mattvenn/gf-433-oscillator/docs/schematics.md

# Schematics



The VCO as real xschem schematics, generated from Python in `xschem/gen/` (one generator per block, `python3 xschem/gen/all.py` rebuilds them all). Every size and multiplicity is read from `sim/vco/vco_bias.py`'s `netlist()` at the chosen design, so the schematics can't drift from what I simulated:

- the winner reference (`sim/results/2026-11-08/winner_sets.txt`) with lnw = 5.023 µm;
- plus `topo=cfed kc=0.75 k=6 cvg=3e-12 ka=16 wfu=0.30 wff=0.30 rf=1e6 cf=20e-12`.

Click a schematic to open it in the online xschem viewer, or a layout to open it in the Tiny Tapeout 3D GDS viewer. Previews (SVG and PNG, rendered headless by `xschem/gen/render.sh`) are in `docs/img/xschem/`.

| Block | Schematic | Layout (3D) | What it is |
|---|---|---|---|
| **Tile** `tt_um_mattvenn_gf433_vco` | – (LVS source from `lvs/make_source.py`) | [tt_um_mattvenn_gf433_vco.gds](https://gds-viewer.tinytapeout.com/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) | the 2x2 Tiny Tapeout tile: vco_top, tx_drv and the wrapper routes |
| vco_top | [vco_top](https://xschem-viewer.com/?file=https://github.com/mattvenn/gf-433-oscillator/blob/main/xschem/vco_top.sch) | [vco_top.gds](https://gds-viewer.tinytapeout.com/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) | the VCO as laid out: ring_core_v3 + cgm_ref + lsdiv + the VDD_LS decap |
| mdac | [mdac](https://xschem-viewer.com/?file=https://github.com/mattvenn/gf-433-oscillator/blob/main/xschem/mdac.sch) | [mdac.gds](https://gds-viewer.tinytapeout.com/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) | medium DAC for fine tuning: 5 unary + 5 binary + the sigma-delta cell, PMOS current steering onto vg (docs/tx_fine_tune.md) |
| vctrl_pd | – (one resistor, in `lvs/make_source.py`) | [vctrl_pd.gds](https://gds-viewer.tinytapeout.com/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) | 200 kΩ ppolyf_u_1k from vctrl to VSS: the fine leg is off unless ua[0] drives it |
| tx_fine (digital macro) | – (Verilog `src/tx_fine.v`) | [tx_fine.gds](https://gds-viewer.tinytapeout.com/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) | SPI register, FSK offset, sigma-delta, thermometer decode, ÷16 / ÷64 / ÷1024 and the ck gate (LibreLane) |
| vco_cfed | [vco_cfed](https://xschem-viewer.com/?file=https://github.com/mattvenn/gf-433-oscillator/blob/main/xschem/vco_cfed.sch) | – (laid out as vco_top) | the whole VCO as simulated in `vco_bias`, without lsdiv |
| cgm_ref | [cgm_ref](https://xschem-viewer.com/?file=https://github.com/mattvenn/gf-433-oscillator/blob/main/xschem/cgm_ref.sch) | [cgm_ref.gds](https://gds-viewer.tinytapeout.com/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) | constant-gm reference and the 1 MΩ / 20 pF filter |
| ring_core_v3 | [ring_core_v3](https://xschem-viewer.com/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) | [ring_core_v3.gds](https://gds-viewer.tinytapeout.com/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) | ring + DAC + vg decap |
| ↳ cfed_ring | [cfed_ring](https://xschem-viewer.com/?file=https://github.com/mattvenn/gf-433-oscillator/blob/main/xschem/cfed_ring.sch) | in [ring_core_v3](https://gds-viewer.tinytapeout.com/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) | the 5 inverters |
| ↳ cfed_dac | [cfed_dac](https://xschem-viewer.com/?file=https://github.com/mattvenn/gf-433-oscillator/blob/main/xschem/cfed_dac.sch) | in [ring_core_v3](https://gds-viewer.tinytapeout.com/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) | the coarse current DAC and the fine leg |
| lsdiv | [lsdiv](https://xschem-viewer.com/?file=https://github.com/mattvenn/gf-433-oscillator/blob/main/xschem/lsdiv.sch) | [lsdiv.gds](https://gds-viewer.tinytapeout.com/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) | level shifter, TSPC ÷4 and clock buffer |
| ↳ ls_ac | [ls_ac](https://xschem-viewer.com/?file=https://github.com/mattvenn/gf-433-oscillator/blob/main/xschem/ls_ac.sch) | in [lsdiv](https://gds-viewer.tinytapeout.com/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) | the AC-coupled level shifter |
| ↳ tspc_t1, tspc_t2 | [tspc_t1](https://xschem-viewer.com/?file=https://github.com/mattvenn/gf-433-oscillator/blob/main/xschem/tspc_t1.sch), [tspc_t2](https://xschem-viewer.com/?file=https://github.com/mattvenn/gf-433-oscillator/blob/main/xschem/tspc_t2.sch) | in [lsdiv](https://gds-viewer.tinytapeout.com/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) | TSPC ÷2 flip-flops |
| tx_drv | [tx_drv](https://xschem-viewer.com/?file=https://github.com/mattvenn/gf-433-oscillator/blob/main/xschem/tx_drv.sch) | [tx_drv.gds](https://gds-viewer.tinytapeout.com/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) | the dipole TX driver |
| ↳ tx_split, tx_arm | [tx_split](https://xschem-viewer.com/?file=https://github.com/mattvenn/gf-433-oscillator/blob/main/xschem/tx_split.sch), [tx_arm](https://xschem-viewer.com/?file=https://github.com/mattvenn/gf-433-oscillator/blob/main/xschem/tx_arm.sch) | in [tx_drv](https://gds-viewer.tinytapeout.com/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) | phase splitter; one output arm |
| pad_model_gf180 | [pad_model_gf180](https://xschem-viewer.com/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) | – (TT's pin, not our layout) | one TT GF180 analog pin, for simulation |
| ↳ tt_asw_5v0, lv2hv | [tt_asw_5v0](https://xschem-viewer.com/?file=https://github.com/mattvenn/gf-433-oscillator/blob/main/xschem/tt_asw_5v0.sch), [lv2hv](https://xschem-viewer.com/?file=https://github.com/mattvenn/gf-433-oscillator/blob/main/xschem/lv2hv.sch) | – | tnt's analog switch and its level shifter, redrawn |

## Block details

- **vco_top**: the VCO top level as laid out in `layout/vco_top.gds`, and the LVS source of `layout/gen/check_top.sh`. ring_core_v3 driven by cgm_ref (vbnf to the DAC gate), lsdiv on a0 with its own supply VDD_LS, and the VDD_LS decap DCLS (nfet_03v3 gate cap, sized as drawn by `layout/gen/vco_top.py`). Ports: VDD, VDD_LS, VSS, vctrl, bit0-4, bitb0-4, ck (a0 / 4), a0, vbn (monitor), vg (monitor) and ls (the TX driver's tap).
- [vco_cfed](https://xschem-viewer.com/?file=https://github.com/mattvenn/gf-433-oscillator/blob/main/xschem/vco_cfed.sch): the whole VCO - the constant-gm reference drives the ring core through the 1 MΩ / 20 pF filter (vbnf).
- [cgm_ref](https://xschem-viewer.com/?file=https://github.com/mattvenn/gf-433-oscillator/blob/main/xschem/cgm_ref.sch): the constant-gm (beta-multiplier) reference - MN1/MN2 as 14 × 14 series-parallel arrays (each drawn as one vector instance), the 56/14 µm PMOS mirror, the n-well + n+ resistor, the 3-transistor start-up and the RC filter to vbnf.
- [ring_core_v3](https://xschem-viewer.com/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): the ring, the DAC and the vg decap (pfet_03v3 to VDD, 6 × 29.82/4.12 µm, as drawn in the layout; nfet_03v3 to VSS before 2026-11-12). This is the cell in `layout/ring_core_v3.gds`, so it can be its LVS source.
- [cfed_ring](https://xschem-viewer.com/?file=https://github.com/mattvenn/gf-433-oscillator/blob/main/xschem/cfed_ring.sch): the 5 inverters (P 5/0.28 µm, N 2/0.28 µm). Every NMOS source sits on the shared node vg.
- [cfed_dac](https://xschem-viewer.com/?file=https://github.com/mattvenn/gf-433-oscillator/blob/main/xschem/cfed_dac.sch): the current DAC from vg to VSS - the base leg (× 6 units), the binary coarse legs (× 1 to × 16), the fine leg on vctrl, and the 5 coarse gate switches. Each switch is drawn as a textbook transmission gate standing upright (TP and TN side by side, vbnf in at the top, the gates in from the sides: bitb with its bubble on the left, bit on the right) that connects the leg's gate to vbnf when the bit is 1, plus the pull-down TD that holds the gate at VSS when the bit is 0.
- [lsdiv](https://xschem-viewer.com/?file=https://github.com/mattvenn/gf-433-oscillator/blob/main/xschem/lsdiv.sch): the a0 level shifter, the TSPC ÷4 and the clock buffer B1 (ck = f(a0) / 4, full rail). Source: `sim/lsdiv/lsdiv.py block()`; design in `docs/lsdiv_design.md`.
  - [ls_ac](https://xschem-viewer.com/?file=https://github.com/mattvenn/gf-433-oscillator/blob/main/xschem/ls_ac.sch): Cc (2 fF metal-finger cap, drawn as an ideal C) into INV1-3; R1 / C1 low-pass the output back to INV1's input through LRB (negative DC feedback, duty about 50 %).
  - [tspc_t1](https://xschem-viewer.com/?file=https://github.com/mattvenn/gf-433-oscillator/blob/main/xschem/tspc_t1.sch) and [tspc_t2](https://xschem-viewer.com/?file=https://github.com/mattvenn/gf-433-oscillator/blob/main/xschem/tspc_t2.sch): TSPC toggle flip-flops (÷2 each), 1/2 µm and 0.6/1.2 µm.
- [tx_drv](https://xschem-viewer.com/?file=https://github.com/mattvenn/gf-433-oscillator/blob/main/xschem/tx_drv.sch): the dipole TX driver - lsdiv's `ls` node into the phase splitter, then two arms in antiphase (out_p, out_n), each with its own enable, plus the supply decap DC. VDD here is the driver's own supply (VDPWR). Source: `sim/tx/tx_drv.py block()`. Sizes from the block sims (`sim/tx/tb_tx_drv.py`, results in `sim/tx/results/block_sch.txt`): the final stage at the knee of P into the dipole against supply current, B1 tuned for a fundamental phase error of about 0.05° at tt, and a decap of about 9.8 pF. Devices wider than 10 µm are drawn as m fingers of at most 10 µm (the models stop at W 100 µm).
  - [tx_split](https://xschem-viewer.com/?file=https://github.com/mattvenn/gf-433-oscillator/blob/main/xschem/tx_split.sch): the tap inverter T (the only load on `ls`), then a = A2(A1(t)) and b = TG(B1(t)): one path has two inverters, the other one inverter and an always-on transmission gate that stands in for the second inverter's delay. A weak cross-coupled pair (XA / XB) pulls the two edges together.
  - [tx_arm](https://xschem-viewer.com/?file=https://github.com/mattvenn/gf-433-oscillator/blob/main/xschem/tx_arm.sch): one arm, out = in & en: a NAND2, then 5 inverters tapering ×4 up to the output stage (N 40 / P 100 µm, L 0.28). en = 0 holds out low, so with both arms off there is no DC across the dipole. Ported from ook-asic-radio's `tx_drv` onto 3.3 V devices.
- [pad_model_gf180](https://xschem-viewer.com/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): one TT GF180 analog pin, board pin to `ua[]` (`docs/pad_model.md`). Generated by `xschem/gen/pad_model.py`, checked by `sim/pad/check_xsch.py` (simulation against `sim/pad/pad_model_gf180.spice`).
  - [tt_asw_5v0](https://xschem-viewer.com/?file=https://github.com/mattvenn/gf-433-oscillator/blob/main/xschem/tt_asw_5v0.sch) and [lv2hv](https://xschem-viewer.com/?file=https://github.com/mattvenn/gf-433-oscillator/blob/main/xschem/lv2hv.sch): tnt's analog switch and its level shifter, redrawn.

## Notes
- **GF180 symbols:** the viewer only knows the xschem, sky130 and IHP libraries. So I copied the 5 PDK symbols I use into `xschem/symbols/` (from open_pdks 7b70722e). The schematics reference them as `symbols/nfet_03v3.sym`, the same name xschem finds in the PDK, and the viewer finds them next to the `.sch`.
- **Filter resistor:** RF is `ppolyf_u_1k`, 1 × 970 µm for 1 MΩ: the run's hi-res poly is 1 kΩ/sq (`docs/platform.md`). It was ppolyf_u_3k (1 × 318 µm) before 2026-11-08.
- **Ideal parts:** the 20 pF filter cap is ideal (`devices/capa.sym`), the same as in `vco_bias`. On silicon it will be a MOS cap, which isn't laid out yet.
- **What isn't drawn:** vco_bias's 1 Ω `Rvbn`, which only gives n1 the name vbn, is just the net vbn here. The wiring caps `Cw*` are left out too.
- **The bit buses:** they are separate pins (bit0…bit4, bitb0…bitb4), so the names match the layout's pins.

## Checks (`python3 xschem/gen/check.py`, results in `build/xsch/check.txt`)
Every `.sch` is netlisted headless with xschem (`xschem/gen/netlist.sh`) and compared with netgen, using the gf180mcuD setup:
- **ring_core_v3 against the layout's LVS source:** it matches uniquely with no property errors. I checked it at wfu 0.30 against `layout/gen/export_core_v3.py` and against the committed `layout/ref/ring_core_v3.spice`.
- **The layout against ring_core_v3:** this netlist is the LVS source of `layout/ring_core_v3.gds` (`layout/gen/check_v3.sh`). It matches uniquely with no property errors, and three deliberately broken copies (one DAC leg's m, one switch gate, the decap's S/D on VSS) all fail.
- **vco_cfed against `vco_bias.netlist()`:** it matches uniquely with no property errors (70 devices). netgen treats the PDK resistors as black boxes and doesn't compare their sizes, so a device-by-device size diff covers every W/L/m, resistor W/L and C value. It finds no differences.
- **lsdiv against `lsdiv.py block()`:** it matches uniquely (34 devices), and the device-by-device size diff finds no differences. A copy with R1 10 % longer fails the size diff, as it should (netgen alone would miss it).
- **tx_drv against `sim/tx/tx_drv.py block()`:** it matches uniquely, hierarchy and all (tx_split, tx_arm, tx_drv), and the device-by-device size diff finds no differences (29 devices). The size diff now joins SPICE continuation lines: xschem wraps long device lines, and a wrapped `m=3` was being missed (netgen read it correctly). Two broken copies both fail: the output NMOS M5n 10 % narrower (netgen property error and the size diff), and TGn's gate on VSS instead of VDD (netgen: the netlists don't match).
- **Mutation test:** in a copy of cfed_dac.sch I changed the bit-3 leg from m = 8 to m = 7. All 3 comparisons fail on it, as they should.
- **Simulation:** I simulated vco_cfed from the xschem netlist at tt, 27 °C, code 9 and vctrl 1.65 V, with the same deck as vco_bias. It runs at 503.98 MHz, against 504.16 MHz for vco_bias (-0.036 %). Both draw 0.451 mW and both have vbn = 1.232 V. vco_bias here has its wiring caps off, so like for like.
- **Measurement threshold:** I measured the frequency at mid-swing, not at VDD/2. The cfed ring swings from vg (about 1.8 V) up to VDD, so a0 never crosses 1.65 V. That makes `vco_bias.deck()`'s VDD/2 measurement fail for cfed, and `topo_cmp.py` uses mid-swing too.

## Superseded
The layouts `layout/ring_core.gds` and `layout/ring_core_v2.gds` are earlier versions of ring_core_v3. These hand-drawn SVGs in `docs/schematic/` came before the xschem schematics. I've kept them, but the xschem files are the reference now:
- `ring_stage.svg`, `ring_loop.svg`, `ring_bias.svg` (with `ring_svg.py`)
- `dac_cfed.svg` (with `dac_svg.py`)
