mattvenn/gf-433-oscillator/bench/2026-11-09/raw/chip2/chip2_check.png

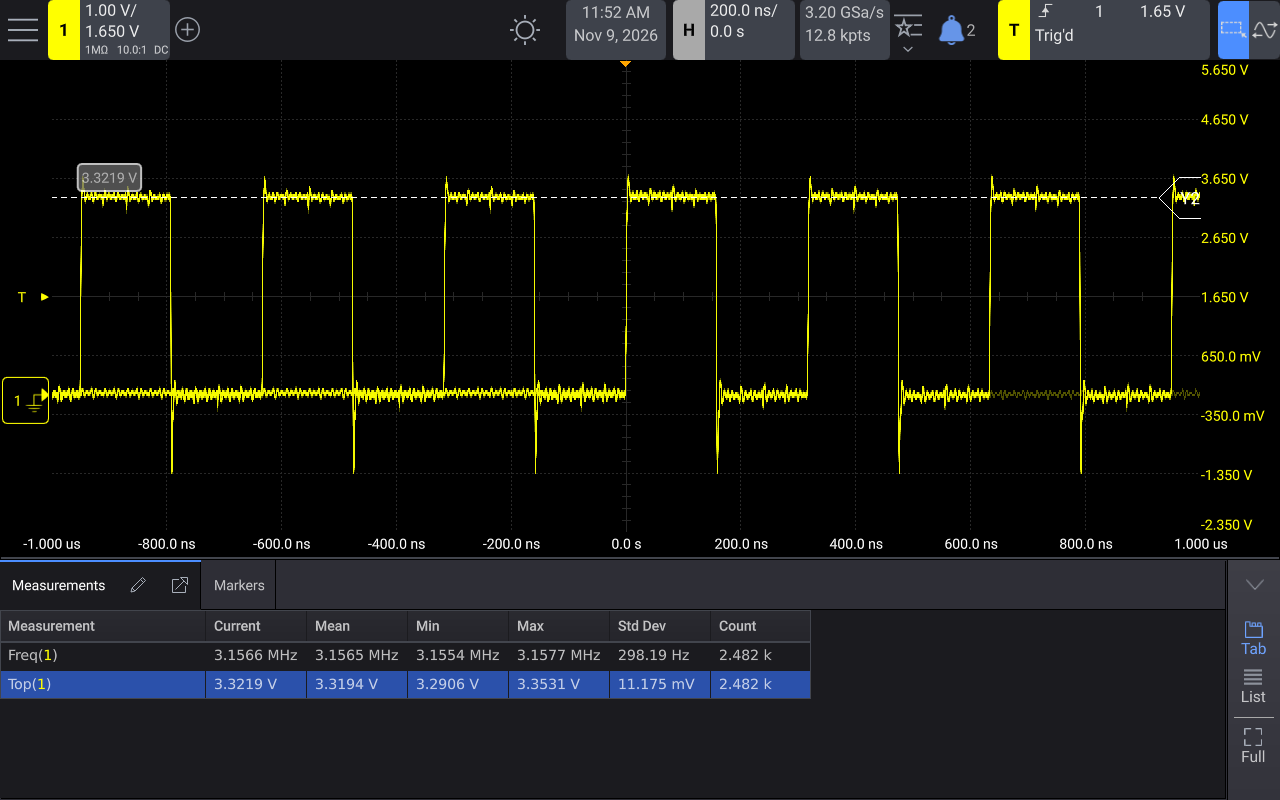
bench/2026-11-09/raw/chip2/chip2_check.png
