mattvenn/gf-433-oscillator/bench/2026-11-09/raw/d8_inv4x5.png

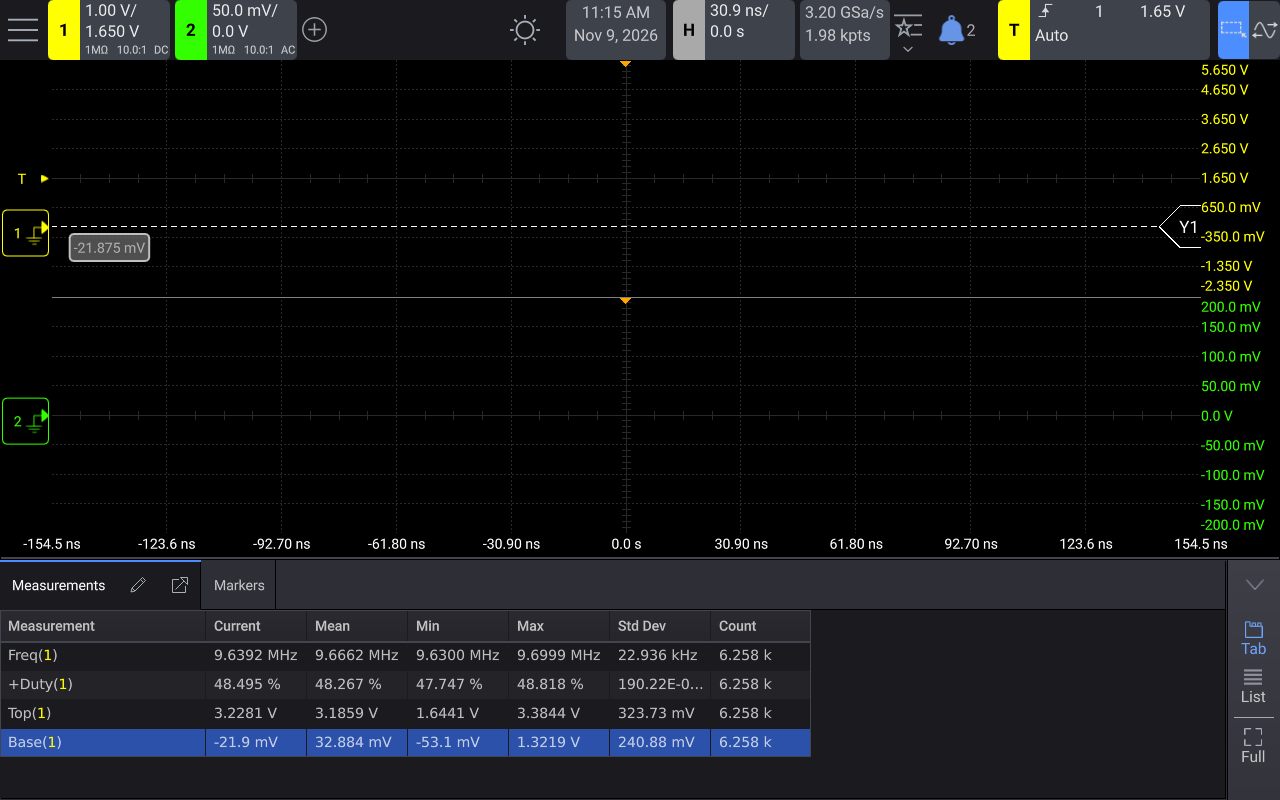
bench/2026-11-09/raw/d8_inv4x5.png
