mattvenn/gf-433-oscillator/bench/2026-11-09/raw/fin_inv4x5_0.png

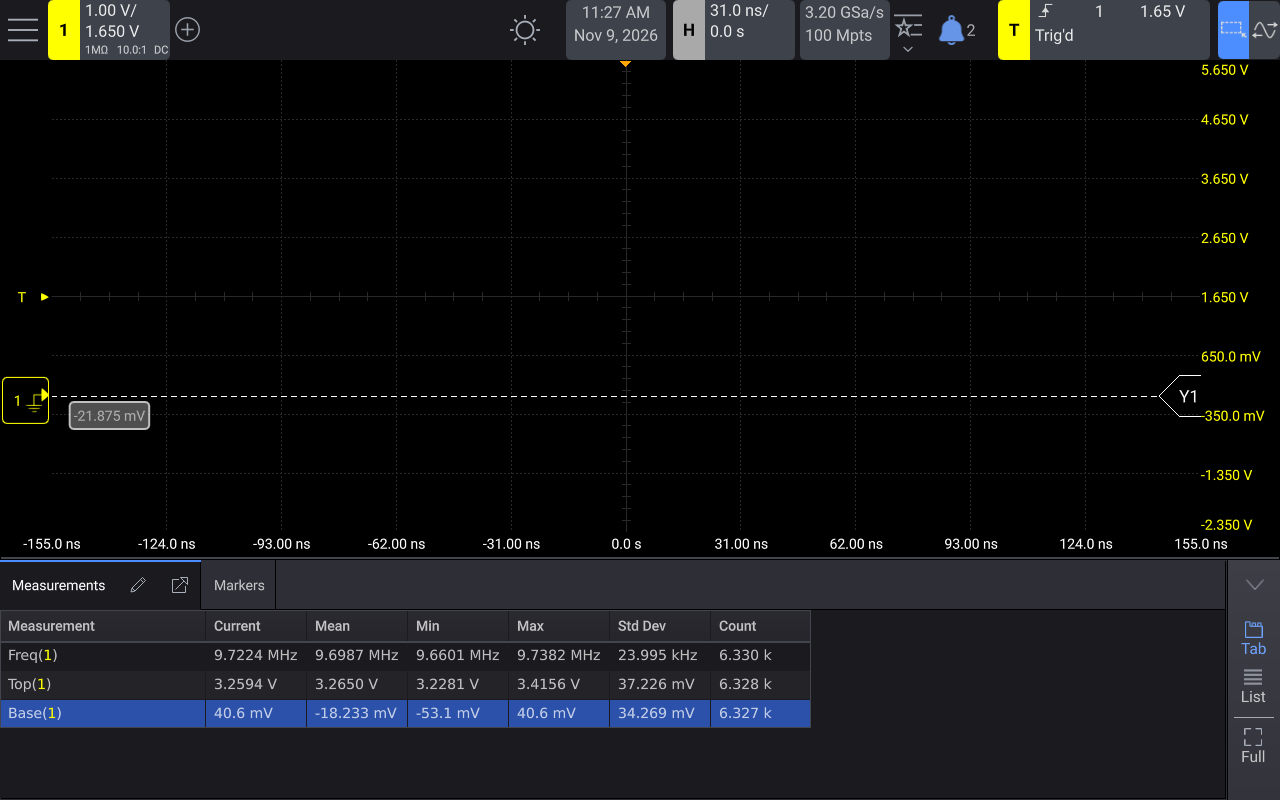
bench/2026-11-09/raw/fin_inv4x5_0.png
