mattvenn/gf-433-oscillator/bench/2026-11-09/raw/fin_notclk_0.png

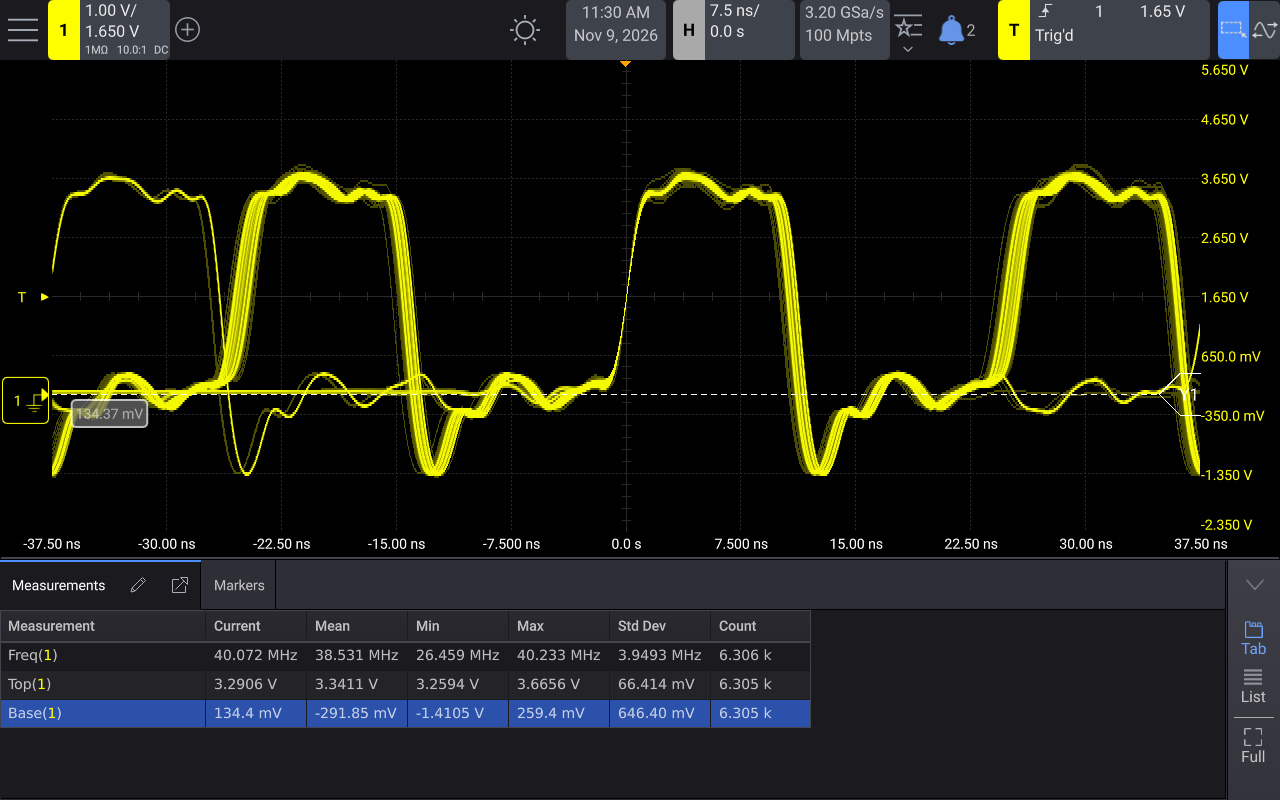
bench/2026-11-09/raw/fin_notclk_0.png
