mattvenn/gf-433-oscillator/bench/2026-11-09/raw/ref_13M56_frac.png

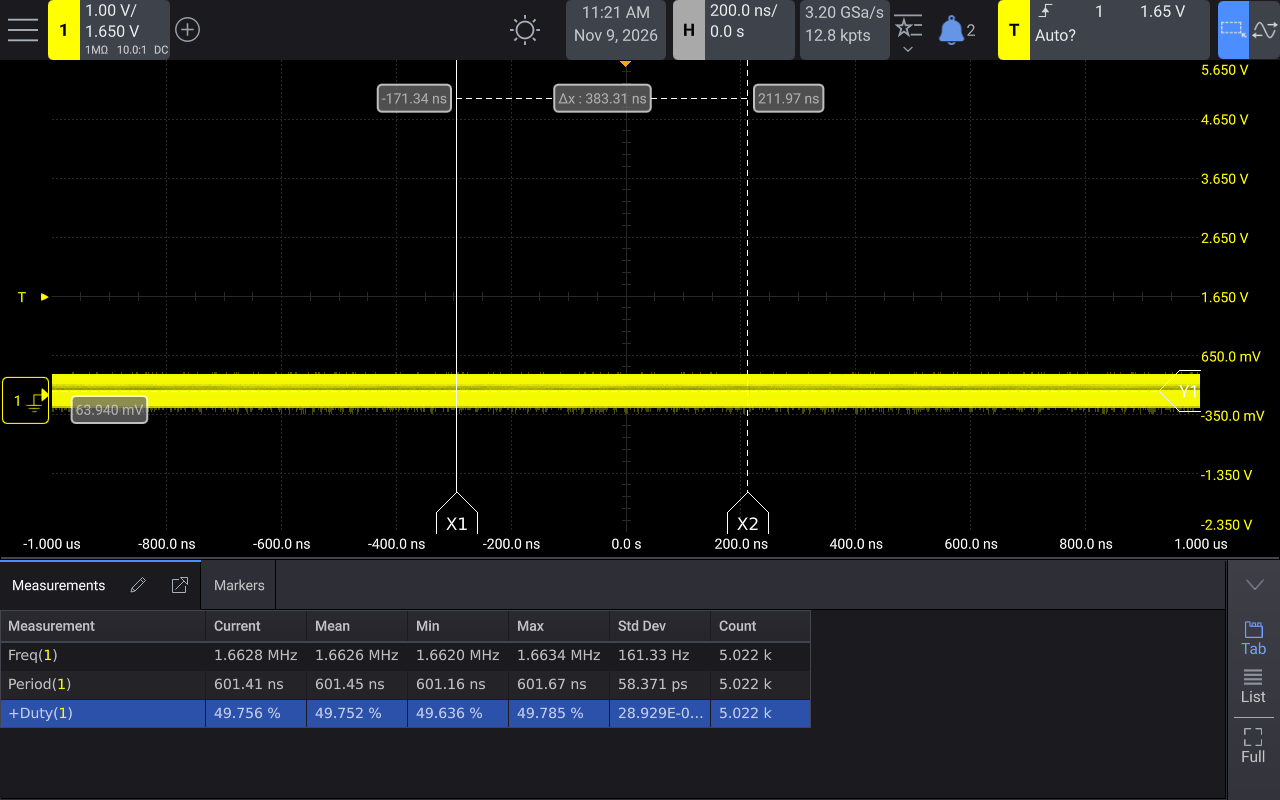
bench/2026-11-09/raw/ref_13M56_frac.png
