mattvenn/gf-433-oscillator/bench/2026-11-09/raw/ref_frac_13M6.png

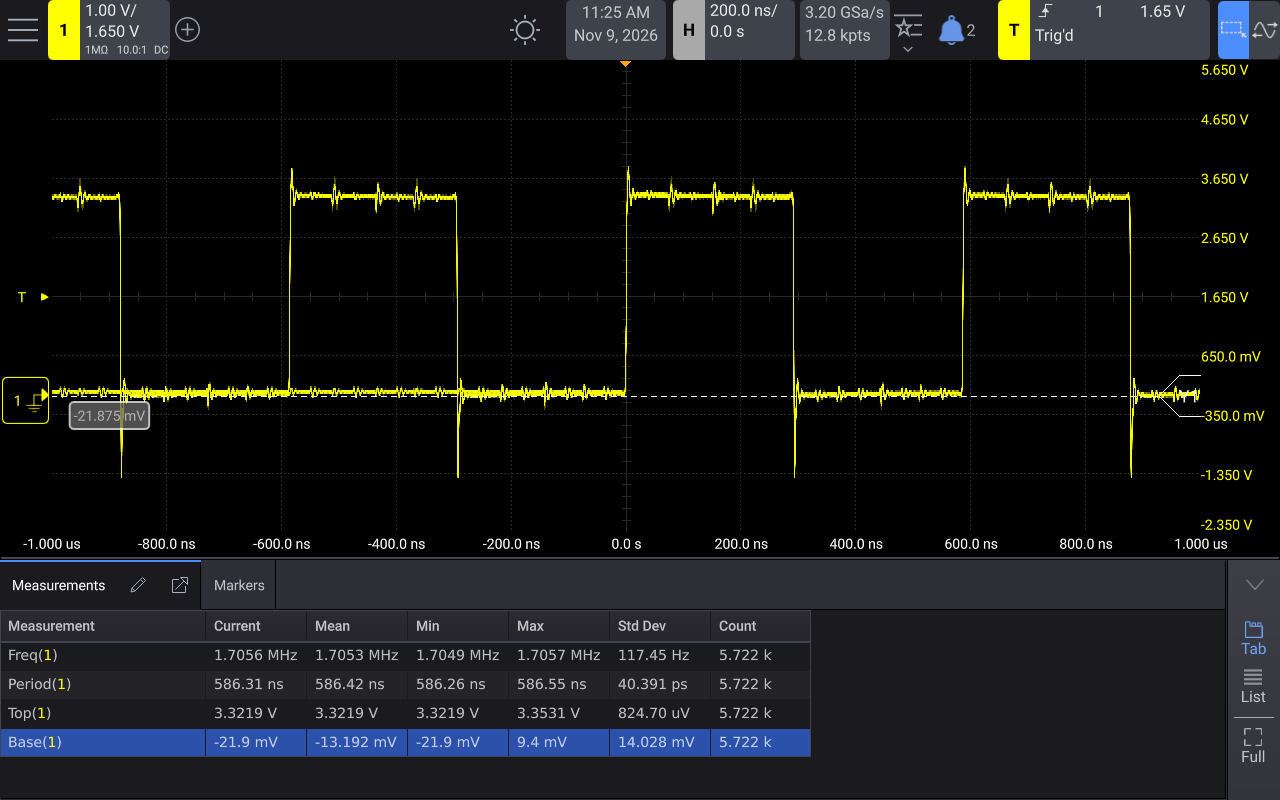
bench/2026-11-09/raw/ref_frac_13M6.png
