mattvenn/gf-433-oscillator/bench/2026-11-09/raw/ref_int_27M12.png

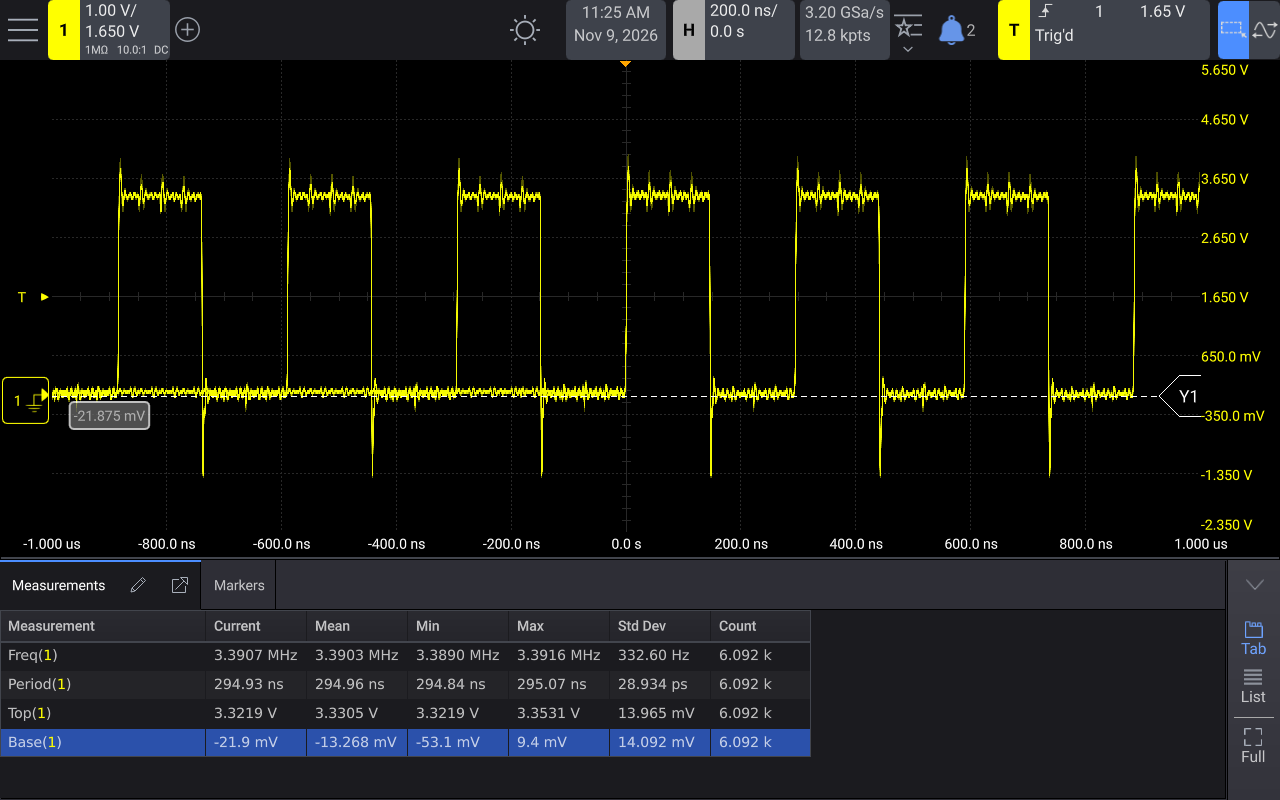
bench/2026-11-09/raw/ref_int_27M12.png
