mattvenn/gf-433-oscillator/bench/2026-11-09/raw/scope_floor_bw20.png

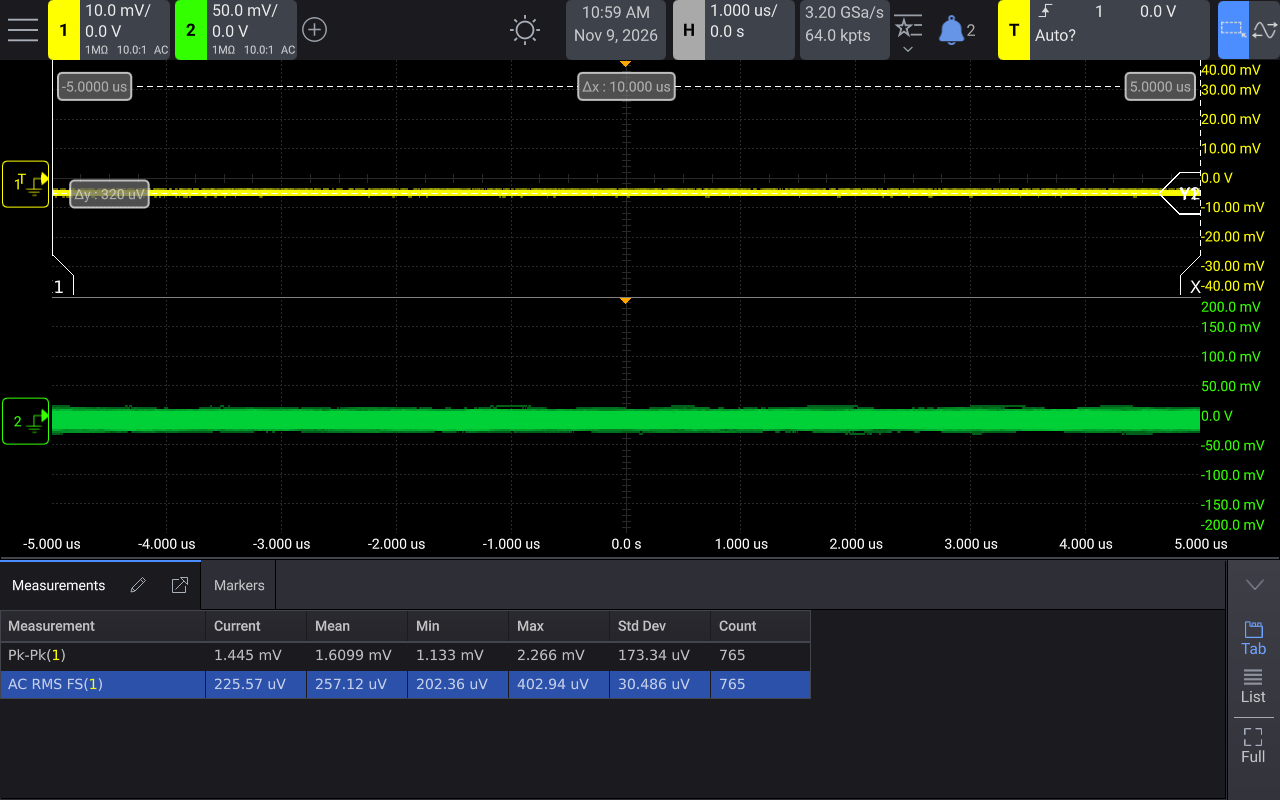
bench/2026-11-09/raw/scope_floor_bw20.png
