mattvenn/gf-433-oscillator/bench/2026-11-09/raw/scope_vdcore_ac.png

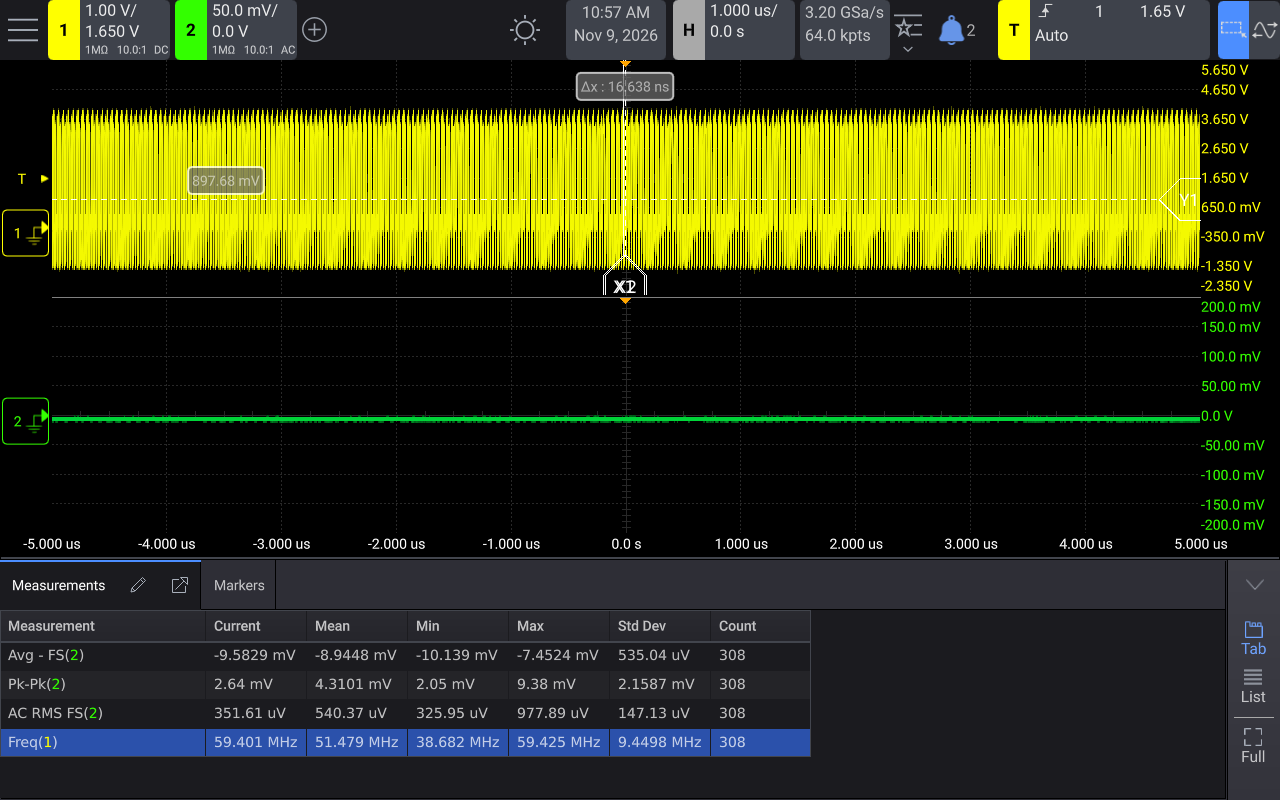
bench/2026-11-09/raw/scope_vdcore_ac.png
