mattvenn/gf-433-oscillator/docs/img/ring_core.png

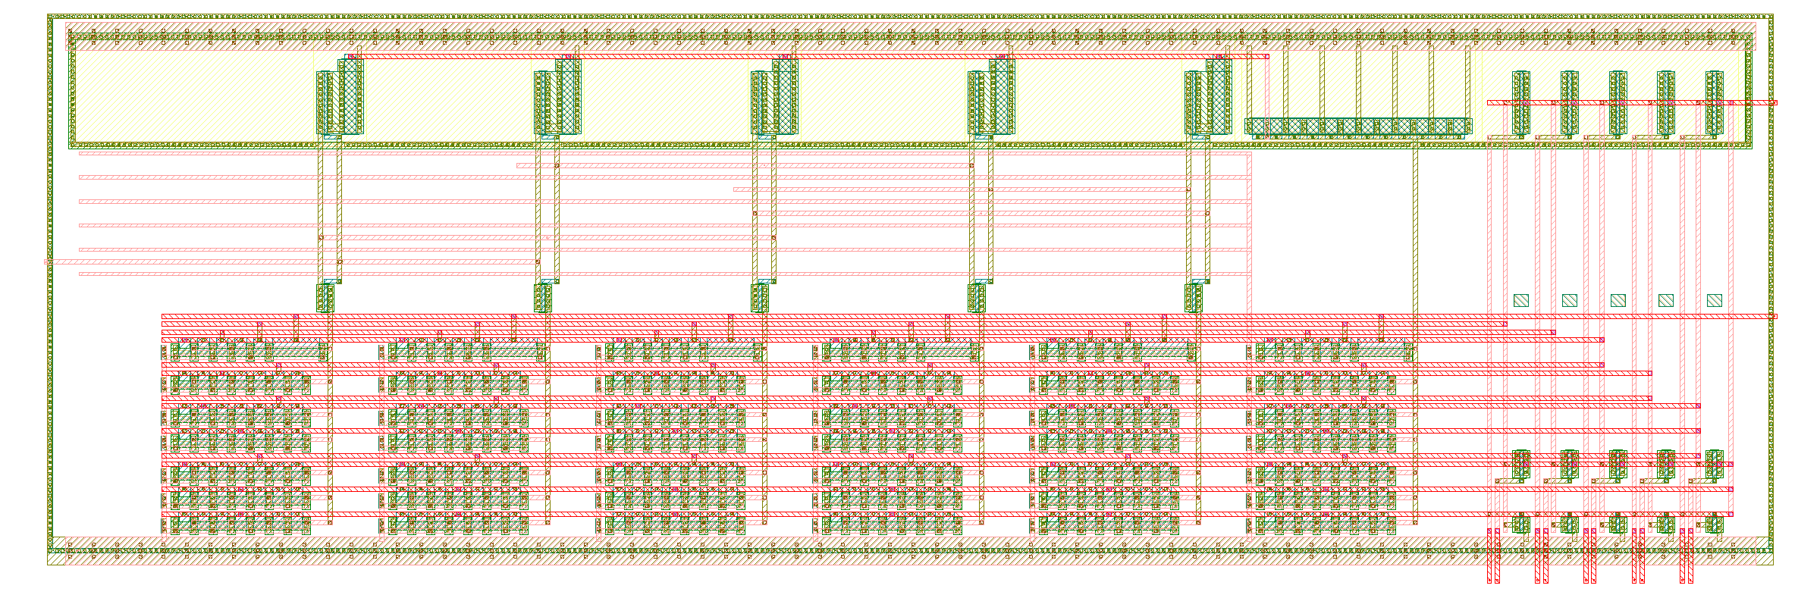
docs/img/ring_core.png
