mattvenn/gf-433-oscillator/docs/img/ring_core_v2.png

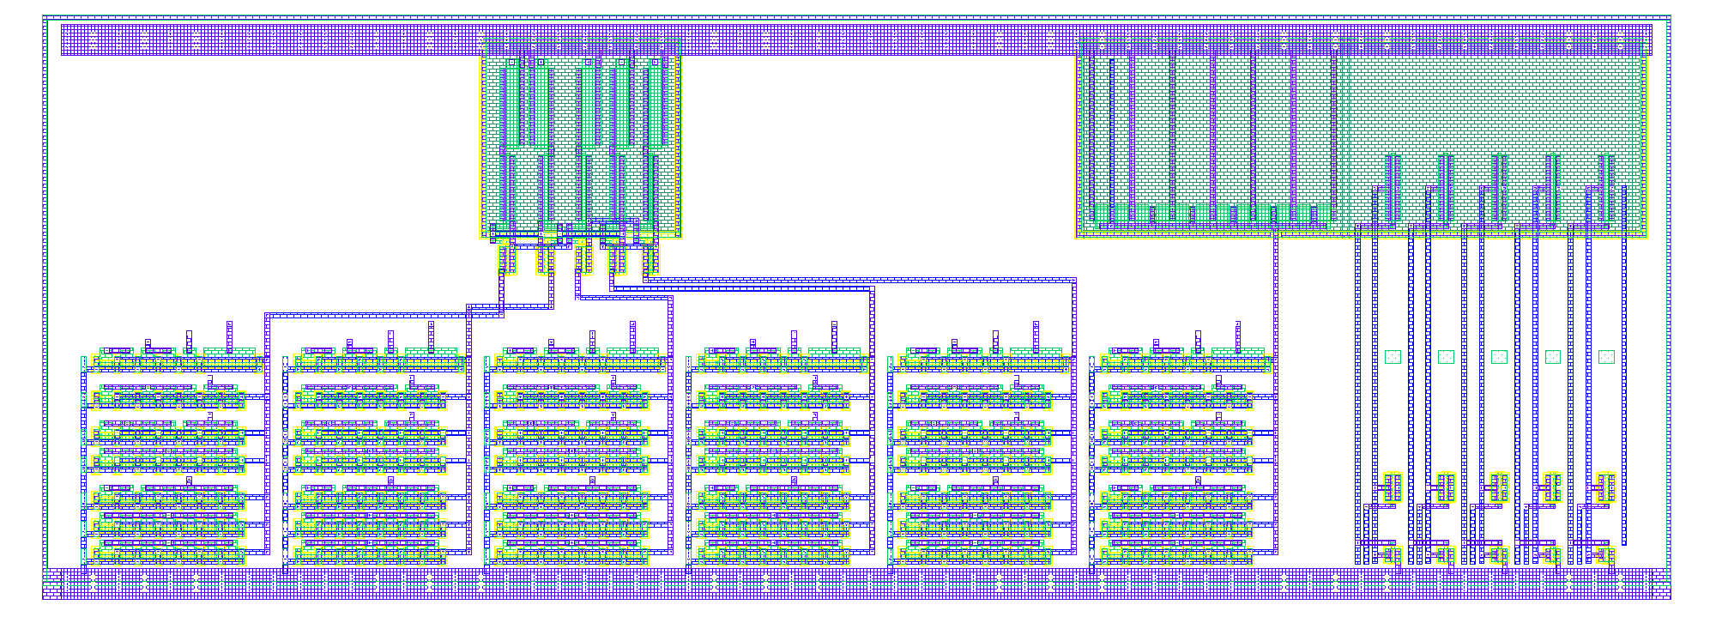
docs/img/ring_core_v2.png
