mattvenn/gf-433-oscillator/docs/img/xschem/cfed_dac.png

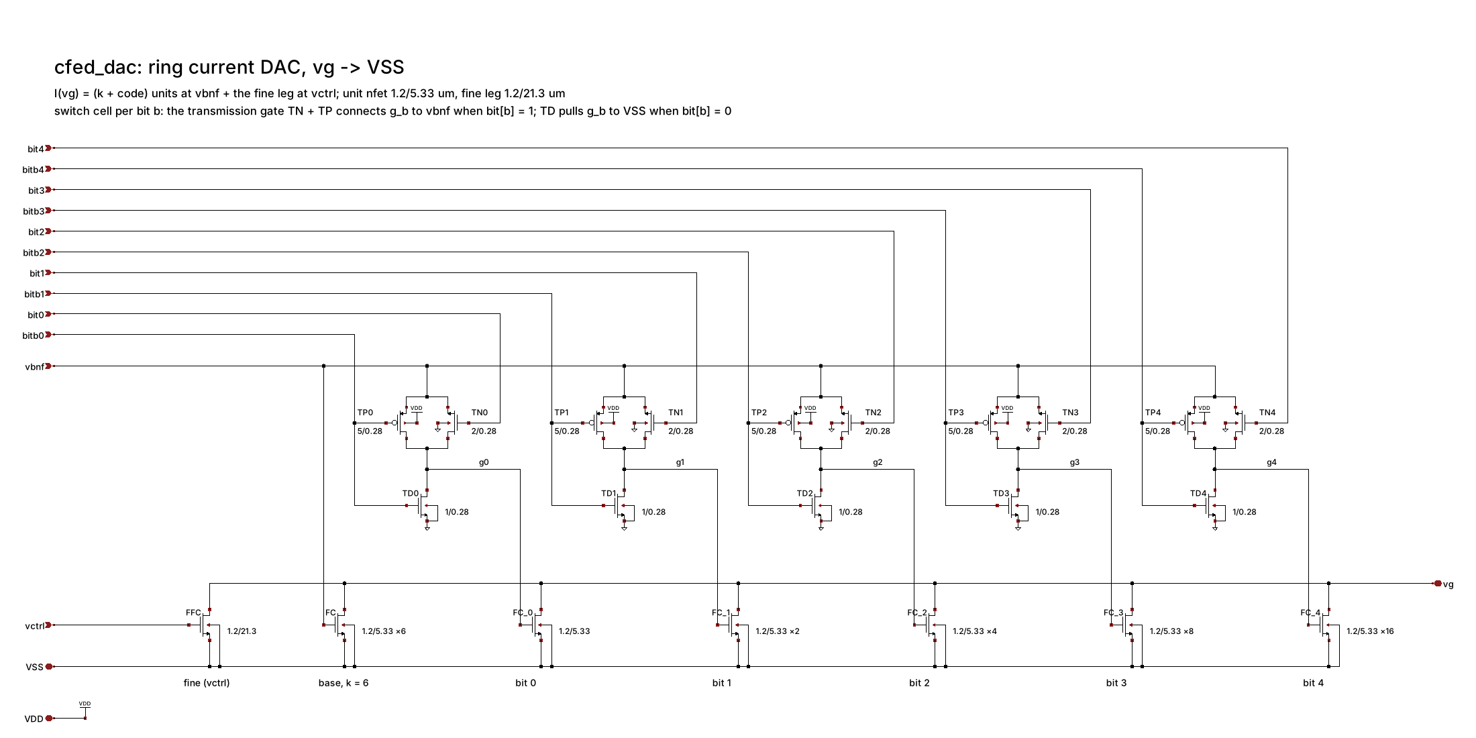
docs/img/xschem/cfed_dac.png
