mattvenn/gf-433-oscillator/docs/img/xschem/cfed_ring.png

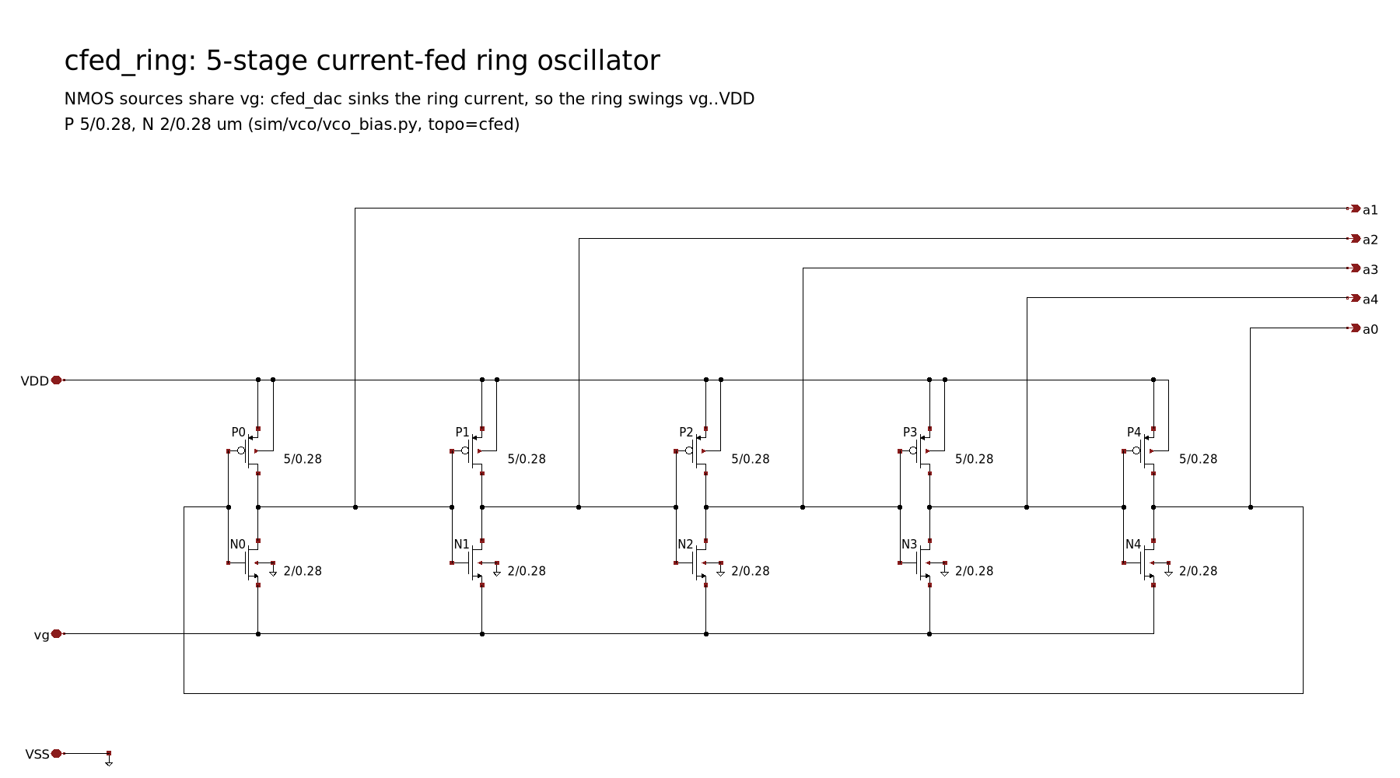
docs/img/xschem/cfed_ring.png
