mattvenn/gf-433-oscillator/docs/img/xschem/cgm_ref.png

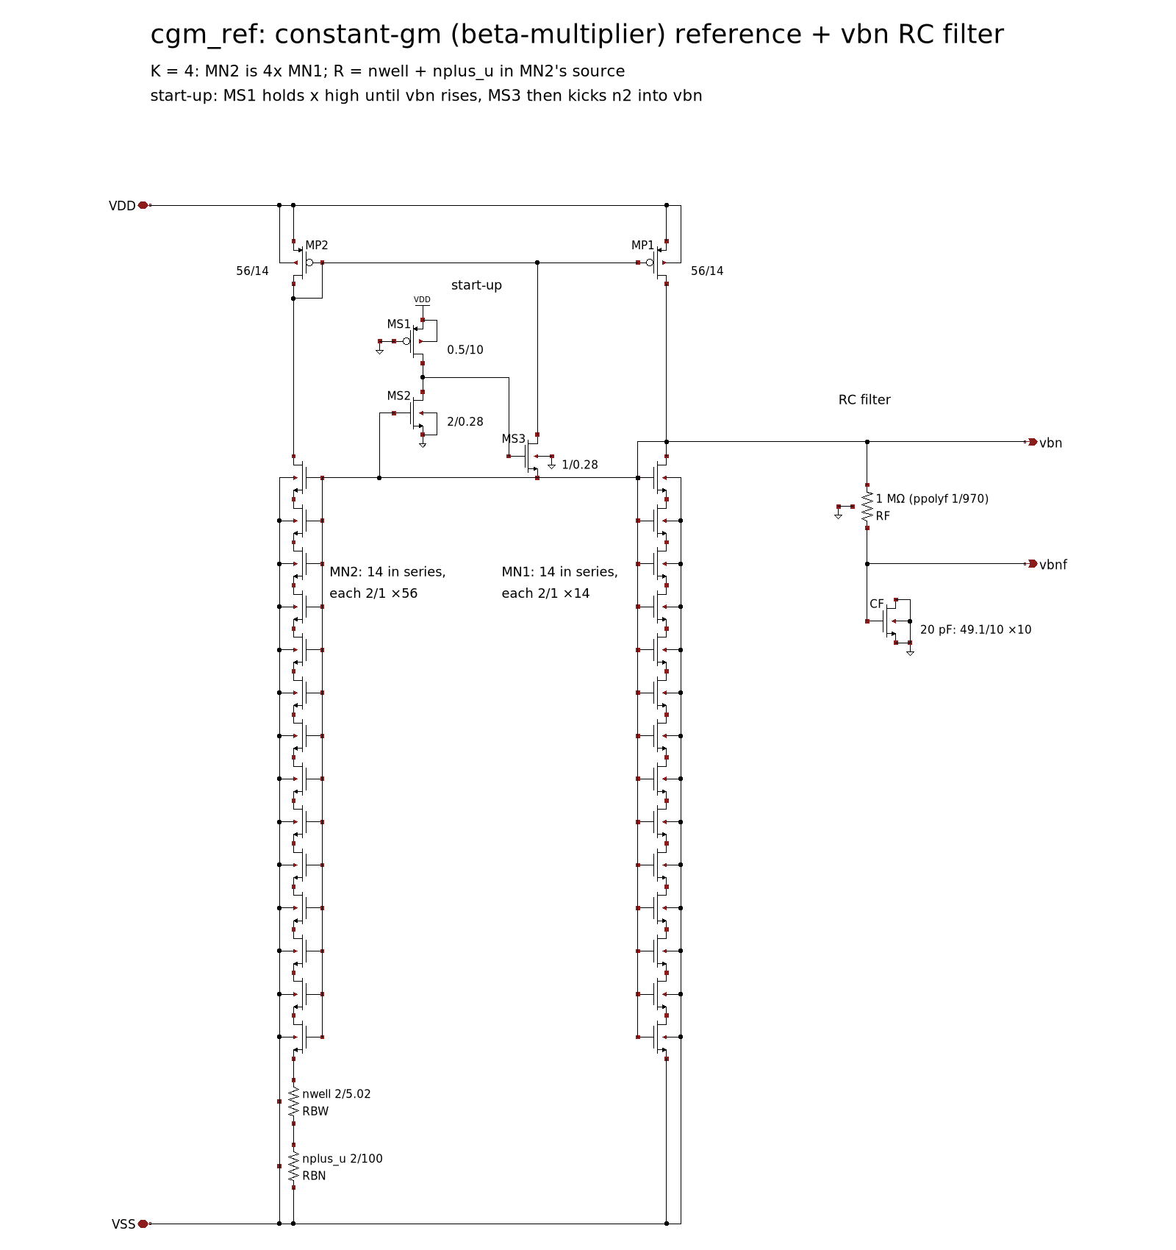
docs/img/xschem/cgm_ref.png
