mattvenn/gf-433-oscillator/docs/img/xschem/ls_ac.png

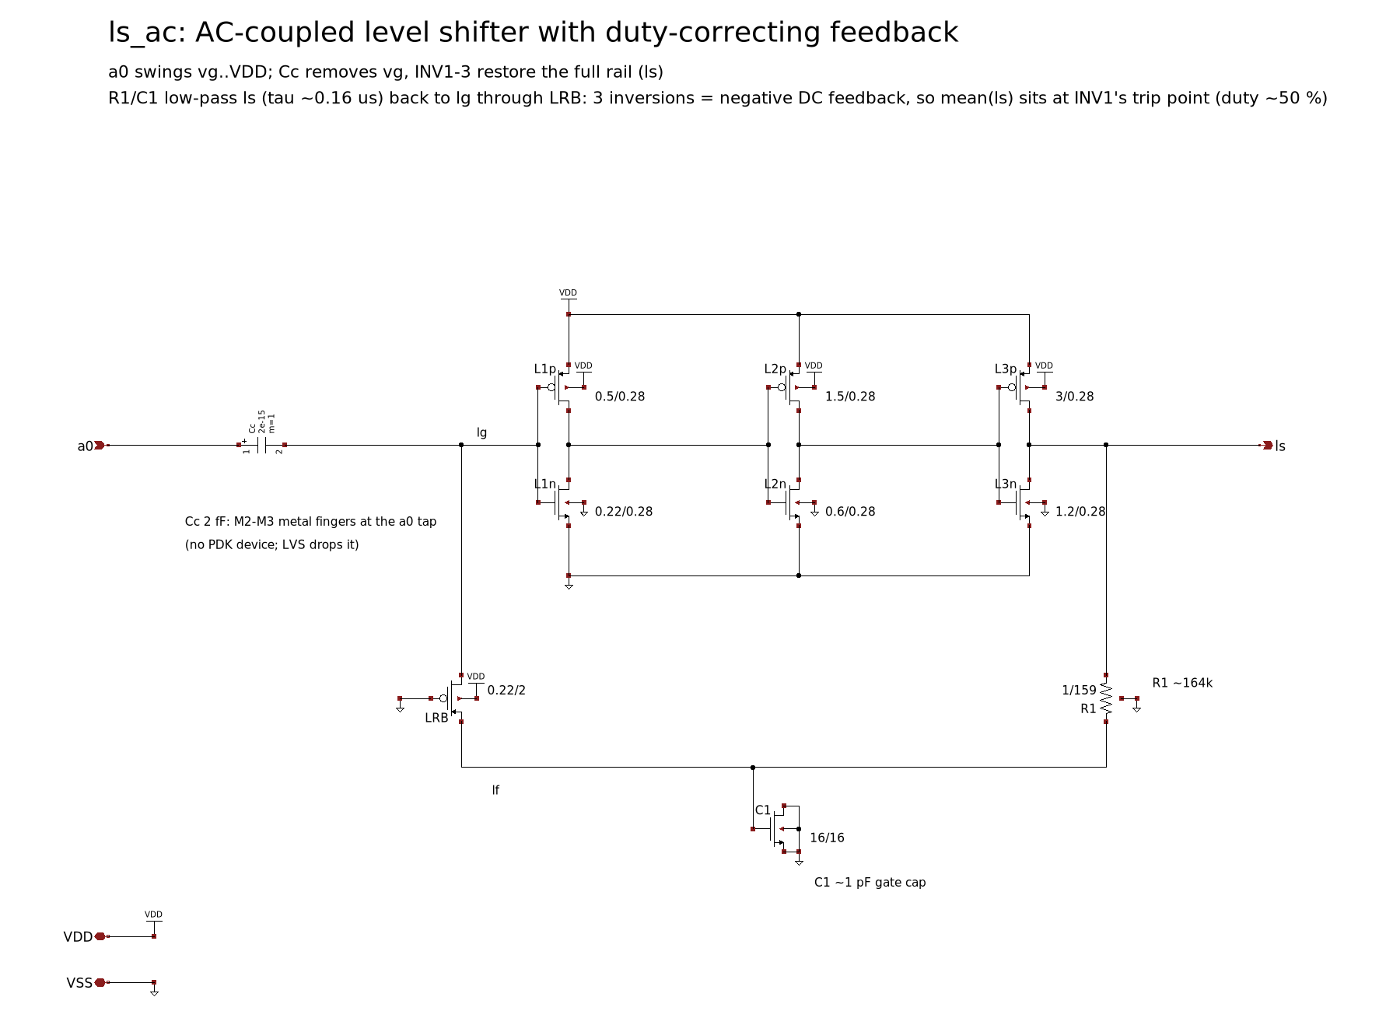
docs/img/xschem/ls_ac.png
