mattvenn/gf-433-oscillator/docs/img/xschem/lsdiv.png

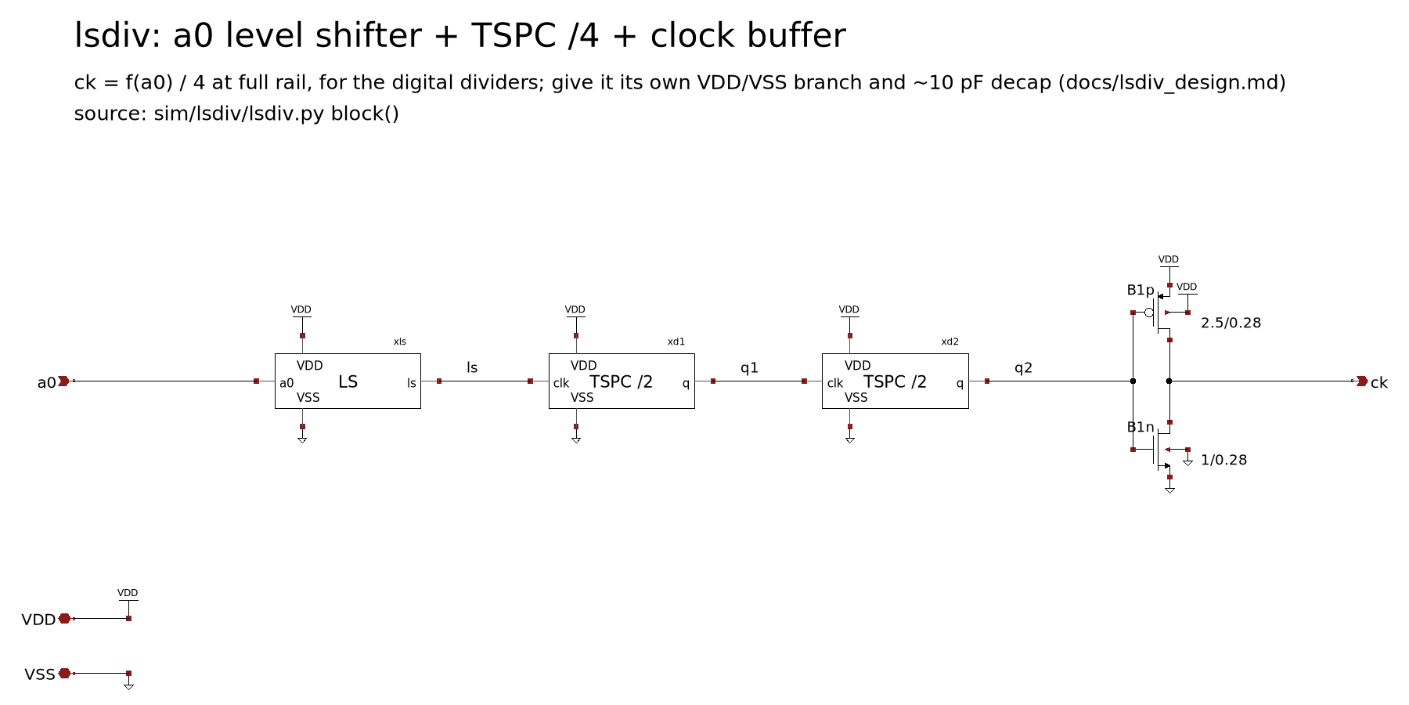
docs/img/xschem/lsdiv.png
