mattvenn/gf-433-oscillator/docs/img/xschem/lv2hv.png

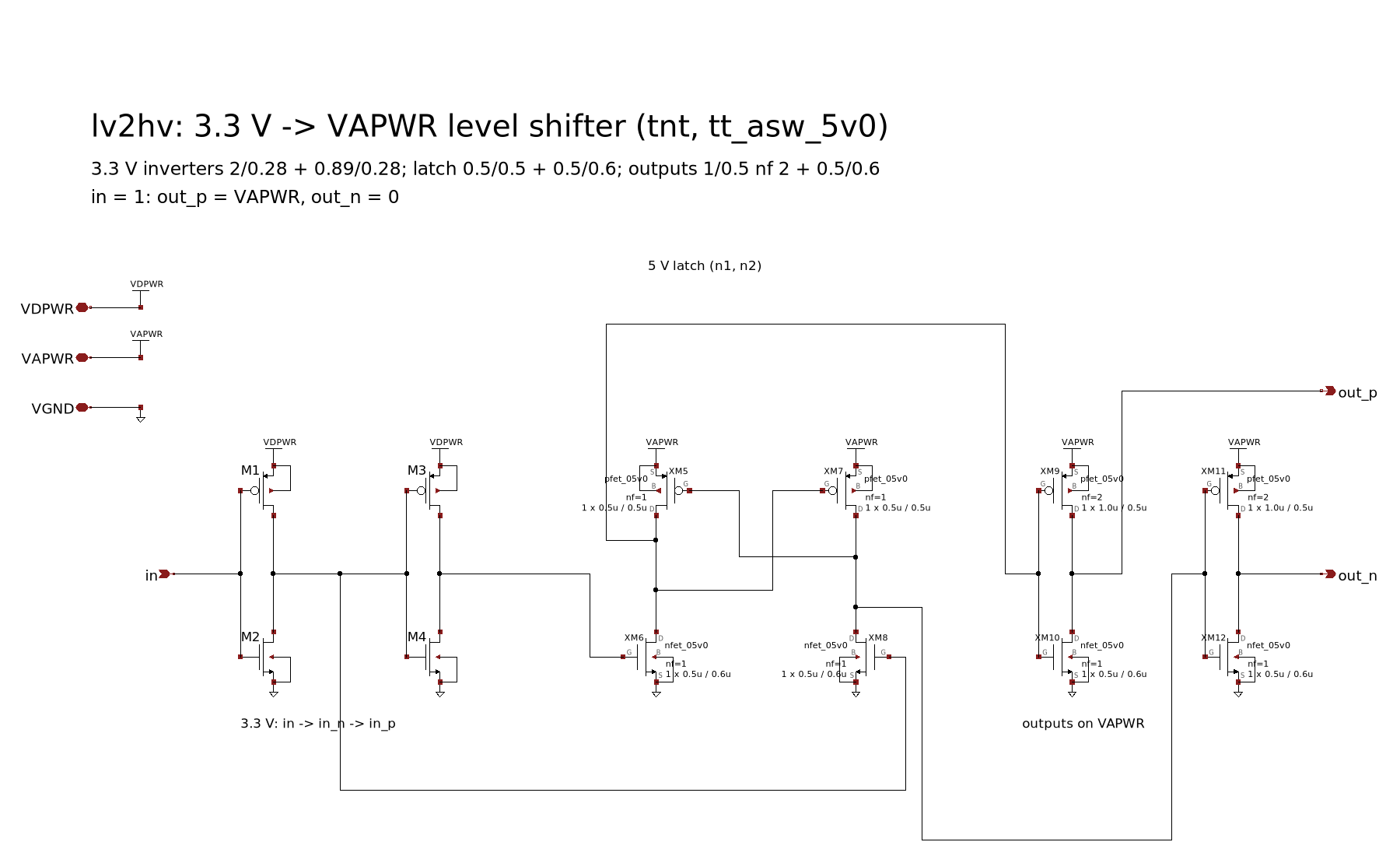
docs/img/xschem/lv2hv.png
