mattvenn/gf-433-oscillator/docs/img/xschem/pad_model_gf180.png

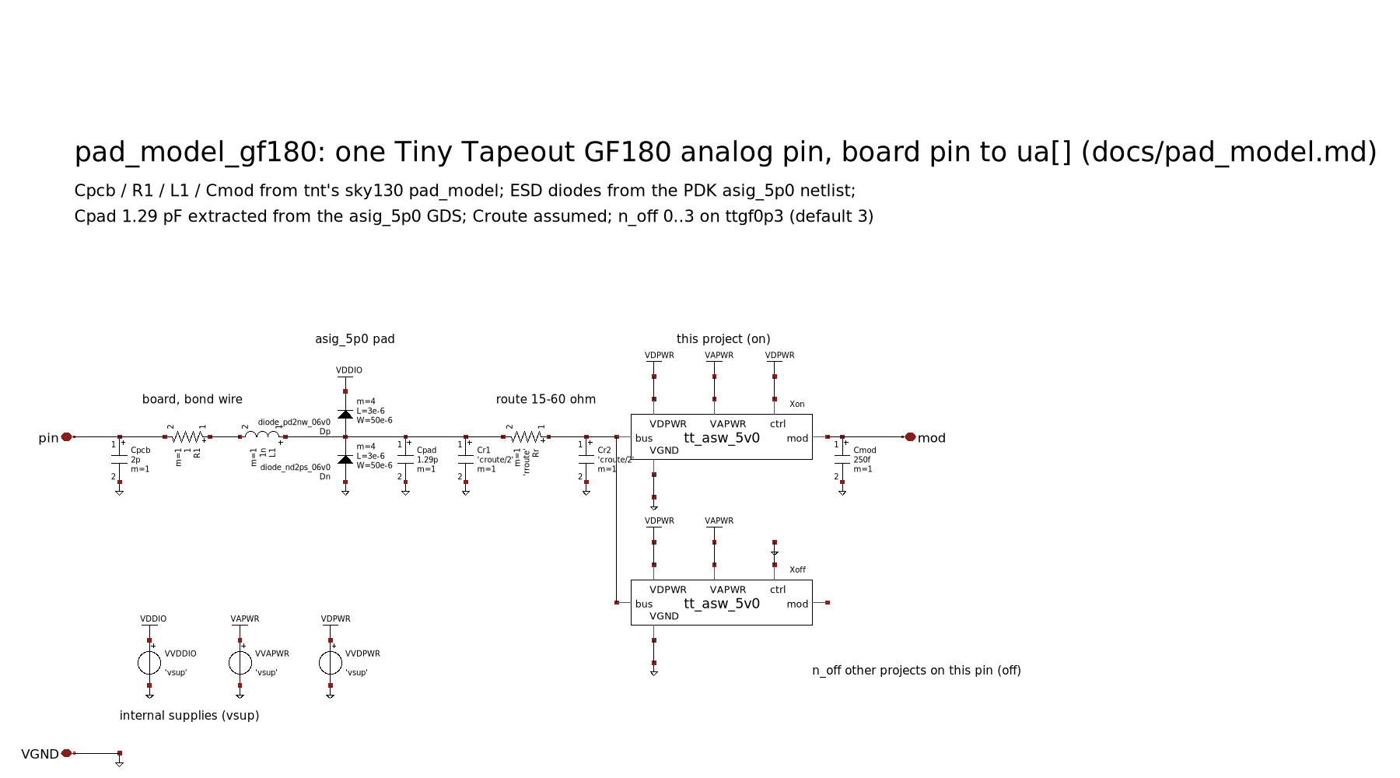
docs/img/xschem/pad_model_gf180.png
