mattvenn/gf-433-oscillator/docs/img/xschem/ring_core_v3.png

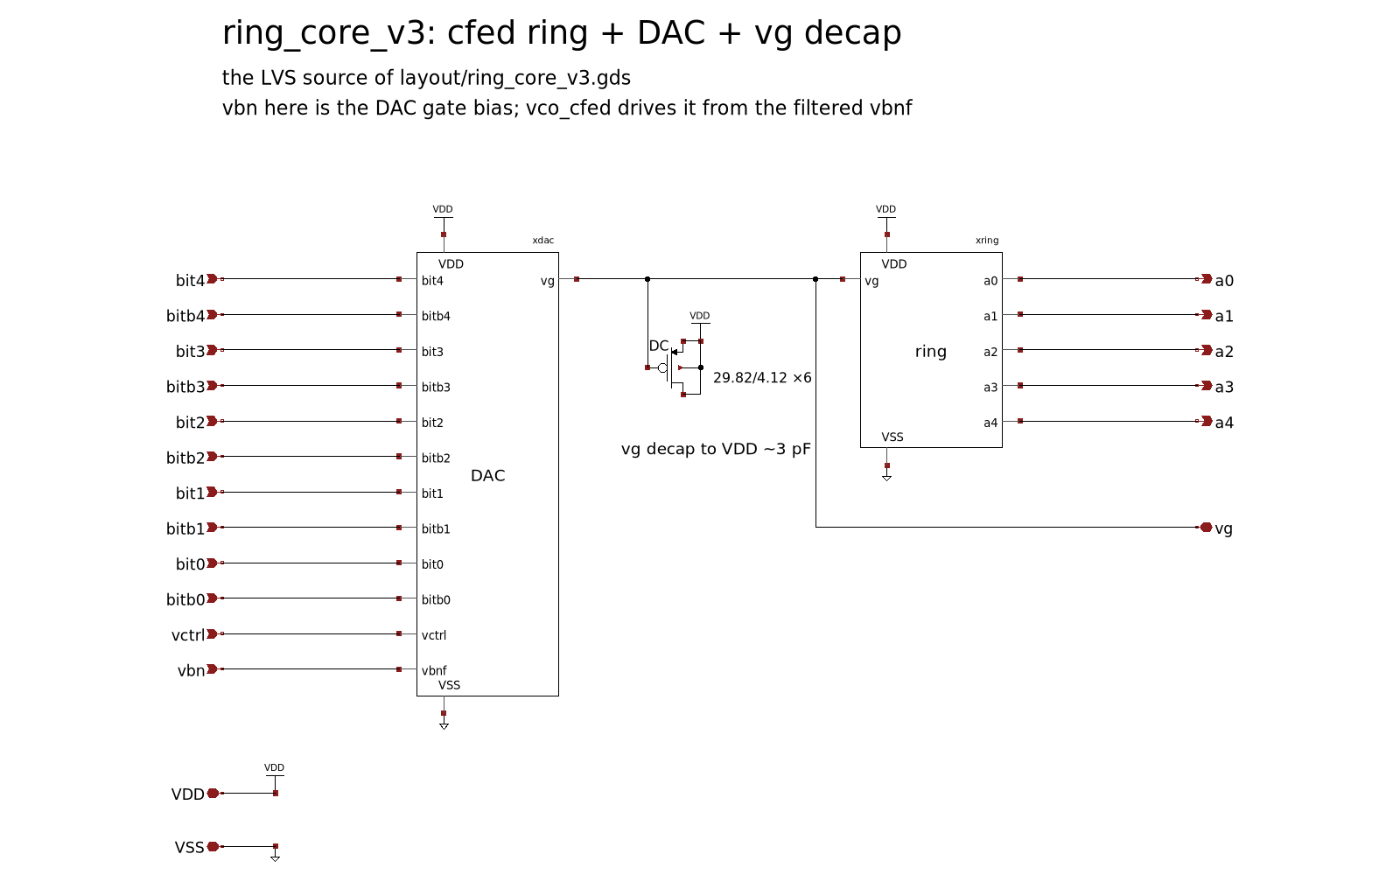
docs/img/xschem/ring_core_v3.png
