mattvenn/gf-433-oscillator/docs/img/xschem/tspc_t1.png

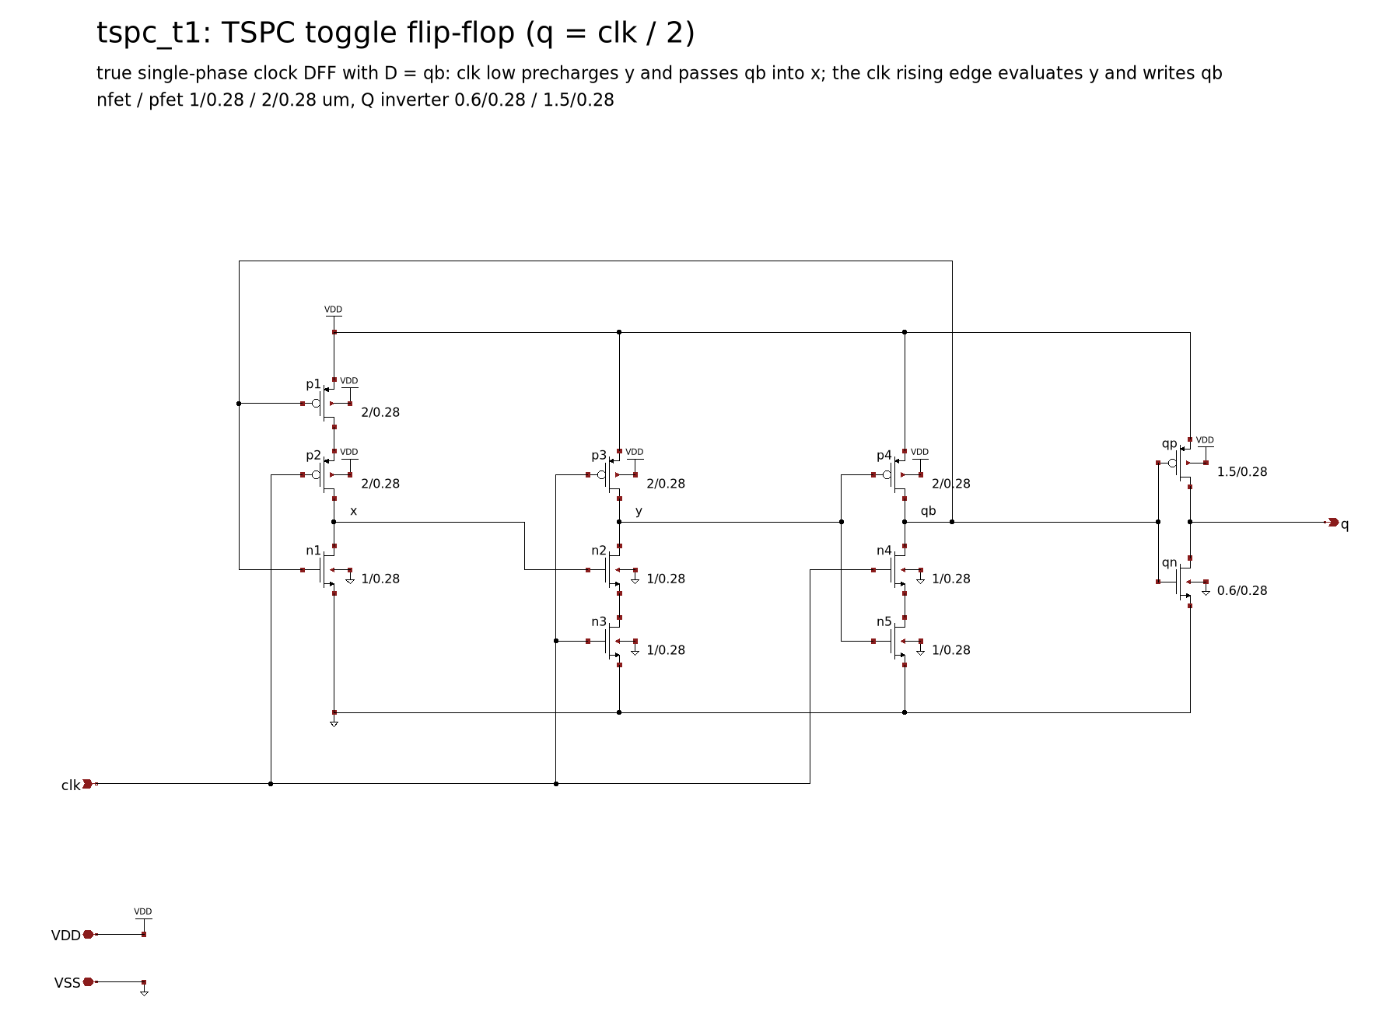
docs/img/xschem/tspc_t1.png
