mattvenn/gf-433-oscillator/docs/img/xschem/tt_asw_5v0.png

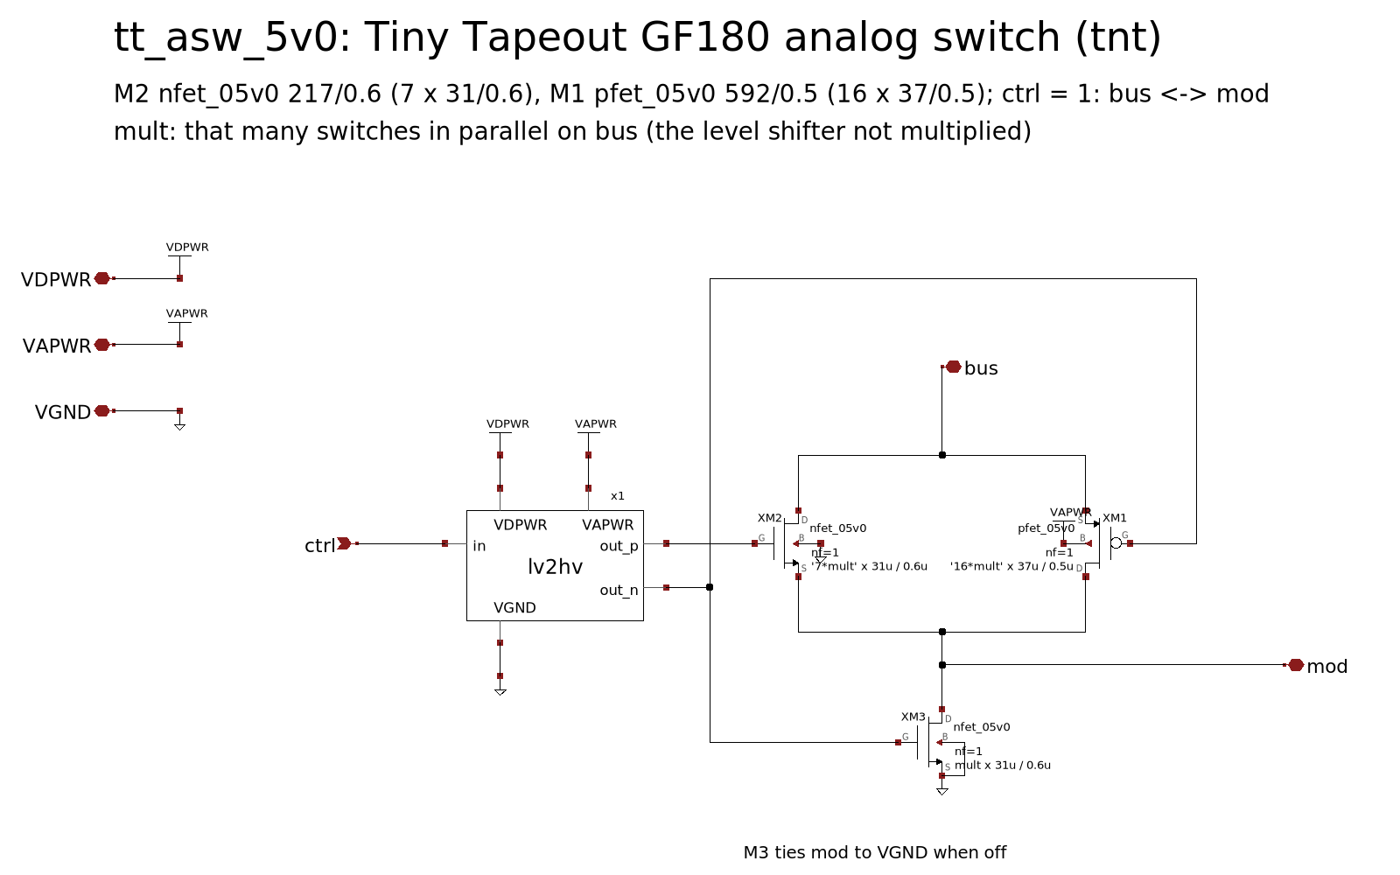
docs/img/xschem/tt_asw_5v0.png
