mattvenn/gf-433-oscillator/docs/img/xschem/vco_cfed.png

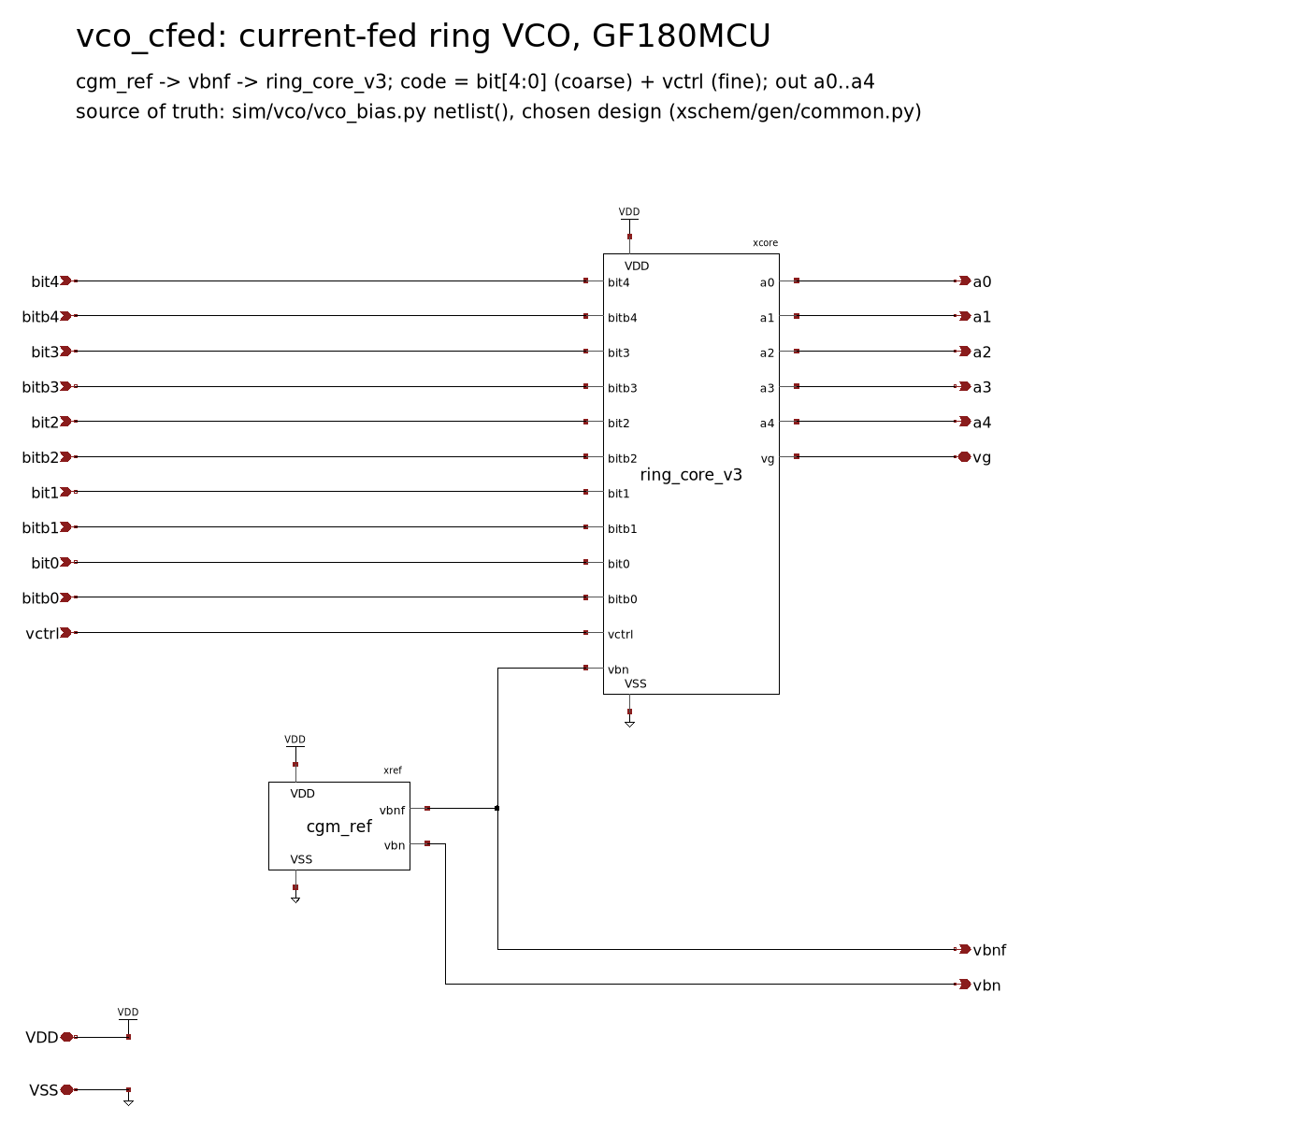
docs/img/xschem/vco_cfed.png
