mattvenn/gf-433-oscillator/docs/schematic/ring_bias.png

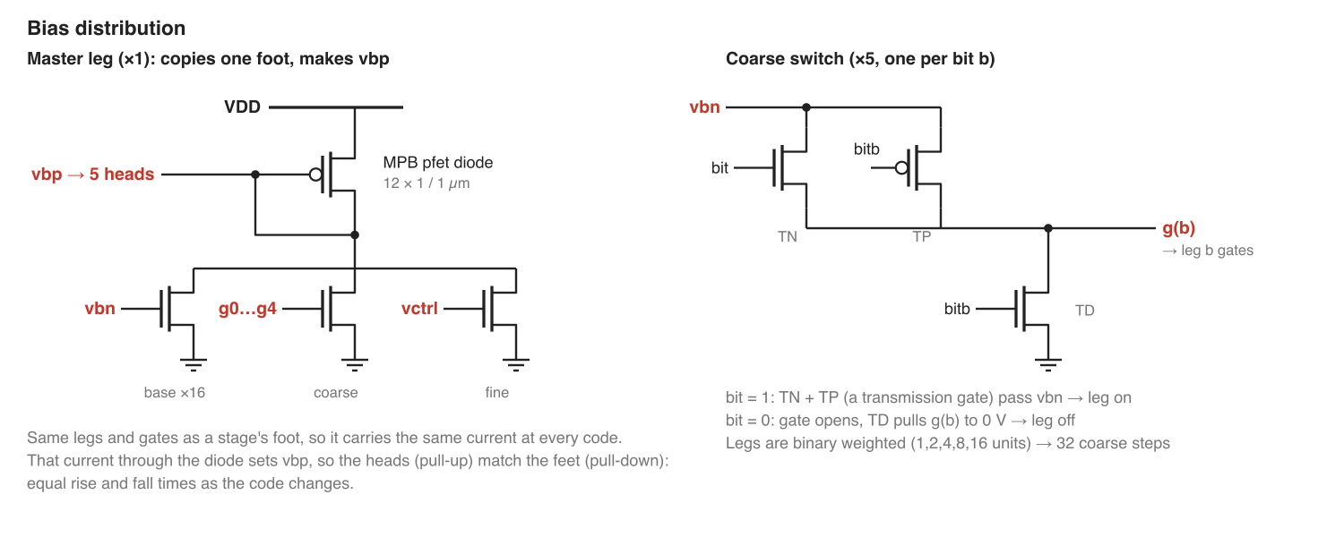
docs/schematic/ring_bias.png
