mattvenn/gf-433-oscillator/docs/schematic/ring_loop.png

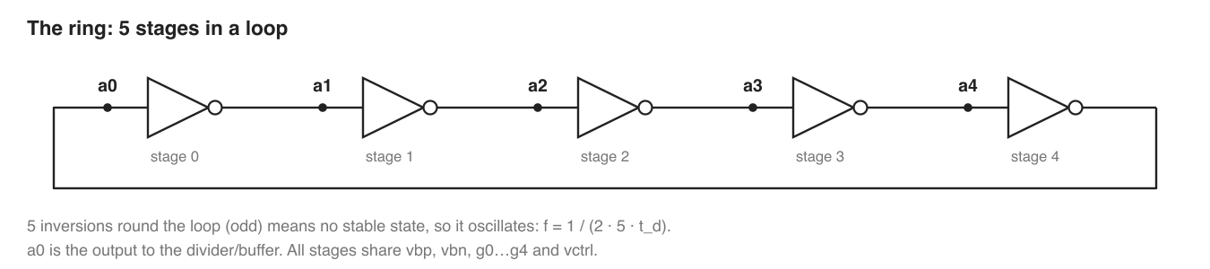
docs/schematic/ring_loop.png
