mattvenn/gf-433-oscillator/docs/schematic/ring_stage.png

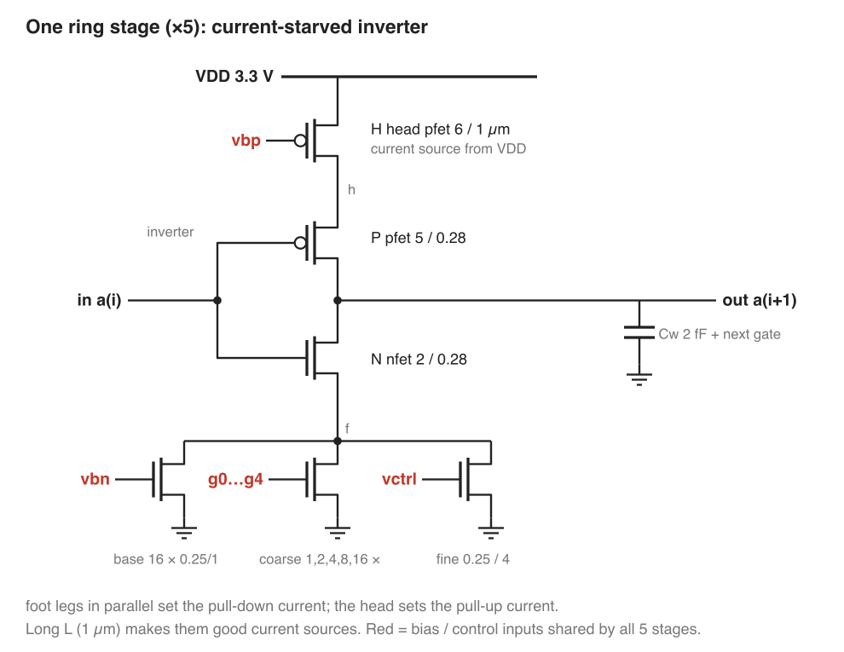
docs/schematic/ring_stage.png
