mattvenn/gf-433-oscillator/sim/ref/results.md

# cgm_ref: extracted reference vs schematic (code 9, vctrl 1.65 V, VDD 3.3 V)

| config | corner | T (°C) | vbn (V) | vbnf (V) | I(MN1) (µA) | I(vddr) (µA) | vg (V) | f(a0) (MHz) | log flags |
|---|---|---|---|---|---|---|---|---|---|
| sch | typical | 20 | 1.2269 | 1.2292 | 33.017 | 69.593 | 1.8969 | 432.98 |  |
| sch | typical | 27 | 1.2320 | 1.2344 | 33.368 | 70.231 | 1.8944 | 433.49 |  |
| sch | typical | 35 | 1.2375 | 1.2399 | 33.712 | 70.851 | 1.8920 | 433.65 |  |
| xcore | ff | 27 | 1.0829 | 1.0856 | 31.440 | 67.041 | 2.0530 | 470.35 |  |
| xcore | ss | 27 | 1.3841 | 1.3871 | 35.437 | 73.798 | 1.7232 | 389.62 |  |
| xcore | typical | 20 | 1.2269 | 1.2297 | 33.019 | 69.595 | 1.8941 | 425.14 |  |
| xcore | typical | 27 | 1.2320 | 1.2349 | 33.369 | 70.233 | 1.8916 | 425.74 |  |
| xcore | typical | 35 | 1.2375 | 1.2404 | 33.714 | 70.853 | 1.8891 | 426.01 |  |
| xref (ref C-only) | ff | 27 | 1.0828 | 1.0854 | - | 67.017 | 2.0531 | 470.22 |  |
| xref (ref C-only) | ss | 27 | 1.3840 | 1.3870 | - | 73.770 | 1.7234 | 389.50 |  |
| xref (ref C-only) | typical | 20 | 1.2268 | 1.2296 | - | 69.569 | 1.8942 | 425.01 |  |
| xref (ref RC) | typical | 27 | 1.2319 | 1.2347 | - | 70.142 | 1.8917 | 425.59 |  |
| xref (ref C-only) | typical | 27 | 1.2319 | 1.2347 | - | 70.207 | 1.8917 | 425.61 |  |
| xref (ref C-only) | typical | 35 | 1.2374 | 1.2403 | - | 70.827 | 1.8893 | 425.88 |  |

Tempco of f (tt, 20 → 35 °C, relative to 27 °C):

- sch: +104 ppm/°C (f20 432.978, f27 433.488, f35 433.654 MHz)
- xcore: +137 ppm/°C (f20 425.136, f27 425.735, f35 426.009 MHz)
- xref: +137 ppm/°C (f20 425.011, f27 425.610, f35 425.883 MHz)

Power-on (reference + filter alone, VDD ramp 10 µs, all nodes 0 V at t = 0):

| run | vbn end (V) | vbnf end (V) | t to within 1 % (µs) | vbnf drift last 10 % (mV) | I(vddr) end (µA) | flags |
|---|---|---|---|---|---|---|
| su_sch_typical_27 | 1.2320 | 1.2320 | 90.2 | 0.00 | 70.222 |  |
| su_sch_ss_27 | 1.3841 | 1.3841 | 87.8 | 0.00 | 73.786 |  |
| su_sch_ff_27 | 1.0828 | 1.0828 | 93.3 | 0.00 | 67.031 |  |
| su_xref_typical_27 | 1.2318 | 1.2318 | 90.8 | 0.00 | 70.131 |  |
| su_xref_ss_27 | 1.3839 | 1.3839 | 88.5 | 0.00 | 73.688 |  |
| su_xref_ff_27 | 1.0827 | 1.0827 | 93.9 | 0.00 | 66.946 |  |
