mattvenn/gf-433-oscillator/sim/tx/results/top.md

# TX driver on the extracted vco_top: results

Generated by `python3 sim/tx/tb_tx_top.py summary` from `build/tx_top/`. Code 9, vctrl 1.65 V, rroute 40 ohm, n_off 3, dipole 73 ohm + 100 pF, VDD_TX via 1 ohm + 1 nH (assumed). Reference without the driver: extracted core (rcx) + extracted LS (`sim/top/top_pex.py`, `sim/lsdiv/results/remap.csv`). Measured over the last 40 % of 1.2 us.

| run | f(a0) (MHz) | vs no driver | jitter rms / p-p (ps) | f/f(ck) | LS duty (no driver) | P_dip / fund (dBm) | out duty p / n | phase err (deg) | I(VDD_TX) avg / rms (mA) | ripple VDD / VDD_TX (mV) | P(VDD) / P(VDD_LS) (mW) | flags |
|---|---|---|---|---|---|---|---|---|---|---|---|---|
| c_ff_off | 461.75 | +0.07 % | 0.10 / 0.4 | 4.0000 | 46.5 % (46.5 %) | -150.00 / -150.00 | off (max 0.000 V) | +nan | 0.12 / 0.43 | 0.0 / 17 | 0.432 / 0.905 | none |
| c_ff_own | 461.75 | +0.07 % | 0.10 / 0.4 | 4.0000 | 46.5 % (46.5 %) | +7.54 / +7.32 | 54.0 / 47.3 % | -0.19 | 14.94 / 16.12 | 0.0 / 212 | 0.432 / 0.905 | none |
| c_ff_pg | 461.90 | +0.11 % | 0.29 / 1.0 | 4.0000 | 46.4 % (46.5 %) | +7.53 / +7.31 | 53.9 / 47.6 % | -0.18 | 14.92 / 15.32 | 14.7 / 15 | 0.432 / 0.902 | none |
| c_ff_pgoff | 461.76 | +0.07 % | 0.23 / 0.9 | 4.0000 | 46.5 % (46.5 %) | -150.00 / -150.00 | off (max 0.000 V) | +nan | 0.12 / 0.26 | 1.5 / 1 | 0.432 / 0.911 | none |
| c_ff_shared | 460.06 | -0.29 % | 1.26 / 3.0 | 4.0000 | 46.7 % (46.5 %) | +7.57 / +7.36 | 53.8 / 47.4 % | +0.01 | 14.90 / 15.77 | 156.7 / 157 | 0.432 / 0.907 | none |
| c_ss_off | 382.70 | +0.01 % | 0.12 / 0.4 | 4.0000 | 49.7 % (49.8 %) | -150.00 / -150.00 | off (max 0.000 V) | +nan | 0.09 / 0.64 | 0.0 / 19 | 0.473 / 0.590 | none |
| c_ss_own | 382.70 | +0.01 % | 0.12 / 0.4 | 4.0000 | 49.7 % (49.8 %) | +5.00 / +4.81 | 50.2 / 50.9 % | -0.03 | 10.24 / 11.83 | 0.0 / 174 | 0.473 / 0.590 | none |
| c_ss_pg | 382.82 | +0.04 % | 0.20 / 0.8 | 4.0000 | 49.7 % (49.8 %) | +4.99 / +4.80 | 50.1 / 51.1 % | -0.14 | 10.23 / 10.48 | 12.2 / 12 | 0.473 / 0.591 | none |
| c_ss_pgoff | 382.71 | +0.01 % | 0.21 / 0.8 | 4.0000 | 49.7 % (49.8 %) | -150.00 / -150.00 | off (max 0.000 V) | +nan | 0.09 / 0.19 | 1.2 / 1 | 0.473 / 0.595 | none |
| c_ss_shared | 382.53 | -0.04 % | 0.29 / 1.1 | 4.0000 | 49.8 % (49.8 %) | +5.00 / +4.81 | 50.2 / 51.0 % | -0.10 | 10.26 / 10.59 | 68.5 / 69 | 0.473 / 0.585 | none |
| c_typical_off | 418.02 | +0.03 % | 0.11 / 0.4 | 4.0000 | 47.9 % (47.9 %) | -150.00 / -150.00 | off (max 0.000 V) | +nan | 0.10 / 0.73 | 0.0 / 25 | 0.451 / 0.716 | none |
| c_typical_own | 418.02 | +0.03 % | 0.11 / 0.4 | 4.0000 | 47.9 % (47.9 %) | +6.53 / +6.32 | 52.5 / 48.6 % | +0.34 | 12.58 / 14.07 | 0.0 / 220 | 0.451 / 0.716 | none |
| c_typical_own_T0 | 436.13 | +4.37 % | 0.86 / 3.0 | 4.0000 | 48.1 % (47.9 %) | +6.77 / +6.56 | 52.4 / 48.8 % | +0.46 | 13.08 / 14.31 | 0.0 / 208 | 0.451 / 0.733 | none |
| c_typical_own_T70 | 395.31 | -5.40 % | 0.71 / 2.4 | 4.0000 | 47.7 % (47.9 %) | +6.13 / +5.91 | 52.6 / 48.7 % | +0.20 | 11.87 / 13.57 | 0.0 / 206 | 0.446 / 0.700 | none |
| c_typical_own_V3.15 | 419.29 | +0.34 % | 0.12 / 0.4 | 4.0000 | 48.3 % (47.9 %) | +5.78 / +5.59 | 52.1 / 49.0 % | +0.52 | 11.55 / 12.91 | 0.0 / 200 | 0.429 / 0.628 | none |
| c_typical_own_V3.45 | 416.82 | -0.26 % | 0.11 / 0.4 | 4.0000 | 47.6 % (47.9 %) | +7.21 / +7.00 | 52.8 / 48.4 % | +0.12 | 13.62 / 15.25 | 0.0 / 240 | 0.474 / 0.814 | none |
| c_typical_pg | 418.24 | +0.08 % | 0.25 / 0.9 | 4.0000 | 47.9 % (47.9 %) | +6.51 / +6.31 | 52.3 / 49.0 % | +0.31 | 12.53 / 12.83 | 13.4 / 13 | 0.451 / 0.716 | none |
| c_typical_pgoff | 418.03 | +0.03 % | 0.22 / 0.9 | 4.0000 | 47.9 % (47.9 %) | -150.00 / -150.00 | off (max 0.000 V) | +nan | 0.10 / 0.22 | 1.4 / 1 | 0.451 / 0.722 | none |
| c_typical_shared | 417.68 | -0.05 % | 0.43 / 1.5 | 4.0000 | 48.1 % (47.9 %) | +6.53 / +6.34 | 52.4 / 49.0 % | +0.38 | 12.55 / 13.04 | 97.1 / 97 | 0.451 / 0.714 | none |
| rcx_typical_own | 417.86 | -0.01 % | 0.11 / 0.4 | 4.0000 | 48.0 % (47.9 %) | +6.53 / +6.32 | 52.5 / 48.7 % | +0.33 | 12.57 / 14.07 | 0.0 / 220 | 0.451 / 0.715 | none |
| rcx_typical_pg | 418.07 | +0.04 % | 0.26 / 1.0 | 4.0000 | 47.9 % (47.9 %) | +6.51 / +6.31 | 52.3 / 49.1 % | +0.31 | 12.53 / 12.83 | 13.2 / 13 | 0.451 / 0.715 | none |
