mattvenn/gf-433-oscillator/sim/top/results.md

# Extracted vco_top: results

Generated by `python3 sim/top/top_pex.py summary` from `build/top_pex/`. Settings: 27 °C, code 9, vctrl 1.65 V,
VDD = VDD_LS = 3.3 V, 1.2 µs, measured over the last 40 %. Block-level references: extracted core + extracted
reference without the level shifter (`sim/ref/results.md`); extracted core (rcx) + extracted level shifter
with the schematic reference (`sim/lsdiv/results/remap.csv`).

| Netlist, corner | f(a0) (MHz) | vs core + ref | vs core + LS | f(a0)/f(ck) | LS duty (block) | ck duty | P(VDD) (mW) | P(VDD_LS) (mW) (block) | vbnf (V) | log flags |
|---|---|---|---|---|---|---|---|---|---|---|
| c, ff | 461.75 | -1.80 % | +0.07 % | 4.0000 | 46.5 % (46.5 %) | 49.2 % | 0.432 | 0.895 (0.891) | 1.0857 | none |
| c, ss | 382.70 | -1.75 % | +0.01 % | 4.0000 | 49.7 % (49.8 %) | 49.1 % | 0.473 | 0.581 (0.578) | 1.3870 | none |
| c, tt | 418.02 | -1.78 % | +0.03 % | 4.0000 | 47.9 % (47.9 %) | 49.2 % | 0.451 | 0.707 (0.703) | 1.2349 | none |
| rcx, tt | 417.86 | -1.82 % | -0.01 % | 4.0000 | 48.0 % (47.9 %) | 49.2 % | 0.451 | 0.706 (0.703) | 1.2349 | none |

## startup_c_typical

| window start (µs) | VDD (V) | a0 swing (V) | f(a0) (MHz) | f(ck) (MHz) | vbnf (V) |
|---|---|---|---|---|---|
| 0 | 0.16 | 0.22 | nan | nan | 0.006 |
| 1 | 0.50 | 0.13 | nan | nan | 0.008 |
| 2 | 0.83 | 1.03 | 19.5 | nan | 0.011 |
| 3 | 1.16 | 1.19 | 28.8 | nan | 0.036 |
| 4 | 1.49 | 1.26 | 38.5 | 10.2 | 0.090 |
| 5 | 1.82 | 1.30 | 41.6 | 10.5 | 0.146 |
| 6 | 2.15 | 1.34 | 41.0 | 10.2 | 0.201 |
| 7 | 2.48 | 1.36 | 40.2 | 10.0 | 0.252 |
| 8 | 2.81 | 1.38 | 39.4 | 9.8 | 0.300 |
| 9 | 3.14 | 1.40 | 38.7 | 9.7 | 0.346 |
| 10 | 3.30 | 1.10 | 30.2 | 7.5 | 0.392 |
| 11 | 3.30 | 1.08 | 29.8 | 7.5 | 0.453 |
| 12 | 3.30 | 1.08 | 30.2 | 7.6 | 0.528 |

log flags: none
