mattvenn/gf-433-oscillator/sim/results/2026-11-08/startup/summary.md

# cfed power-on start-up summary (sim/pn/cfed_startup.py summary)

tmax 20p, run length 200 us

| corner | T °C | code | ramp µs | vbn DC V | t_vbn 1 % µs | t_vbnf 1 % µs | t_vg 2 % µs | vg final V | t_osc µs | t_f 1 % µs | f MHz | vs map % | mode | swing V | max(vg−VDD) mV | verdict | wall min |
|---|---|---|---|---|---|---|---|---|---|---|---|---|---|---|---|---|---|
| ss | 0 | 0 | 10 | 1.3579 | 31.7 | 111.9 | 77.1 | 1.966 | 4.2 | 137.7 | 196.46 | -1.293 | 0.200 | 1.88–3.42 | 13 | **f -1.29 %** | 22.0 |
| ss | 0 | 0 | 1 | 1.3579 | 27.9 | 108.1 | 73.3 | 1.966 | 0.5 | 134.1 | 196.48 | -1.284 | 0.200 | 1.88–3.42 | 13 | **f -1.28 %** | 23.2 |
| ss | 0 | 31 | 10 | 1.3579 | 32.0 | 114.9 | 114.4 | 1.348 | 4.2 | 137.9 | 729.34 | -1.308 | 0.200 | 1.25–3.44 | 13 | **f -1.31 %** | 26.3 |
| ss | 0 | 31 | 1 | 1.3579 | 28.1 | 111.1 | 110.5 | 1.348 | 0.5 | 134.4 | 729.42 | -1.297 | 0.200 | 1.25–3.44 | 13 | **f -1.30 %** | 25.9 |
| ss | 27 | 0 | 10 | 1.3841 | 32.2 | 106.9 | 73.7 | 1.967 | 3.9 | 130.4 | 199.97 | -1.459 | 0.200 | 1.88–3.42 | 13 | **f -1.46 %** | 22.9 |
| ss | 27 | 0 | 1 | 1.3841 | 28.4 | 103.1 | 69.9 | 1.967 | 0.5 | 126.7 | 199.98 | -1.453 | 0.200 | 1.88–3.42 | 13 | **f -1.45 %** | 22.4 |
| ss | 27 | 31 | 10 | 1.3841 | 32.5 | 109.8 | 109.8 | 1.303 | 3.9 | 130.5 | 731.88 | -1.258 | 0.200 | 1.21–3.43 | 13 | **f -1.26 %** | 28.7 |
| ss | 27 | 31 | 1 | 1.3841 | 28.7 | 106.0 | 105.6 | 1.303 | 0.5 | 126.8 | 731.93 | -1.251 | 0.200 | 1.21–3.43 | 13 | **f -1.25 %** | 23.9 |
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

Runs: 36, flagged: 30.
Worst start-up (max of t_f 1 %, t_vg, t_vbnf): ss_t0_c31_r10u_s20p at 137.9 µs.
Worst t_osc: ss_t0_c0_r10u_s20p at 4.2 µs; worst |f − map|: 1.725 %; mode 0.200–0.200; max f drift over the last 10 µs: 0.037 %.
