mattvenn/gf-433-oscillator/sim/results/2026-11-08/cfed/summary.md

# cfed sizing summary (generated by sim/pn/cfed_sizing.py summary)

## Job 1

| w | wfu=wff µm | lnw µm | tt code | f27 MHz | tc tt ppm/°C | worst fmin MHz | worst fmax MHz | range | min fine/step (ss70/tt27/ff0) | tc per corner (code: ppm/°C) |
|---|---|---|---|---|---|---|---|---|---|---|
| 1 | 0.250 | 5.497 | 14 | 437.1 | -0.6 | 183.8 | 631.8 | FAIL | 2.67 / 4.10 / 5.90 | tt 14: -1, ss 16: +30, ff 11: -28, sf 14: +68, fs 14: -13 |
| 1.1 | 0.275 | 5.296 | 11 | 429.0 | -1.0 | 204.2 | 688.2 | FAIL | 2.48 / 3.87 / 5.61 | tt 11: -1, ss 14: +14, ff 9: -46, sf 11: +71, fs 12: -35 |
| 1.2 | 0.300 | 5.023 | 9 | 434.1 | +1.6 | 227.2 | 750.9 | pass | 2.25 / 3.58 / 5.25 | tt 9: +2, ss 11: +27, ff 7: -50, sf 9: +74, fs 9: -24 |
| 1.3 | 0.325 | 4.627 | 7 | 443.2 | +0.2 | 259.0 | 831.6 | pass | 1.92 / 3.17 / 4.73 | tt 7: +0, ss 8: +53, ff 5: -56, sf 7: +78, fs 7: -26 |
| 1.4 | 0.350 | 4.462 | 5 | 429.3 | -1.8 | 283.3 | 891.4 | pass | 1.74 / 2.95 / 4.46 | tt 5: -2, ss 7: +31, ff 4: -80, sf 5: +82, fs 5: -33 |

Winner: w = 1.2, lnw = 5.0226 (smallest w with the range met and |tempco| <= 50 ppm/C at tt)

Range per corner (fmin at code 0 vctrl 0 / fmax at code 31 vctrl 3.3, MHz):

| w | typical 0 | typical 70 | ss 0 | ss 70 | ff 0 | ff 70 | sf 0 | sf 70 | fs 0 | fs 70 |
|---|---|---|---|---|---|---|---|---|---|---|
| 1 | 159.8/718.1 | 168.2/693.1 ✗ | 147.3/650.6 ✗ | 156.1/631.8 ✗ | 174.8/798.9 | 183.8/766.0 | 155.7/720.2 | 164.2/698.0 ✗ | 159.0/707.6 | 168.0/681.6 ✗ |
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
ISF (tt 27 °C, code 9, m = 80, f0 434.1 MHz): inverter FM sw: 1000-10000 0.23 kHz, 1000-100000 0.57 kHz; on: 1000-10000 66.58 kHz, 1000-100000 97.07 kHz; L sw: 10000 -77.0, 100000 -98.5, 1e+06 -118.7, 1e+07 -138.7; on: 10000 -29.9, 100000 -59.4, 1e+06 -88.4, 1e+07 -114.9
