mattvenn/gf-433-oscillator/sim/results/2026-11-08/job2/summary.md

| variant | corner | T C | f0 MHz | P mW | L(10k) | L(100k) | L(1M) | L(10M) dBc/Hz | FOM@1M | Kvdd MHz/V | Kbias MHz/V | dominant @1M |
|---|---|---|---|---|---|---|---|---|---|---|---|---|
| cgmq | ff | 0 | 445.9 | 2.61 | -36.9 | -65.5 | -90.8 | -112.1 | -139.6 | -137.9 | -846.7 | dev_foot |
| cgmq | ff | 27 | 443.8 | 2.73 | -39.7 | -68.2 | -92.6 | -113.6 | -141.2 | -162.7 | -974.1 | dev_foot |
| cgmq | ff | 70 | 436.7 | 2.84 | -41.5 | -70.0 | -94.0 | -114.7 | -142.2 | -160.9 | -917.1 | dev_foot |
| cgmq | fs | 0 | 522.4 | 2.55 | -38.5 | -67.1 | -91.9 | -113.1 | -142.2 | -99.8 | -785.4 | dev_foot |
| cgmq | fs | 27 | 514.5 | 2.67 | -40.0 | -68.6 | -93.3 | -114.3 | -143.2 | -103.1 | -793.2 | dev_foot |
| cgmq | fs | 70 | 497.4 | 2.78 | -41.9 | -70.5 | -94.7 | -115.6 | -144.2 | -98.6 | -722.0 | dev_foot |
| cgmq | sf | 0 | 369.6 | 2.60 | -46.8 | -75.5 | -98.4 | -118.8 | -145.6 | -116.6 | -898.6 | vdd |
| cgmq | sf | 27 | 380.4 | 2.74 | -47.3 | -76.1 | -98.8 | -119.2 | -146.0 | -110.5 | -818.7 | vdd |
| cgmq | sf | 70 | 384.5 | 2.87 | -47.7 | -76.6 | -99.3 | -119.6 | -146.4 | -101.8 | -709.0 | vdd |
| cgmq | ss | 0 | 408.1 | 2.56 | -46.9 | -75.7 | -99.2 | -119.9 | -147.4 | -76.4 | -775.3 | dev_foot |
| cgmq | ss | 27 | 413.5 | 2.69 | -47.5 | -76.4 | -99.9 | -120.5 | -147.9 | -67.8 | -695.1 | dev_foot |
| cgmq | ss | 70 | 411.3 | 2.82 | -48.0 | -77.1 | -100.5 | -121.1 | -148.3 | -59.2 | -591.2 | dev_foot |
| cgmq | typical | 0 | 430.0 | 2.58 | -43.0 | -71.5 | -95.3 | -116.0 | -143.9 | -137.4 | -976.1 | dev_foot |
| cgmq | typical | 27 | 436.1 | 2.71 | -43.9 | -72.4 | -96.1 | -116.8 | -144.6 | -126.2 | -884.9 | dev_foot |
| cgmq | typical | 70 | 433.8 | 2.83 | -45.1 | -73.7 | -97.1 | -117.7 | -145.3 | -113.6 | -768.6 | dev_foot |
