mattvenn/gf-433-oscillator/sim/silicon_factor/results.csv

cfg | clksel2 | clksel | stages | corner | mode | temp | f_Hz | f_sd_pct | n_periods | vmin | vmax | runtime_s | status
inv1x5 | 1 | 10 | 5 | typical | c | 27 | 3.419897e+08 | 0.070 | 12 | -0.043 | 3.369 | 611 | ok
t3 | 0 | 2 | 3 | typical | c | 27 | 2.209223e+08 | 0.011 | 10 | -0.043 | 3.369 | 829 | ok
inv4x5 | 2 | 2 | 5 | typical | c | 27 | 3.626745e+08 | 0.254 | 20 | -0.043 | 3.369 | 876 | ok
t5 | 0 | 3 | 5 | typical | c | 27 | 1.976524e+08 | 0.001 | 10 | -0.043 | 3.369 | 902 | ok
t9 | 0 | 5 | 9 | typical | c | 27 | 1.617745e+08 | 0.001 | 10 | -0.043 | 3.368 | 1008 | ok
t33 | 0 | 10 | 33 | typical | c | 27 | 7.761771e+07 | 0.000 | 10 | -0.043 | 3.368 | 1585 | ok
t65 | 0 | 13 | 65 | typical | c | 27 | 5.013168e+07 | 0.000 | 10 | -0.043 | 3.368 | 2109 | ok
t161 | 0 | 15 | 161 | typical | c | 27 | 2.386221e+07 | 0.000 | 9 | -0.043 | 3.368 | 3743 | ok
inv1x5 | 1 | 10 | 5 | ss | c | 27 | 2.430153e+08 | 0.082 | 8 | -0.049 | 3.378 | 558 | ok
t3 | 0 | 2 | 3 | ss | c | 27 | 1.571387e+08 | 0.021 | 7 | -0.049 | 3.378 | 741 | ok
inv4x5 | 2 | 2 | 5 | ss | c | 27 | 2.562474e+08 | 0.248 | 14 | -0.048 | 3.378 | 818 | ok
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
