mattvenn/gf-433-oscillator/sim/lsdiv/results/remap.csv

corner | code | vctrl | f_a0_hz | f_drift | ls_duty | div_ratio | p_ls_w | p_div_w
tt | 0 | 1.65 | 213870551.07864198 | -3.216492290614159e-05 | 0.4703468697291506 | 4.000001385894725 | 0.000436041097141893 | -0.0
tt | 1 | 1.65 | 239573518.28793627 | -3.94956316103201e-05 | 0.471633224474208 | 3.999996023745622 | 0.0004714151373190879 | -0.0
tt | 2 | 1.65 | 264471650.9068393 | -5.1972768896568766e-05 | 0.4728501270142393 | 4.0000018541248545 | 0.0005045235229852678 | -0.0
tt | 3 | 1.65 | 288436235.9137859 | -5.859725845813735e-05 | 0.4739828160673209 | 4.000000273997557 | 0.0005358248276571023 | -0.0
tt | 4 | 1.65 | 311416311.57444304 | -5.614924503294372e-05 | 0.47504212830713965 | 3.999998764624236 | 0.0005656369161474588 | -0.0
tt | 5 | 1.65 | 333934958.1996843 | -6.318088827317325e-05 | 0.47603521404442223 | 3.9999987443672578 | 0.0005965119531304838 | -0.0
tt | 6 | 1.65 | 355973384.6030446 | -7.437351997274799e-05 | 0.47698493579728246 | 3.999998647061568 | 0.0006246103755589368 | -0.0
tt | 7 | 1.65 | 377293064.3575147 | -8.03200750288946e-05 | 0.4778711786103221 | 3.9999986700745227 | 0.0006512642245616354 | -0.0
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
