mattvenn/gf-433-oscillator/sim/pn/results/2026-11-07/cgm_ff_t27/isf.csv

j | phi | g_rad_per_C | v_m3ps | v_at_td
0 | 0.00000 | 8.666806e+12 | 0.0215 | 0.0220
1 | 0.10472 | 1.199024e+13 | 0.0393 | 0.0416
2 | 0.20944 | 1.657904e+13 | 0.0869 | 0.0915
3 | 0.31416 | 2.330220e+13 | 0.1643 | 0.1708
4 | 0.41888 | 3.604038e+13 | 0.2688 | 0.2773
5 | 0.52360 | 4.942368e+13 | 0.4140 | 0.4277
6 | 0.62832 | 4.874705e+13 | 0.6441 | 0.6614
7 | 0.73304 | 4.439209e+13 | 0.8739 | 0.8892
8 | 0.83776 | 3.877674e+13 | 1.0775 | 1.0913
9 | 0.94248 | 3.284132e+13 | 1.2645 | 1.2772
10 | 1.04720 | 2.776164e+13 | 1.4320 | 1.4424
11 | 1.15192 | 2.427734e+13 | 1.5537 | 1.5608
12 | 1.25664 | 2.131875e+13 | 1.6437 | 1.6498
13 | 1.36136 | 1.803180e+13 | 1.7288 | 1.7349
14 | 1.46608 | 1.451765e+13 | 1.8130 | 1.8189
15 | 1.57080 | 9.356701e+12 | 1.8962 | 1.9021
16 | 1.67552 | 2.985122e+11 | 1.9795 | 1.9855
17 | 1.78024 | -1.047115e+13 | 2.0623 | 2.0679
18 | 1.88496 | -1.511965e+13 | 2.1387 | 2.1441
19 | 1.98968 | -1.654587e+13 | 2.2144 | 2.2197
20 | 2.09440 | -1.677805e+13 | 2.2885 | 2.2937
21 | 2.19911 | -1.660060e+13 | 2.3615 | 2.3666
22 | 2.30383 | -1.629877e+13 | 2.4344 | 2.4396
23 | 2.40855 | -1.599860e+13 | 2.5085 | 2.5139
24 | 2.51327 | -1.576145e+13 | 2.5843 | 2.5897
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
