mattvenn/gf-433-oscillator/sim/pn/results/2026-11-07/cgm_fs_t27/isf.csv

j | phi | g_rad_per_C | v_m3ps | v_at_td
0 | 0.00000 | 1.265208e+13 | 0.0142 | 0.0129
1 | 0.10472 | 1.689276e+13 | 0.0099 | 0.0111
2 | 0.20944 | 2.283010e+13 | 0.0426 | 0.0470
3 | 0.31416 | 3.274576e+13 | 0.1105 | 0.1176
4 | 0.41888 | 5.128270e+13 | 0.2108 | 0.2211
5 | 0.52360 | 6.564310e+13 | 0.3672 | 0.3848
6 | 0.62832 | 6.547985e+13 | 0.6051 | 0.6256
7 | 0.73304 | 6.073969e+13 | 0.8361 | 0.8537
8 | 0.83776 | 5.423874e+13 | 1.0325 | 1.0477
9 | 0.94248 | 4.693513e+13 | 1.2045 | 1.2180
10 | 1.04720 | 3.860536e+13 | 1.3603 | 1.3728
11 | 1.15192 | 2.880048e+13 | 1.5057 | 1.5175
12 | 1.25664 | 1.936487e+13 | 1.6388 | 1.6487
13 | 1.36136 | 1.246356e+13 | 1.7439 | 1.7516
14 | 1.46608 | 6.098652e+12 | 1.8278 | 1.8342
15 | 1.57080 | -2.215571e+12 | 1.9011 | 1.9070
16 | 1.67552 | -1.390563e+13 | 1.9705 | 1.9762
17 | 1.78024 | -2.400980e+13 | 2.0371 | 2.0423
18 | 1.88496 | -2.696000e+13 | 2.0987 | 2.1039
19 | 1.98968 | -2.743616e+13 | 2.1611 | 2.1663
20 | 2.09440 | -2.738368e+13 | 2.2225 | 2.2276
21 | 2.19911 | -2.721654e+13 | 2.2830 | 2.2880
22 | 2.30383 | -2.691530e+13 | 2.3430 | 2.3480
23 | 2.40855 | -2.645470e+13 | 2.4031 | 2.4082
24 | 2.51327 | -2.595717e+13 | 2.4633 | 2.4684
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
