mattvenn/gf-433-oscillator/sim/pn/results/2026-11-07/cgm_sf_t27/isf.csv

j | phi | g_rad_per_C | v_m3ps | v_at_td
0 | 0.00000 | 3.671494e+12 | 0.0291 | 0.0285
1 | 0.10472 | 4.929569e+12 | 0.0200 | 0.0194
2 | 0.20944 | 6.721852e+12 | 0.0112 | 0.0108
3 | 0.31416 | 9.388150e+12 | 0.0164 | 0.0180
4 | 0.41888 | 1.332833e+13 | 0.0601 | 0.0646
5 | 0.52360 | 2.057332e+13 | 0.1458 | 0.1532
6 | 0.62832 | 3.414505e+13 | 0.2796 | 0.2912
7 | 0.73304 | 3.957405e+13 | 0.5198 | 0.5417
8 | 0.83776 | 3.879803e+13 | 0.8493 | 0.8701
9 | 0.94248 | 3.596894e+13 | 1.1243 | 1.1408
10 | 1.04720 | 3.250133e+13 | 1.3472 | 1.3609
11 | 1.15192 | 2.922812e+13 | 1.5259 | 1.5357
12 | 1.25664 | 2.642748e+13 | 1.6430 | 1.6495
13 | 1.36136 | 2.347354e+13 | 1.7289 | 1.7344
14 | 1.46608 | 1.983997e+13 | 1.8103 | 1.8160
15 | 1.57080 | 1.594879e+13 | 1.8957 | 1.9015
16 | 1.67552 | 1.187743e+13 | 1.9806 | 1.9864
17 | 1.78024 | 6.050141e+12 | 2.0650 | 2.0708
18 | 1.88496 | -2.500346e+12 | 2.1497 | 2.1554
19 | 1.98968 | -8.179070e+12 | 2.2329 | 2.2382
20 | 2.09440 | -8.691151e+12 | 2.3093 | 2.3145
21 | 2.19911 | -8.645317e+12 | 2.3850 | 2.3901
22 | 2.30383 | -8.523618e+12 | 2.4595 | 2.4645
23 | 2.40855 | -8.375052e+12 | 2.5338 | 2.5389
24 | 2.51327 | -8.330798e+12 | 2.6086 | 2.6136
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
