mattvenn/gf-433-oscillator/sim/pn/results/2026-11-07/cgm_ss_t27/isf.csv

j | phi | g_rad_per_C | v_m3ps | v_at_td
0 | 0.00000 | 4.688729e+12 | 0.0318 | 0.0310
1 | 0.10472 | 6.128281e+12 | 0.0190 | 0.0178
2 | 0.20944 | 8.338536e+12 | 0.0010 | -0.0003
3 | 0.31416 | 1.158092e+13 | -0.0048 | -0.0038
4 | 0.41888 | 1.692831e+13 | 0.0316 | 0.0360
5 | 0.52360 | 2.813747e+13 | 0.1140 | 0.1219
6 | 0.62832 | 4.206445e+13 | 0.2575 | 0.2723
7 | 0.73304 | 4.418983e+13 | 0.5367 | 0.5609
8 | 0.83776 | 4.294040e+13 | 0.8516 | 0.8723
9 | 0.94248 | 3.990512e+13 | 1.1061 | 1.1225
10 | 1.04720 | 3.615516e+13 | 1.3142 | 1.3281
11 | 1.15192 | 3.168542e+13 | 1.4932 | 1.5052
12 | 1.25664 | 2.660624e+13 | 1.6413 | 1.6505
13 | 1.36136 | 2.054587e+13 | 1.7561 | 1.7637
14 | 1.46608 | 1.460602e+13 | 1.8531 | 1.8596
15 | 1.57080 | 9.582866e+12 | 1.9381 | 1.9439
16 | 1.67552 | 4.412023e+12 | 2.0163 | 2.0219
17 | 1.78024 | -2.290042e+12 | 2.0919 | 2.0974
18 | 1.88496 | -9.357087e+12 | 2.1662 | 2.1716
19 | 1.98968 | -1.118708e+13 | 2.2364 | 2.2412
20 | 2.09440 | -1.113955e+13 | 2.3040 | 2.3090
21 | 2.19911 | -1.109711e+13 | 2.3721 | 2.3771
22 | 2.30383 | -1.101563e+13 | 2.4396 | 2.4446
23 | 2.40855 | -1.092566e+13 | 2.5073 | 2.5122
24 | 2.51327 | -1.090189e+13 | 2.5747 | 2.5796
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
