mattvenn/gf-433-oscillator/sim/pn/results/2026-11-07/cgm_typical_t27/isf.csv

j | phi | g_rad_per_C | v_m3ps | v_at_td
0 | 0.00000 | 6.703321e+12 | 0.0244 | 0.0234
1 | 0.10472 | 9.016856e+12 | 0.0115 | 0.0107
2 | 0.20944 | 1.231443e+13 | 0.0136 | 0.0152
3 | 0.31416 | 1.700606e+13 | 0.0525 | 0.0569
4 | 0.41888 | 2.509820e+13 | 0.1275 | 0.1345
5 | 0.52360 | 4.061424e+13 | 0.2400 | 0.2505
6 | 0.62832 | 5.031503e+13 | 0.4272 | 0.4465
7 | 0.73304 | 4.989455e+13 | 0.7101 | 0.7311
8 | 0.83776 | 4.624454e+13 | 0.9676 | 0.9849
9 | 0.94248 | 4.143776e+13 | 1.1803 | 1.1949
10 | 1.04720 | 3.620526e+13 | 1.3639 | 1.3768
11 | 1.15192 | 3.099544e+13 | 1.5228 | 1.5332
12 | 1.25664 | 2.589380e+13 | 1.6421 | 1.6497
13 | 1.36136 | 2.040308e+13 | 1.7373 | 1.7440
14 | 1.46608 | 1.557885e+13 | 1.8222 | 1.8283
15 | 1.57080 | 1.074067e+13 | 1.9008 | 1.9065
16 | 1.67552 | 4.044325e+12 | 1.9768 | 1.9825
17 | 1.78024 | -5.839670e+12 | 2.0523 | 2.0580
18 | 1.88496 | -1.401905e+13 | 2.1265 | 2.1318
19 | 1.98968 | -1.566783e+13 | 2.1956 | 2.2008
20 | 2.09440 | -1.574460e+13 | 2.2644 | 2.2695
21 | 2.19911 | -1.565039e+13 | 2.3319 | 2.3370
22 | 2.30383 | -1.546370e+13 | 2.3988 | 2.4038
23 | 2.40855 | -1.520548e+13 | 2.4660 | 2.4711
24 | 2.51327 | -1.501530e+13 | 2.5339 | 2.5389
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
