mattvenn/gf-433-oscillator/docs/img/tuning_recipe.png

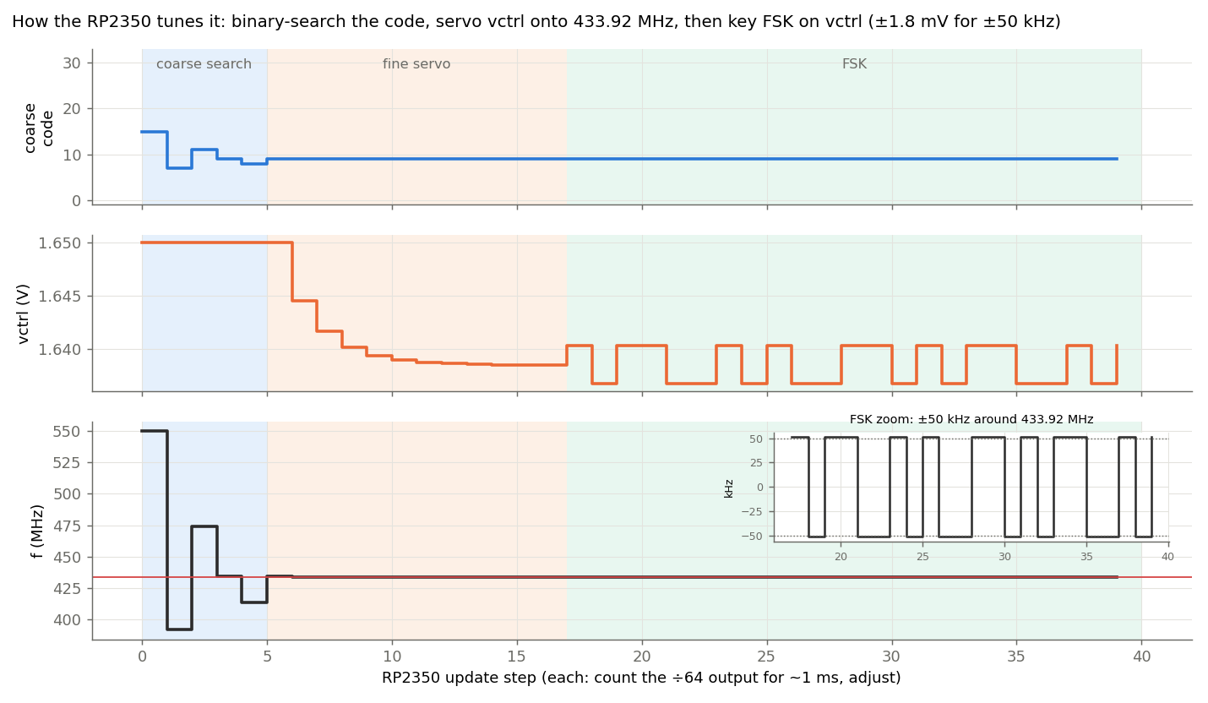
docs/img/tuning_recipe.png
