mattvenn/gf-433-oscillator/layout/pex/ring_core_v3_w30chk_rc.spice

* ring_core: magic R+C extraction of layout/ring_core.gds (layout/gen/pex.sh)
* extracted 2026-11-12T17:48:51+01:00 with magic 8.3.642, mode rc, from ring_core_v3.gds
.subckt ring_core VDD VSS vbn vctrl bit0 bit1 bit2 bit3 bit4 bitb0 bitb1 bitb2 bitb3 bitb4 vg a0 a1 a2 a3 a4
X0 a_6356_6633# bitb0.t0 VSS.t29 VSS.t28 nfet_03v3 ad=0.45p pd=2.9u as=0.45p ps=2.9u w=1u l=0.28u
X1 vg.t20 a_6206_896# VSS.t15 VSS.t14 nfet_03v3 ad=0.336p pd=1.76u as=0.336p ps=1.76u w=1.2u l=5.335u
X2 vg.t35 a_6206_14# VSS.t48 VSS.t14 nfet_03v3 ad=0.336p pd=1.76u as=0.336p ps=1.76u w=1.2u l=5.335u
X3 VDD.t11 vg.t45 VDD.t11 VDD.t10 pfet_03v3 ad=8.3496p pd=30.38u as=0 ps=0 w=29.82u l=4.12u
X4 a3.t1 a2.t3 VDD.t20 VDD.t19 pfet_03v3 ad=2.25p pd=10.9u as=2.25p ps=10.9u w=5u l=0.28u
X5 vbn.t7 bit2.t0 a_6206_4704# VSS.t62 nfet_03v3 ad=0.9p pd=4.9u as=0.9p ps=4.9u w=2u l=0.28u
X6 VDD.t7 vg.t47 VDD.t7 VDD.t6 pfet_03v3 ad=8.3496p pd=30.38u as=0 ps=0 w=29.82u l=4.12u
X7 a4.t1 a3.t3 VDD.t3 VDD.t2 pfet_03v3 ad=2.25p pd=10.9u as=2.25p ps=10.9u w=5u l=0.28u
X8 a_6206_14# bitb4.t0 VSS.t40 VSS.t39 nfet_03v3 ad=0.45p pd=2.9u as=0.45p ps=2.9u w=1u l=0.28u
X9 VSS.t34 vbn.t12 vg.t10 VSS.t22 nfet_03v3 ad=0.336p pd=1.76u as=0.336p ps=1.76u w=1.2u l=5.335u
X10 vg.t25 a4.t2 a0.t1 VSS.t1 nfet_03v3 ad=0.9p pd=4.9u as=0.9p ps=4.9u w=2u l=0.28u
X11 vbn.t9 bit0.t0 a_6356_6633# VSS.t64 nfet_03v3 ad=0.9p pd=4.9u as=0.9p ps=4.9u w=2u l=0.28u
X12 VSS.t53 a_6206_14# vg.t27 VSS.t22 nfet_03v3 ad=0.336p pd=1.76u as=0.336p ps=1.76u w=1.2u l=5.335u
X13 vbn.t1 bitb3.t1 a_6206_896# VDD.t26 pfet_03v3 ad=2.25p pd=10.9u as=2.25p ps=10.9u w=5u l=0.28u
X14 VSS.t49 a_6206_14# vg.t32 VSS.t22 nfet_03v3 ad=0.336p pd=1.76u as=0.336p ps=1.76u w=1.2u l=5.335u
X15 VSS.t10 vctrl.t0 vg.t8 VSS.t4 nfet_03v3 ad=0.54p pd=3.3u as=0.336p ps=1.76u w=1.2u l=21.335u
X16 a2.t1 a1.t2 vg.t3 VSS.t59 nfet_03v3 ad=0.9p pd=4.9u as=0.9p ps=4.9u w=2u l=0.28u
X17 VSS.t32 vbn.t14 vg.t9 VSS.t22 nfet_03v3 ad=0.336p pd=1.76u as=0.336p ps=1.76u w=1.2u l=5.335u
X18 VSS.t43 a_6206_14# vg.t40 VSS.t22 nfet_03v3 ad=0.336p pd=1.76u as=0.336p ps=1.76u w=1.2u l=5.335u
X19 vbn.t3 bitb2.t1 a_6206_4704# VDD.t16 pfet_03v3 ad=2.25p pd=10.9u as=2.25p ps=10.9u w=5u l=0.28u
X20 vbn.t6 bit4.t0 a_6206_14# VSS.t41 nfet_03v3 ad=0.9p pd=4.9u as=0.9p ps=4.9u w=2u l=0.28u
X21 a_7096_6633# bitb1.t0 VSS.t27 VSS.t26 nfet_03v3 ad=0.45p pd=2.9u as=0.45p ps=2.9u w=1u l=0.28u
X22 VSS.t20 a_6206_896# vg.t16 VSS.t8 nfet_03v3 ad=0.54p pd=3.3u as=0.336p ps=1.76u w=1.2u l=5.335u
X23 vg.t33 a_6206_14# VSS.t58 VSS.t14 nfet_03v3 ad=0.336p pd=1.76u as=0.336p ps=1.76u w=1.2u l=5.335u
X24 vg.t4 a_6206_4704# VSS.t7 VSS.t6 nfet_03v3 ad=0.336p pd=1.76u as=0.336p ps=1.76u w=1.2u l=5.335u
X25 VDD.t1 a4.t3 a0.t0 VDD.t0 pfet_03v3 ad=2.25p pd=10.9u as=2.25p ps=10.9u w=5u l=0.28u
X26 vbn.t2 bitb0.t1 a_6356_6633# VDD.t18 pfet_03v3 ad=2.25p pd=10.9u as=2.25p ps=10.9u w=5u l=0.28u
X27 VDD.t5 vg.t48 VDD.t5 VDD.t4 pfet_03v3 ad=13.419p pd=60.54u as=0 ps=0 w=29.82u l=4.12u
X28 vg.t17 a_6206_896# VSS.t18 VSS.t6 nfet_03v3 ad=0.336p pd=1.76u as=0.336p ps=1.76u w=1.2u l=5.335u
X29 VSS.t50 a_6206_14# vg.t39 VSS.t8 nfet_03v3 ad=0.54p pd=3.3u as=0.336p ps=1.76u w=1.2u l=5.335u
X30 vg.t14 a_7096_6633# VSS.t13 VSS.t6 nfet_03v3 ad=0.336p pd=1.76u as=0.336p ps=1.76u w=1.2u l=5.335u
X31 VSS.t55 a_6206_14# vg.t30 VSS.t8 nfet_03v3 ad=0.54p pd=3.3u as=0.336p ps=1.76u w=1.2u l=5.335u
X32 VSS.t36 vbn.t10 vg.t12 VSS.t4 nfet_03v3 ad=0.336p pd=1.76u as=0.336p ps=1.76u w=1.2u l=5.335u
X33 a_6206_4704# bitb2.t0 VSS.t25 VSS.t24 nfet_03v3 ad=0.45p pd=2.9u as=0.45p ps=2.9u w=1u l=0.28u
X34 VSS.t9 a_6206_4704# vg.t5 VSS.t8 nfet_03v3 ad=0.54p pd=3.3u as=0.336p ps=1.76u w=1.2u l=5.335u
X35 VSS.t16 a_6206_896# vg.t21 VSS.t8 nfet_03v3 ad=0.54p pd=3.3u as=0.336p ps=1.76u w=1.2u l=5.335u
X36 a2.t0 a1.t3 VDD.t25 VDD.t24 pfet_03v3 ad=2.25p pd=10.9u as=2.25p ps=10.9u w=5u l=0.28u
X37 VDD.t13 vg.t44 VDD.t13 VDD.t12 pfet_03v3 ad=8.3496p pd=30.38u as=0 ps=0 w=29.82u l=4.12u
X38 VSS.t45 a_6206_14# vg.t29 VSS.t8 nfet_03v3 ad=0.54p pd=3.3u as=0.336p ps=1.76u w=1.2u l=5.335u
X39 vg.t28 a_6206_14# VSS.t47 VSS.t6 nfet_03v3 ad=0.336p pd=1.76u as=0.336p ps=1.76u w=1.2u l=5.335u
X40 vg.t26 a_6206_14# VSS.t57 VSS.t6 nfet_03v3 ad=0.336p pd=1.76u as=0.336p ps=1.76u w=1.2u l=5.335u
X41 vbn.t8 bit1.t0 a_7096_6633# VSS.t63 nfet_03v3 ad=0.9p pd=4.9u as=0.9p ps=4.9u w=2u l=0.28u
X42 vg.t1 vbn.t15 VSS.t31 VSS.t6 nfet_03v3 ad=0.336p pd=1.76u as=0.336p ps=1.76u w=1.2u l=5.335u
X43 vg.t23 a_6356_6633# VSS.t38 VSS.t37 nfet_03v3 ad=0.336p pd=1.76u as=0.54p ps=3.3u w=1.2u l=5.335u
X44 vg.t31 a_6206_14# VSS.t51 VSS.t2 nfet_03v3 ad=0.336p pd=1.76u as=0.54p ps=3.3u w=1.2u l=5.335u
X45 vbn.t4 bitb4.t1 a_6206_14# VDD.t21 pfet_03v3 ad=2.25p pd=10.9u as=2.25p ps=10.9u w=5u l=0.28u
X46 a1.t1 a0.t2 vg.t24 VSS.t42 nfet_03v3 ad=0.9p pd=4.9u as=0.9p ps=4.9u w=2u l=0.28u
X47 VDD.t9 vg.t46 VDD.t9 VDD.t8 pfet_03v3 ad=8.3496p pd=30.38u as=0 ps=0 w=29.82u l=4.12u
X48 a_6206_896# bitb3.t0 VSS.t61 VSS.t60 nfet_03v3 ad=0.45p pd=2.9u as=0.45p ps=2.9u w=1u l=0.28u
X49 vg.t19 a_6206_896# VSS.t17 VSS.t2 nfet_03v3 ad=0.336p pd=1.76u as=0.54p ps=3.3u w=1.2u l=5.335u
X50 vg.t15 a_6206_896# VSS.t21 VSS.t2 nfet_03v3 ad=0.336p pd=1.76u as=0.54p ps=3.3u w=1.2u l=5.335u
X51 VSS.t19 a_6206_896# vg.t22 VSS.t4 nfet_03v3 ad=0.336p pd=1.76u as=0.336p ps=1.76u w=1.2u l=5.335u
X52 VSS.t23 a_6206_896# vg.t18 VSS.t22 nfet_03v3 ad=0.336p pd=1.76u as=0.336p ps=1.76u w=1.2u l=5.335u
X53 VSS.t5 a_6206_4704# vg.t6 VSS.t4 nfet_03v3 ad=0.336p pd=1.76u as=0.336p ps=1.76u w=1.2u l=5.335u
X54 VSS.t54 a_6206_14# vg.t34 VSS.t4 nfet_03v3 ad=0.336p pd=1.76u as=0.336p ps=1.76u w=1.2u l=5.335u
X55 a3.t0 a2.t2 vg.t2 VSS.t30 nfet_03v3 ad=0.9p pd=4.9u as=0.9p ps=4.9u w=2u l=0.28u
X56 vg.t36 a_6206_14# VSS.t46 VSS.t2 nfet_03v3 ad=0.336p pd=1.76u as=0.54p ps=3.3u w=1.2u l=5.335u
X57 vg.t7 a_6206_4704# VSS.t3 VSS.t2 nfet_03v3 ad=0.336p pd=1.76u as=0.54p ps=3.3u w=1.2u l=5.335u
X58 vg.t38 a_6206_14# VSS.t52 VSS.t14 nfet_03v3 ad=0.336p pd=1.76u as=0.336p ps=1.76u w=1.2u l=5.335u
X59 vg.t37 a_6206_14# VSS.t56 VSS.t2 nfet_03v3 ad=0.336p pd=1.76u as=0.54p ps=3.3u w=1.2u l=5.335u
X60 a4.t0 a3.t2 vg.t11 VSS.t11 nfet_03v3 ad=0.9p pd=4.9u as=0.9p ps=4.9u w=2u l=0.28u
X61 vg.t42 vbn.t13 VSS.t33 VSS.t14 nfet_03v3 ad=0.336p pd=1.76u as=0.336p ps=1.76u w=1.2u l=5.335u
X62 vg.t0 vbn.t11 VSS.t35 VSS.t14 nfet_03v3 ad=0.336p pd=1.76u as=0.336p ps=1.76u w=1.2u l=5.335u
X63 VSS.t44 a_6206_14# vg.t41 VSS.t4 nfet_03v3 ad=0.336p pd=1.76u as=0.336p ps=1.76u w=1.2u l=5.335u
X64 VSS.t12 a_7096_6633# vg.t13 VSS.t4 nfet_03v3 ad=0.336p pd=1.76u as=0.336p ps=1.76u w=1.2u l=5.335u
X65 vbn.t5 bitb1.t1 a_7096_6633# VDD.t17 pfet_03v3 ad=2.25p pd=10.9u as=2.25p ps=10.9u w=5u l=0.28u
X66 VDD.t15 vg.t43 VDD.t15 VDD.t14 pfet_03v3 ad=8.3496p pd=30.38u as=0 ps=0 w=29.82u l=4.12u
X67 a1.t0 a0.t3 VDD.t23 VDD.t22 pfet_03v3 ad=2.25p pd=10.9u as=2.25p ps=10.9u w=5u l=0.28u
X68 vbn.t0 bit3.t0 a_6206_896# VSS.t0 nfet_03v3 ad=0.9p pd=4.9u as=0.9p ps=4.9u w=2u l=0.28u
R0 vctrl vctrl.t0 33.6536
R1 vg.n46 vg.t43 31.0276
R2 vg.n17 vg.t48 26.4187
R3 vg.n21 vg.t47 26.4187
R4 vg.n29 vg.t46 26.4187
R5 vg.n36 vg.t45 26.4187
R6 vg.n43 vg.t44 26.4187
R7 vg.n17 vg.n16 21.9053
R8 vg.n21 vg.n9 21.9053
R9 vg.n22 vg.n21 21.9053
R10 vg.n29 vg.n6 21.9053
R11 vg.n36 vg.n35 21.9053
R12 vg.n44 vg.n43 21.9053
R13 vg.n43 vg.n2 21.9053
R14 vg.n67 vg.n66 14.5769
R15 vg.n50 vg.n48 10.4429
R16 vg.n56 vg.n54 10.4429
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
C275 bitb2.t0 VSS 0.10887f
C276 bitb2.n0 VSS 0.61518f
C277 bitb3.t1 VSS 0.35743f
C278 bitb3.t0 VSS 0.1089f
C279 bitb3.n0 VSS 0.61536f
C280 bitb4.t1 VSS 0.35543f
C281 bitb4.t0 VSS 0.1083f
C282 bitb4.n0 VSS 0.61192f
C283 vbn.t9 VSS 0.31997f
C284 vbn.t2 VSS 0.40376f
C285 vbn.n0 VSS 1.02223f
C286 vbn.t8 VSS 0.31997f
C287 vbn.t5 VSS 0.40376f
C288 vbn.n1 VSS 0.99067f
C289 vbn.n2 VSS 0.56692f
C290 vbn.t7 VSS 0.31997f
C291 vbn.t3 VSS 0.40376f
C292 vbn.n3 VSS 0.99067f
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
