mattvenn/gf-433-oscillator/layout/pex/vco_top_c.spice

* vco_top: magic R+C extraction of layout/vco_top.gds (layout/gen/pex.sh)
* extracted 2026-11-12T17:49:18+01:00 with magic 8.3.642, mode c, from vco_top.gds
.subckt vco_top VDD VDD_LS VSS vctrl bit0 bit1 bit2 bit3 bit4 bitb0 bitb1 bitb2 bitb3 bitb4 ck a0 vbn vg ls vbnf
X0 a_36888_1807# vbn a_37178_2387# VSS nfet_03v3 ad=0.9p pd=4.9u as=0.56p ps=2.56u w=2u l=1u
X1 a_37178_4707# vbn a_36888_4127# VSS nfet_03v3 ad=0.56p pd=2.56u as=0.56p ps=2.56u w=2u l=1u
X2 a_36888_7607# vbn a_37178_8187# VSS nfet_03v3 ad=0.56p pd=2.56u as=0.56p ps=2.56u w=2u l=1u
X3 vg a_6206_14# VSS VSS nfet_03v3 ad=0.336p pd=1.76u as=0.336p ps=1.76u w=1.2u l=5.335u
X4 a_37178_3547# vbn a_36888_2967# VSS nfet_03v3 ad=0.56p pd=2.56u as=0.56p ps=2.56u w=2u l=1u
X5 a_37178_8187# vbn a_36888_7607# VSS nfet_03v3 ad=0.56p pd=2.56u as=0.56p ps=2.56u w=2u l=1u
X6 a_36888_7607# vbn a_37178_7027# VSS nfet_03v3 ad=0.56p pd=2.56u as=0.56p ps=2.56u w=2u l=1u
X7 a_41564_2967# vbn a_41854_3547# VSS nfet_03v3 ad=0.56p pd=2.56u as=0.56p ps=2.56u w=2u l=1u
X8 a_41854_5867# vbn a_41564_6447# VSS nfet_03v3 ad=0.9p pd=4.9u as=0.56p ps=2.56u w=2u l=1u
X9 a_36866_9481# vbn a_37178_8187# VSS nfet_03v3 ad=0.56p pd=2.56u as=0.56p ps=2.56u w=2u l=1u
X10 a_37178_3547# vbn a_36888_4127# VSS nfet_03v3 ad=0.56p pd=2.56u as=0.56p ps=2.56u w=2u l=1u
X11 a_37178_2387# vbn a_36888_1807# VSS nfet_03v3 ad=0.56p pd=2.56u as=0.56p ps=2.56u w=2u l=1u
X12 a_37178_4707# vbn a_36888_5287# VSS nfet_03v3 ad=0.56p pd=2.56u as=0.56p ps=2.56u w=2u l=1u
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
X304 a_37178_1227# vbn a_36888_1807# VSS nfet_03v3 ad=0.56p pd=2.56u as=0.56p ps=2.56u w=2u l=1u
X305 a_41564_7607# vbn a_41854_7027# VSS nfet_03v3 ad=0.56p pd=2.56u as=0.56p ps=2.56u w=2u l=1u
X306 a_41854_4707# vbn a_41564_4127# VSS nfet_03v3 ad=0.56p pd=2.56u as=0.56p ps=2.56u w=2u l=1u
X307 a_36888_5287# vbn a_37178_4707# VSS nfet_03v3 ad=0.56p pd=2.56u as=0.56p ps=2.56u w=2u l=1u
X308 a_37178_8187# vbn a_36888_7607# VSS nfet_03v3 ad=0.56p pd=2.56u as=0.56p ps=2.56u w=2u l=1u
X309 a_36888_4127# vbn a_37178_4707# VSS nfet_03v3 ad=0.56p pd=2.56u as=0.56p ps=2.56u w=2u l=1u
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
