mattvenn/gf-433-oscillator/layout/pex/vco_top_rcx.spice

* vco_top: magic R+C extraction of layout/vco_top.gds (layout/gen/pex.sh)
* rcfix.py: split-net C to VSS scaled by (S - K) / S on 19 nets (coupling double count removed)
* extracted 2026-11-12T17:49:19+01:00 with magic 8.3.642, mode rc, from vco_top.gds
.subckt vco_top VDD VDD_LS VSS vctrl bit0 bit1 bit2 bit3 bit4 bitb0 bitb1 bitb2 bitb3 bitb4 ck a0 vbn vg ls vbnf
X0 a_36888_1807# vbn.t833 a_37178_2387# VSS.t93 nfet_03v3 ad=0.9p pd=4.9u as=0.56p ps=2.56u w=2u l=1u
X1 a_37178_4707# vbn.t515 a_36888_4127# VSS.t89 nfet_03v3 ad=0.56p pd=2.56u as=0.56p ps=2.56u w=2u l=1u
X2 a_36888_7607# vbn.t207 a_37178_8187# VSS.t83 nfet_03v3 ad=0.56p pd=2.56u as=0.56p ps=2.56u w=2u l=1u
X3 vg.t34 a_6206_14# VSS.t117 VSS.t11 nfet_03v3 ad=0.336p pd=1.76u as=0.336p ps=1.76u w=1.2u l=5.335u
X4 a_37178_3547# vbn.t872 a_36888_2967# VSS.t80 nfet_03v3 ad=0.56p pd=2.56u as=0.56p ps=2.56u w=2u l=1u
X5 a_37178_8187# vbn.t663 a_36888_7607# VSS.t83 nfet_03v3 ad=0.56p pd=2.56u as=0.56p ps=2.56u w=2u l=1u
X6 a_36888_7607# vbn.t654 a_37178_7027# VSS.t84 nfet_03v3 ad=0.56p pd=2.56u as=0.56p ps=2.56u w=2u l=1u
X7 a_41564_2967# vbn.t260 a_41854_3547# VSS.t91 nfet_03v3 ad=0.56p pd=2.56u as=0.56p ps=2.56u w=2u l=1u
X8 a_41854_5867# vbn.t294 a_41564_6447# VSS.t86 nfet_03v3 ad=0.9p pd=4.9u as=0.56p ps=2.56u w=2u l=1u
X9 a_36866_9481# vbn.t706 a_37178_8187# VSS.t82 nfet_03v3 ad=0.56p pd=2.56u as=0.56p ps=2.56u w=2u l=1u
X10 a_37178_3547# vbn.t112 a_36888_4127# VSS.t90 nfet_03v3 ad=0.56p pd=2.56u as=0.56p ps=2.56u w=2u l=1u
X11 a_37178_2387# vbn.t389 a_36888_1807# VSS.t93 nfet_03v3 ad=0.56p pd=2.56u as=0.56p ps=2.56u w=2u l=1u
X12 a_37178_4707# vbn.t136 a_36888_5287# VSS.t88 nfet_03v3 ad=0.56p pd=2.56u as=0.56p ps=2.56u w=2u l=1u
X13 a_36888_1807# vbn.t354 a_37178_1227# VSS.t94 nfet_03v3 ad=0.56p pd=2.56u as=0.56p ps=2.56u w=2u l=1u
X14 a_36888_7607# vbn.t205 a_37178_8187# VSS.t83 nfet_03v3 ad=0.56p pd=2.56u as=0.56p ps=2.56u w=2u l=1u
X15 a_6356_6633# bitb0.t0 VSS.t132 VSS.t131 nfet_03v3 ad=0.45p pd=2.9u as=0.45p ps=2.9u w=1u l=0.28u
X16 a_41564_2967# vbn.t255 a_41854_2387# VSS.t92 nfet_03v3 ad=0.56p pd=2.56u as=0.56p ps=2.56u w=2u l=1u
X17 a_37178_1227# vbn.t50 a_36888_1807# VSS.t94 nfet_03v3 ad=0.56p pd=2.56u as=0.56p ps=2.56u w=2u l=1u
X18 a_37178_4707# vbn.t896 a_36888_4127# VSS.t89 nfet_03v3 ad=0.56p pd=2.56u as=0.56p ps=2.56u w=2u l=1u
X19 a_36888_7607# vbn.t965 a_37178_7027# VSS.t84 nfet_03v3 ad=0.56p pd=2.56u as=0.56p ps=2.56u w=2u l=1u
X20 a_37178_7027# vbn.t956 a_36888_6447# VSS.t80 nfet_03v3 ad=0.56p pd=2.56u as=0.56p ps=2.56u w=2u l=1u
X21 a_41564_6447# vbn.t302 a_41854_7027# VSS.t85 nfet_03v3 ad=0.56p pd=2.56u as=0.56p ps=2.56u w=2u l=1u
X22 a_37178_8187# vbn.t711 a_36866_9481# VSS.t82 nfet_03v3 ad=0.56p pd=2.56u as=0.56p ps=2.56u w=2u l=1u
X23 a_36888_4127# vbn.t117 a_37178_3547# VSS.t90 nfet_03v3 ad=0.56p pd=2.56u as=0.56p ps=2.56u w=2u l=1u
X24 a_36888_1807# vbn.t394 a_37178_2387# VSS.t93 nfet_03v3 ad=0.56p pd=2.56u as=0.56p ps=2.56u w=2u l=1u
X25 vg.t5 a_6206_896# VSS.t12 VSS.t11 nfet_03v3 ad=0.336p pd=1.76u as=0.336p ps=1.76u w=1.2u l=5.335u
X26 VDD.t9 a_36866_9481# a_36866_9481# VDD.t8 pfet_03v3 ad=3.92p pd=14.56u as=3.92p ps=14.56u w=14u l=14u
X27 a_36888_4127# vbn.t498 a_37178_4707# VSS.t89 nfet_03v3 ad=0.56p pd=2.56u as=0.56p ps=2.56u w=2u l=1u
X28 a_37178_8187# vbn.t210 a_36888_7607# VSS.t83 nfet_03v3 ad=0.56p pd=2.56u as=0.56p ps=2.56u w=2u l=1u
X29 a_36888_5287# vbn.t550 a_37178_5867# VSS.t87 nfet_03v3 ad=0.56p pd=2.56u as=0.56p ps=2.56u w=2u l=1u
X30 a_37178_7027# vbn.t657 a_36888_7607# VSS.t84 nfet_03v3 ad=0.56p pd=2.56u as=0.9p ps=4.9u w=2u l=1u
X31 a_41854_3547# vbn.t263 a_41564_2967# VSS.t91 nfet_03v3 ad=0.56p pd=2.56u as=0.56p ps=2.56u w=2u l=1u
X32 a_41564_6447# vbn.t297 a_41854_5867# VSS.t86 nfet_03v3 ad=0.56p pd=2.56u as=0.56p ps=2.56u w=2u l=1u
X33 w_36826_300# vbn.t342 a_37178_1227# VSS.t95 nfet_03v3 ad=0.56p pd=2.56u as=0.56p ps=2.56u w=2u l=1u
X34 a_37178_4707# vbn.t124 a_36888_4127# VSS.t89 nfet_03v3 ad=0.56p pd=2.56u as=0.56p ps=2.56u w=2u l=1u
X35 a_36888_4127# vbn.t115 a_37178_3547# VSS.t90 nfet_03v3 ad=0.56p pd=2.56u as=0.56p ps=2.56u w=2u l=1u
X36 a_36888_1807# vbn.t55 a_37178_1227# VSS.t94 nfet_03v3 ad=0.56p pd=2.56u as=0.56p ps=2.56u w=2u l=1u
X37 a_37178_5867# vbn.t148 a_36888_5287# VSS.t87 nfet_03v3 ad=0.56p pd=2.56u as=0.56p ps=2.56u w=2u l=1u
X38 a_37178_8187# vbn.t994 a_36866_9481# VSS.t82 nfet_03v3 ad=0.56p pd=2.56u as=0.56p ps=2.56u w=2u l=1u
X39 a_37178_2387# vbn.t850 a_36888_2967# VSS.t92 nfet_03v3 ad=0.56p pd=2.56u as=0.56p ps=2.56u w=2u l=1u
X40 a_36888_7607# vbn.t215 a_37178_8187# VSS.t83 nfet_03v3 ad=0.56p pd=2.56u as=0.56p ps=2.56u w=2u l=1u
X41 VSS.t6 a_n5549_6703# q1 VSS.t5 nfet_03v3 ad=0.27p pd=2.1u as=0.6p ps=3.2u w=0.6u l=0.28u
X42 a_36888_4127# vbn.t899 a_37178_4707# VSS.t81 nfet_03v3 ad=0.56p pd=2.56u as=0.56p ps=2.56u w=2u l=1u
X43 a_36866_9481# vbn.t694 a_37178_8187# VSS.t82 nfet_03v3 ad=0.56p pd=2.56u as=0.56p ps=2.56u w=2u l=1u
X44 a_37178_7027# vbn.t968 a_36888_7607# VSS.t84 nfet_03v3 ad=0.56p pd=2.56u as=0.56p ps=2.56u w=2u l=1u
X45 a_36888_4127# vbn.t486 a_37178_3547# VSS.t90 nfet_03v3 ad=0.56p pd=2.56u as=0.56p ps=2.56u w=2u l=1u
X46 a_41854_7027# vbn.t305 a_41564_6447# VSS.t85 nfet_03v3 ad=0.56p pd=2.56u as=0.56p ps=2.56u w=2u l=1u
X47 a_37178_1227# vbn.t347 w_36826_300# VSS.t95 nfet_03v3 ad=0.56p pd=2.56u as=0.56p ps=2.56u w=2u l=1u
X48 a_36888_5287# vbn.t538 a_37178_4707# VSS.t88 nfet_03v3 ad=0.56p pd=2.56u as=0.56p ps=2.56u w=2u l=1u
X49 a_36888_5287# vbn.t153 a_37178_5867# VSS.t87 nfet_03v3 ad=0.56p pd=2.56u as=0.56p ps=2.56u w=2u l=1u
X50 a_36888_7607# vbn.t213 a_37178_8187# VSS.t83 nfet_03v3 ad=0.56p pd=2.56u as=0.56p ps=2.56u w=2u l=1u
X51 a_37178_8187# vbn.t222 a_36866_9481# VSS.t82 nfet_03v3 ad=0.56p pd=2.56u as=0.56p ps=2.56u w=2u l=1u
X52 VDD.t35 vg.t45 VDD.t35 VDD.t34 pfet_03v3 ad=8.3496p pd=30.38u as=0 ps=0 w=29.82u l=4.12u
X53 a_37178_5867# vbn.t934 a_36888_6447# VSS.t86 nfet_03v3 ad=0.56p pd=2.56u as=0.56p ps=2.56u w=2u l=1u
X54 a_36888_2967# vbn.t420 a_37178_2387# VSS.t92 nfet_03v3 ad=0.56p pd=2.56u as=0.56p ps=2.56u w=2u l=1u
X55 a_36888_4127# vbn.t881 a_37178_3547# VSS.t90 nfet_03v3 ad=0.56p pd=2.56u as=0.56p ps=2.56u w=2u l=1u
X56 a_37178_1227# vbn.t812 w_36826_300# VSS.t95 nfet_03v3 ad=0.56p pd=2.56u as=0.56p ps=2.56u w=2u l=1u
X57 a_36866_9481# vbn.t997 a_37178_8187# VSS.t81 nfet_03v3 ad=0.56p pd=2.56u as=0.56p ps=2.56u w=2u l=1u
X58 a_37178_4707# vbn.t543 a_36888_5287# VSS.t88 nfet_03v3 ad=0.56p pd=2.56u as=0.56p ps=2.56u w=2u l=1u
X59 a_36888_7607# vbn.t682 a_37178_8187# VSS.t83 nfet_03v3 ad=0.56p pd=2.56u as=0.56p ps=2.56u w=2u l=1u
X60 w_36826_300# vbn.t330 a_37178_1227# VSS.t95 nfet_03v3 ad=0.56p pd=2.56u as=0.56p ps=2.56u w=2u l=1u
X61 a_37178_3547# vbn.t489 a_36888_4127# VSS.t90 nfet_03v3 ad=0.56p pd=2.56u as=0.9p ps=4.9u w=2u l=1u
X62 a_41854_7027# vbn.t310 a_41564_7607# VSS.t84 nfet_03v3 ad=0.56p pd=2.56u as=0.56p ps=2.56u w=2u l=1u
X63 a_37178_1227# vbn.t373 a_36888_1807# VSS.t94 nfet_03v3 ad=0.56p pd=2.56u as=0.56p ps=2.56u w=2u l=1u
X64 a_36888_1807# vbn.t382 a_37178_2387# VSS.t93 nfet_03v3 ad=0.56p pd=2.56u as=0.56p ps=2.56u w=2u l=1u
X65 a_36888_6447# vbn.t588 a_37178_5867# VSS.t86 nfet_03v3 ad=0.56p pd=2.56u as=0.56p ps=2.56u w=2u l=1u
X66 a_37178_2387# vbn.t425 a_36888_2967# VSS.t92 nfet_03v3 ad=0.56p pd=2.56u as=0.56p ps=2.56u w=2u l=1u
X67 a_37178_1227# vbn.t40 w_36826_300# VSS.t95 nfet_03v3 ad=0.56p pd=2.56u as=0.56p ps=2.56u w=2u l=1u
X68 a_n4384_6451# a_n4642_7514# a_n5234_7514# VSS.t74 nfet_03v3 ad=0.28p pd=1.56u as=1p ps=4u w=1u l=0.28u
X69 a_37178_2387# vbn.t64 a_36888_1807# VSS.t93 nfet_03v3 ad=0.56p pd=2.56u as=0.56p ps=2.56u w=2u l=1u
X70 a_37178_4707# vbn.t910 a_36888_5287# VSS.t88 nfet_03v3 ad=0.56p pd=2.56u as=0.56p ps=2.56u w=2u l=1u
X71 a_37178_1227# vbn.t371 a_36888_1807# VSS.t94 nfet_03v3 ad=0.56p pd=2.56u as=0.56p ps=2.56u w=2u l=1u
X72 a_36888_7607# vbn.t979 a_37178_8187# VSS.t83 nfet_03v3 ad=0.56p pd=2.56u as=0.56p ps=2.56u w=2u l=1u
X73 a_41564_4127# vbn.t759 a_41854_4707# VSS.t89 nfet_03v3 ad=0.56p pd=2.56u as=0.56p ps=2.56u w=2u l=1u
X74 a_37178_3547# vbn.t884 a_36888_4127# VSS.t90 nfet_03v3 ad=0.56p pd=2.56u as=0.56p ps=2.56u w=2u l=1u
X75 a_37178_1227# vbn.t824 a_36888_1807# VSS.t94 nfet_03v3 ad=0.56p pd=2.56u as=0.56p ps=2.56u w=2u l=1u
X76 w_36826_300# vbn.t815 a_37178_1227# VSS.t81 nfet_03v3 ad=0.56p pd=2.56u as=0.56p ps=2.56u w=2u l=1u
X77 a_36888_5287# vbn.t526 a_37178_4707# VSS.t88 nfet_03v3 ad=0.56p pd=2.56u as=0.56p ps=2.56u w=2u l=1u
X78 a_36888_2967# vbn.t434 a_37178_3547# VSS.t91 nfet_03v3 ad=0.9p pd=4.9u as=0.56p ps=2.56u w=2u l=1u
X79 a_36888_7607# vbn.t640 a_37178_7027# VSS.t84 nfet_03v3 ad=0.56p pd=2.56u as=0.56p ps=2.56u w=2u l=1u
X80 a_37178_5867# vbn.t593 a_36888_6447# VSS.t86 nfet_03v3 ad=0.56p pd=2.56u as=0.56p ps=2.56u w=2u l=1u
X81 a_37178_5867# vbn.t569 a_36888_5287# VSS.t87 nfet_03v3 ad=0.56p pd=2.56u as=0.56p ps=2.56u w=2u l=1u
X82 a_37178_8187# vbn.t685 a_36888_7607# VSS.t83 nfet_03v3 ad=0.56p pd=2.56u as=0.9p ps=4.9u w=2u l=1u
X83 a_36888_1807# vbn.t69 a_37178_2387# VSS.t93 nfet_03v3 ad=0.56p pd=2.56u as=0.56p ps=2.56u w=2u l=1u
X84 a_41564_4127# vbn.t757 a_41854_4707# VSS.t89 nfet_03v3 ad=0.56p pd=2.56u as=0.56p ps=2.56u w=2u l=1u
X85 a_41854_1227# vbn.t723 a_41564_1807# VSS.t94 nfet_03v3 ad=0.56p pd=2.56u as=0.56p ps=2.56u w=2u l=1u
X86 a_37178_4707# vbn.t138 a_36888_5287# VSS.t88 nfet_03v3 ad=0.56p pd=2.56u as=0.56p ps=2.56u w=2u l=1u
X87 a_36888_1807# vbn.t376 a_37178_1227# VSS.t94 nfet_03v3 ad=0.56p pd=2.56u as=0.56p ps=2.56u w=2u l=1u
X88 a_37178_5867# vbn.t567 a_36888_5287# VSS.t87 nfet_03v3 ad=0.56p pd=2.56u as=0.56p ps=2.56u w=2u l=1u
X89 a_36888_2967# vbn.t428 a_37178_2387# VSS.t92 nfet_03v3 ad=0.56p pd=2.56u as=0.56p ps=2.56u w=2u l=1u
X90 vbn.t12 vbn.t11 a_41854_8187# VSS.t82 nfet_03v3 ad=0.56p pd=2.56u as=0.56p ps=2.56u w=2u l=1u
X91 a_36888_6447# vbn.t602 a_37178_7027# VSS.t85 nfet_03v3 ad=0.9p pd=4.9u as=0.56p ps=2.56u w=2u l=1u
X92 a_37178_5867# vbn.t922 a_36888_5287# VSS.t87 nfet_03v3 ad=0.56p pd=2.56u as=0.56p ps=2.56u w=2u l=1u
X93 a_36888_5287# vbn.t913 a_37178_4707# VSS.t81 nfet_03v3 ad=0.56p pd=2.56u as=0.56p ps=2.56u w=2u l=1u
X94 a_37178_7027# vbn.t645 a_36888_7607# VSS.t84 nfet_03v3 ad=0.56p pd=2.56u as=0.56p ps=2.56u w=2u l=1u
X95 a_37178_8187# vbn.t982 a_36888_7607# VSS.t83 nfet_03v3 ad=0.56p pd=2.56u as=0.56p ps=2.56u w=2u l=1u
X96 a_36888_7607# vbn.t961 a_37178_7027# VSS.t84 nfet_03v3 ad=0.56p pd=2.56u as=0.56p ps=2.56u w=2u l=1u
X97 a_41854_4707# vbn.t762 a_41564_4127# VSS.t89 nfet_03v3 ad=0.56p pd=2.56u as=0.9p ps=4.9u w=2u l=1u
X98 a_37178_3547# vbn.t437 a_36888_2967# VSS.t91 nfet_03v3 ad=0.56p pd=2.56u as=0.56p ps=2.56u w=2u l=1u
X99 a_37178_2387# vbn.t413 a_36888_2967# VSS.t92 nfet_03v3 ad=0.56p pd=2.56u as=0.56p ps=2.56u w=2u l=1u
X100 a_36888_1807# vbn.t827 a_37178_1227# VSS.t94 nfet_03v3 ad=0.56p pd=2.56u as=0.56p ps=2.56u w=2u l=1u
X101 a_41854_5867# vbn.t772 a_41564_5287# VSS.t87 nfet_03v3 ad=0.56p pd=2.56u as=0.56p ps=2.56u w=2u l=1u
X102 vbn.t16 vbn.t15 a_41854_8187# VSS.t82 nfet_03v3 ad=0.56p pd=2.56u as=0.56p ps=2.56u w=2u l=1u
X103 a_37178_7027# vbn.t643 a_36888_7607# VSS.t84 nfet_03v3 ad=0.56p pd=2.56u as=0.56p ps=2.56u w=2u l=1u
X104 a_36888_6447# vbn.t596 a_37178_5867# VSS.t86 nfet_03v3 ad=0.56p pd=2.56u as=0.56p ps=2.56u w=2u l=1u
X105 a_36888_5287# vbn.t572 a_37178_5867# VSS.t87 nfet_03v3 ad=0.56p pd=2.56u as=0.56p ps=2.56u w=2u l=1u
X106 a_41854_3547# vbn.t268 a_41564_4127# VSS.t90 nfet_03v3 ad=0.56p pd=2.56u as=0.56p ps=2.56u w=2u l=1u
X107 a_1867_7085# a_1632_6633# VDD.t21 VDD.t20 pfet_03v3 ad=2.25p pd=10.9u as=2.25p ps=10.9u w=5u l=0.28u
X108 a_36888_2967# vbn.t91 a_37178_3547# VSS.t91 nfet_03v3 ad=0.9p pd=4.9u as=0.56p ps=2.56u w=2u l=1u
X109 VSS.t139 a_n7601_6703# a_n8217_6703# VSS.t138 nfet_03v3 ad=0.27p pd=2.1u as=0.6p ps=3.2u w=0.6u l=0.28u
X110 a_36888_1807# vbn.t57 a_37178_1227# VSS.t94 nfet_03v3 ad=0.56p pd=2.56u as=0.56p ps=2.56u w=2u l=1u
X111 VSS.t99 vbn.t717 a_41854_1227# VSS.t95 nfet_03v3 ad=0.56p pd=2.56u as=0.56p ps=2.56u w=2u l=1u
X112 VDD_LS.t5 a_n5549_6703# q1 VDD_LS.t4 pfet_03v3 ad=0.675p pd=3.9u as=1.5p ps=5u w=1.5u l=0.28u
X113 a_37178_1227# vbn.t832 a_36888_1807# VSS.t78 nfet_03v3 ad=0.56p pd=2.56u as=0.9p ps=4.9u w=2u l=1u
X114 a_41854_8187# vbn.t5 vbn.t6 VSS.t82 nfet_03v3 ad=0.56p pd=2.56u as=0.9p ps=4.9u w=2u l=1u
X115 a_37178_7027# vbn.t605 a_36888_6447# VSS.t85 nfet_03v3 ad=0.56p pd=2.56u as=0.56p ps=2.56u w=2u l=1u
X116 a_37178_5867# vbn.t581 a_36888_6447# VSS.t86 nfet_03v3 ad=0.56p pd=2.56u as=0.56p ps=2.56u w=2u l=1u
X117 a_36888_5287# vbn.t925 a_37178_5867# VSS.t87 nfet_03v3 ad=0.56p pd=2.56u as=0.56p ps=2.56u w=2u l=1u
X118 a_36888_7607# vbn.t648 a_37178_7027# VSS.t84 nfet_03v3 ad=0.56p pd=2.56u as=0.56p ps=2.56u w=2u l=1u
X119 a_36866_9481# a_36866_9481# VDD.t7 VDD.t6 pfet_03v3 ad=3.92p pd=14.56u as=3.92p ps=14.56u w=14u l=14u
X120 a_36888_4127# vbn.t472 a_37178_3547# VSS.t90 nfet_03v3 ad=0.56p pd=2.56u as=0.56p ps=2.56u w=2u l=1u
X121 a_41854_8187# vbn.t317 a_41564_7607# VSS.t83 nfet_03v3 ad=0.56p pd=2.56u as=0.56p ps=2.56u w=2u l=1u
X122 a_37178_2387# vbn.t401 a_36888_1807# VSS.t93 nfet_03v3 ad=0.56p pd=2.56u as=0.56p ps=2.56u w=2u l=1u
X123 VSS.t101 vbn.t715 a_41854_1227# VSS.t95 nfet_03v3 ad=0.56p pd=2.56u as=0.56p ps=2.56u w=2u l=1u
X124 a_36888_6447# vbn.t175 a_37178_7027# VSS.t85 nfet_03v3 ad=0.9p pd=4.9u as=0.56p ps=2.56u w=2u l=1u
X125 vbnf.t7 bit2.t0 a_6206_4704# VSS.t150 nfet_03v3 ad=0.9p pd=4.9u as=0.9p ps=4.9u w=2u l=0.28u
X126 a_37178_1227# vbn.t62 a_36888_1807# VSS.t94 nfet_03v3 ad=0.56p pd=2.56u as=0.9p ps=4.9u w=2u l=1u
X127 VDD.t31 vg.t47 VDD.t31 VDD.t30 pfet_03v3 ad=8.3496p pd=30.38u as=0 ps=0 w=29.82u l=4.12u
X128 a_37178_2387# vbn.t86 a_36888_2967# VSS.t92 nfet_03v3 ad=0.56p pd=2.56u as=0.56p ps=2.56u w=2u l=1u
X129 a_37178_2387# vbn.t399 a_36888_1807# VSS.t93 nfet_03v3 ad=0.56p pd=2.56u as=0.56p ps=2.56u w=2u l=1u
X130 a_36888_5287# vbn.t155 a_37178_5867# VSS.t87 nfet_03v3 ad=0.56p pd=2.56u as=0.56p ps=2.56u w=2u l=1u
X131 a_37178_5867# vbn.t930 a_36888_5287# VSS.t78 nfet_03v3 ad=0.56p pd=2.56u as=0.9p ps=4.9u w=2u l=1u
X132 a_41564_5287# vbn.t766 a_41854_4707# VSS.t88 nfet_03v3 ad=0.56p pd=2.56u as=0.56p ps=2.56u w=2u l=1u
X133 a_37178_3547# vbn.t477 a_36888_4127# VSS.t90 nfet_03v3 ad=0.56p pd=2.56u as=0.56p ps=2.56u w=2u l=1u
X134 VSS.t111 vbn.t34 a_60550_8387# VSS.t110 nfet_03v3 ad=0.9p pd=4.9u as=2.36p ps=6.36u w=2u l=0.28u
X135 a_37178_2387# vbn.t838 a_36888_1807# VSS.t93 nfet_03v3 ad=0.56p pd=2.56u as=0.56p ps=2.56u w=2u l=1u
X136 a_37178_1227# vbn.t60 a_36888_1807# VSS.t94 nfet_03v3 ad=0.56p pd=2.56u as=0.56p ps=2.56u w=2u l=1u
X137 a_36888_4127# vbn.t877 a_37178_3547# VSS.t90 nfet_03v3 ad=0.56p pd=2.56u as=0.56p ps=2.56u w=2u l=1u
X138 a_41854_1227# vbn.t720 VSS.t96 VSS.t95 nfet_03v3 ad=0.56p pd=2.56u as=0.9p ps=4.9u w=2u l=1u
X139 a_36888_7607# vbn.t668 a_37178_8187# VSS.t83 nfet_03v3 ad=0.56p pd=2.56u as=0.56p ps=2.56u w=2u l=1u
X140 a_36888_4127# vbn.t492 a_37178_4707# VSS.t89 nfet_03v3 ad=0.56p pd=2.56u as=0.56p ps=2.56u w=2u l=1u
X141 a_37178_7027# vbn.t631 a_36888_7607# VSS.t84 nfet_03v3 ad=0.56p pd=2.56u as=0.56p ps=2.56u w=2u l=1u
X142 a_41564_5287# vbn.t764 a_41854_4707# VSS.t88 nfet_03v3 ad=0.56p pd=2.56u as=0.56p ps=2.56u w=2u l=1u
X143 a_41854_2387# vbn.t730 a_41564_1807# VSS.t93 nfet_03v3 ad=0.56p pd=2.56u as=0.56p ps=2.56u w=2u l=1u
X144 a_41854_7027# vbn.t314 a_41564_7607# VSS.t84 nfet_03v3 ad=0.56p pd=2.56u as=0.9p ps=4.9u w=2u l=1u
X145 a_37178_1227# vbn.t359 a_36888_1807# VSS.t94 nfet_03v3 ad=0.56p pd=2.56u as=0.56p ps=2.56u w=2u l=1u
X146 a_37178_3547# vbn.t475 a_36888_4127# VSS.t90 nfet_03v3 ad=0.56p pd=2.56u as=0.56p ps=2.56u w=2u l=1u
X147 a_37178_3547# vbn.t451 a_36888_2967# VSS.t91 nfet_03v3 ad=0.56p pd=2.56u as=0.56p ps=2.56u w=2u l=1u
X148 a_36888_1807# vbn.t404 a_37178_2387# VSS.t93 nfet_03v3 ad=0.56p pd=2.56u as=0.56p ps=2.56u w=2u l=1u
X149 a_37178_5867# vbn.t160 a_36888_5287# VSS.t87 nfet_03v3 ad=0.56p pd=2.56u as=0.9p ps=4.9u w=2u l=1u
X150 a_37178_5867# vbn.t170 a_36888_6447# VSS.t86 nfet_03v3 ad=0.56p pd=2.56u as=0.56p ps=2.56u w=2u l=1u
X151 a_41564_4127# vbn.t278 a_41854_4707# VSS.t89 nfet_03v3 ad=0.56p pd=2.56u as=0.56p ps=2.56u w=2u l=1u
X152 a_37178_8187# vbn.t673 a_36888_7607# VSS.t83 nfet_03v3 ad=0.56p pd=2.56u as=0.56p ps=2.56u w=2u l=1u
X153 a_36888_7607# vbn.t636 a_37178_7027# VSS.t84 nfet_03v3 ad=0.56p pd=2.56u as=0.56p ps=2.56u w=2u l=1u
X154 a_36888_7607# vbn.t975 a_37178_8187# VSS.t83 nfet_03v3 ad=0.56p pd=2.56u as=0.56p ps=2.56u w=2u l=1u
X155 a_37178_5867# vbn.t158 a_36888_5287# VSS.t87 nfet_03v3 ad=0.56p pd=2.56u as=0.56p ps=2.56u w=2u l=1u
X156 a_41854_4707# vbn.t769 a_41564_5287# VSS.t88 nfet_03v3 ad=0.56p pd=2.56u as=0.9p ps=4.9u w=2u l=1u
X157 a_36866_9481# vbn.t688 a_37178_8187# VSS.t82 nfet_03v3 ad=0.56p pd=2.56u as=0.56p ps=2.56u w=2u l=1u
X158 a_36888_4127# vbn.t480 a_37178_3547# VSS.t90 nfet_03v3 ad=0.56p pd=2.56u as=0.56p ps=2.56u w=2u l=1u
X159 a_n4810_7514# a_n5549_6703# VDD_LS.t7 VDD_LS.t6 pfet_03v3 ad=0.56p pd=2.56u as=0.56p ps=2.56u w=2u l=0.28u
X160 a_36888_1807# vbn.t841 a_37178_2387# VSS.t93 nfet_03v3 ad=0.56p pd=2.56u as=0.56p ps=2.56u w=2u l=1u
X161 a_37178_1227# vbn.t820 a_36888_1807# VSS.t94 nfet_03v3 ad=0.56p pd=2.56u as=0.56p ps=2.56u w=2u l=1u
X162 a_37178_7027# vbn.t619 a_36888_6447# VSS.t85 nfet_03v3 ad=0.56p pd=2.56u as=0.56p ps=2.56u w=2u l=1u
X163 a_36888_4127# vbn.t889 a_37178_4707# VSS.t89 nfet_03v3 ad=0.9p pd=4.9u as=0.56p ps=2.56u w=2u l=1u
X164 a_41854_1227# vbn.t725 a_41564_1807# VSS.t94 nfet_03v3 ad=0.56p pd=2.56u as=0.56p ps=2.56u w=2u l=1u
X165 a_37178_8187# vbn.t671 a_36888_7607# VSS.t83 nfet_03v3 ad=0.56p pd=2.56u as=0.56p ps=2.56u w=2u l=1u
X166 a_37178_5867# vbn.t555 a_36888_5287# VSS.t87 nfet_03v3 ad=0.56p pd=2.56u as=0.56p ps=2.56u w=2u l=1u
X167 a_41854_2387# vbn.t735 a_41564_2967# VSS.t92 nfet_03v3 ad=0.9p pd=4.9u as=0.56p ps=2.56u w=2u l=1u
X168 a_36888_1807# vbn.t362 a_37178_1227# VSS.t94 nfet_03v3 ad=0.56p pd=2.56u as=0.56p ps=2.56u w=2u l=1u
X169 a_37178_4707# vbn.t501 a_36888_4127# VSS.t89 nfet_03v3 ad=0.56p pd=2.56u as=0.56p ps=2.56u w=2u l=1u
X170 vbn.t22 vbn.t21 a_41854_8187# VSS.t82 nfet_03v3 ad=0.56p pd=2.56u as=0.56p ps=2.56u w=2u l=1u
X171 a_36888_1807# vbn.t71 a_37178_2387# VSS.t93 nfet_03v3 ad=0.56p pd=2.56u as=0.56p ps=2.56u w=2u l=1u
X172 a_37178_7027# vbn.t192 a_36888_7607# VSS.t84 nfet_03v3 ad=0.56p pd=2.56u as=0.56p ps=2.56u w=2u l=1u
X173 a_37178_2387# vbn.t846 a_36888_1807# VSS.t78 nfet_03v3 ad=0.56p pd=2.56u as=0.9p ps=4.9u w=2u l=1u
X174 a_36888_2967# vbn.t865 a_37178_3547# VSS.t91 nfet_03v3 ad=0.56p pd=2.56u as=0.56p ps=2.56u w=2u l=1u
X175 a_996_6587# a_1867_7085# VDD.t41 VDD.t40 pfet_03v3 ad=2.25p pd=10.9u as=2.25p ps=10.9u w=5u l=0.28u
X176 a_36888_7607# vbn.t676 a_37178_8187# VSS.t83 nfet_03v3 ad=0.56p pd=2.56u as=0.56p ps=2.56u w=2u l=1u
X177 a_36866_9481# vbn.t987 a_37178_8187# VSS.t82 nfet_03v3 ad=0.9p pd=4.9u as=0.56p ps=2.56u w=2u l=1u
X178 a_37178_5867# vbn.t918 a_36888_5287# VSS.t87 nfet_03v3 ad=0.56p pd=2.56u as=0.56p ps=2.56u w=2u l=1u
X179 a_36888_1807# vbn.t831 a_37178_1227# VSS.t79 nfet_03v3 ad=0.56p pd=2.56u as=0.56p ps=2.56u w=2u l=1u
X180 a_41564_2967# vbn.t740 a_41854_2387# VSS.t92 nfet_03v3 ad=0.56p pd=2.56u as=0.56p ps=2.56u w=2u l=1u
X181 a_37178_3547# vbn.t463 a_36888_4127# VSS.t90 nfet_03v3 ad=0.56p pd=2.56u as=0.56p ps=2.56u w=2u l=1u
X182 w_36826_300# vbn.t324 a_37178_1227# VSS.t95 nfet_03v3 ad=0.56p pd=2.56u as=0.56p ps=2.56u w=2u l=1u
X183 a_41854_5867# vbn.t777 a_41564_6447# VSS.t86 nfet_03v3 ad=0.9p pd=4.9u as=0.56p ps=2.56u w=2u l=1u
X184 a_41854_5867# vbn.t774 a_41564_5287# VSS.t87 nfet_03v3 ad=0.56p pd=2.56u as=0.56p ps=2.56u w=2u l=1u
X185 a_36888_4127# vbn.t506 a_37178_4707# VSS.t89 nfet_03v3 ad=0.56p pd=2.56u as=0.56p ps=2.56u w=2u l=1u
X186 a_41854_3547# vbn.t272 a_41564_4127# VSS.t90 nfet_03v3 ad=0.56p pd=2.56u as=0.9p ps=4.9u w=2u l=1u
X187 a_37178_8187# vbn.t697 a_36866_9481# VSS.t82 nfet_03v3 ad=0.56p pd=2.56u as=0.56p ps=2.56u w=2u l=1u
X188 a_36888_5287# vbn.t558 a_37178_5867# VSS.t87 nfet_03v3 ad=0.56p pd=2.56u as=0.56p ps=2.56u w=2u l=1u
X189 a_36888_2967# vbn.t95 a_37178_3547# VSS.t91 nfet_03v3 ad=0.56p pd=2.56u as=0.56p ps=2.56u w=2u l=1u
X190 a_37178_2387# vbn.t76 a_36888_1807# VSS.t93 nfet_03v3 ad=0.56p pd=2.56u as=0.9p ps=4.9u w=2u l=1u
X191 a_37178_3547# vbn.t439 a_36888_2967# VSS.t91 nfet_03v3 ad=0.56p pd=2.56u as=0.56p ps=2.56u w=2u l=1u
X192 a_36888_6447# vbn.t949 a_37178_7027# VSS.t85 nfet_03v3 ad=0.56p pd=2.56u as=0.56p ps=2.56u w=2u l=1u
X193 VSS.t104 vbn.t236 a_41854_1227# VSS.t95 nfet_03v3 ad=0.56p pd=2.56u as=0.56p ps=2.56u w=2u l=1u
X194 a_41854_1227# vbn.t238 a_41564_1807# VSS.t94 nfet_03v3 ad=0.9p pd=4.9u as=0.56p ps=2.56u w=2u l=1u
X195 a_41564_6447# vbn.t782 a_41854_5867# VSS.t86 nfet_03v3 ad=0.56p pd=2.56u as=0.56p ps=2.56u w=2u l=1u
X196 a_36888_4127# vbn.t468 a_37178_3547# VSS.t90 nfet_03v3 ad=0.56p pd=2.56u as=0.56p ps=2.56u w=2u l=1u
X197 a_36888_2967# vbn.t93 a_37178_3547# VSS.t91 nfet_03v3 ad=0.56p pd=2.56u as=0.56p ps=2.56u w=2u l=1u
X198 a_37178_2387# vbn.t74 a_36888_1807# VSS.t93 nfet_03v3 ad=0.56p pd=2.56u as=0.56p ps=2.56u w=2u l=1u
X199 a_36866_9481# a_36866_9481# VDD.t11 VDD.t10 pfet_03v3 ad=3.92p pd=14.56u as=3.92p ps=14.56u w=14u l=14u
X200 a_36888_5287# vbn.t520 a_37178_4707# VSS.t88 nfet_03v3 ad=0.56p pd=2.56u as=0.56p ps=2.56u w=2u l=1u
X201 a_36888_5287# vbn.t929 a_37178_5867# VSS.t79 nfet_03v3 ad=0.56p pd=2.56u as=0.56p ps=2.56u w=2u l=1u
X202 a_37178_8187# vbn.t659 a_36888_7607# VSS.t83 nfet_03v3 ad=0.56p pd=2.56u as=0.56p ps=2.56u w=2u l=1u
X203 a_6206_14# bitb4.t0 VSS.t134 VSS.t133 nfet_03v3 ad=0.45p pd=2.9u as=0.45p ps=2.9u w=1u l=0.28u
X204 w_36826_300# vbn.t805 a_37178_1227# VSS.t95 nfet_03v3 ad=0.9p pd=4.9u as=0.56p ps=2.56u w=2u l=1u
X205 a_36866_9481# vbn.t702 a_37178_8187# VSS.t82 nfet_03v3 ad=0.56p pd=2.56u as=0.56p ps=2.56u w=2u l=1u
X206 a_36888_6447# vbn.t179 a_37178_7027# VSS.t85 nfet_03v3 ad=0.56p pd=2.56u as=0.56p ps=2.56u w=2u l=1u
X207 a_41854_8187# vbn.t321 a_41564_7607# VSS.t83 nfet_03v3 ad=0.56p pd=2.56u as=0.9p ps=4.9u w=2u l=1u
X208 a_37178_2387# vbn.t387 a_36888_1807# VSS.t93 nfet_03v3 ad=0.56p pd=2.56u as=0.56p ps=2.56u w=2u l=1u
X209 a_37178_7027# vbn.t607 a_36888_6447# VSS.t85 nfet_03v3 ad=0.56p pd=2.56u as=0.56p ps=2.56u w=2u l=1u
X210 a_37178_2387# vbn.t858 a_36888_2967# VSS.t80 nfet_03v3 ad=0.56p pd=2.56u as=0.56p ps=2.56u w=2u l=1u
X211 a_36888_7607# vbn.t650 a_37178_7027# VSS.t84 nfet_03v3 ad=0.56p pd=2.56u as=0.56p ps=2.56u w=2u l=1u
X212 a_41564_2967# vbn.t253 a_41854_2387# VSS.t92 nfet_03v3 ad=0.56p pd=2.56u as=0.56p ps=2.56u w=2u l=1u
X213 a_41564_5287# vbn.t285 a_41854_4707# VSS.t88 nfet_03v3 ad=0.56p pd=2.56u as=0.56p ps=2.56u w=2u l=1u
X214 a_41854_5867# vbn.t287 a_41564_5287# VSS.t87 nfet_03v3 ad=0.9p pd=4.9u as=0.56p ps=2.56u w=2u l=1u
X215 a_37178_1227# vbn.t333 w_36826_300# VSS.t95 nfet_03v3 ad=0.56p pd=2.56u as=0.56p ps=2.56u w=2u l=1u
X216 a_37178_3547# vbn.t108 a_36888_4127# VSS.t90 nfet_03v3 ad=0.56p pd=2.56u as=0.56p ps=2.56u w=2u l=1u
X217 a_37178_3547# vbn.t98 a_36888_2967# VSS.t91 nfet_03v3 ad=0.56p pd=2.56u as=0.56p ps=2.56u w=2u l=1u
X218 a_36888_7607# vbn.t664 a_37178_8187# VSS.t83 nfet_03v3 ad=0.56p pd=2.56u as=0.56p ps=2.56u w=2u l=1u
X219 a_36888_6447# vbn.t177 a_37178_7027# VSS.t85 nfet_03v3 ad=0.56p pd=2.56u as=0.56p ps=2.56u w=2u l=1u
X220 a_41564_1807# vbn.t241 a_41854_1227# VSS.t94 nfet_03v3 ad=0.56p pd=2.56u as=0.56p ps=2.56u w=2u l=1u
X221 a_37178_2387# vbn.t834 a_36888_1807# VSS.t93 nfet_03v3 ad=0.56p pd=2.56u as=0.56p ps=2.56u w=2u l=1u
X222 a_36888_5287# vbn.t903 a_37178_4707# VSS.t88 nfet_03v3 ad=0.9p pd=4.9u as=0.56p ps=2.56u w=2u l=1u
X223 a_41854_2387# vbn.t732 a_41564_1807# VSS.t93 nfet_03v3 ad=0.56p pd=2.56u as=0.56p ps=2.56u w=2u l=1u
X224 VSS.t43 vbnf.t23 vg.t0 VSS.t23 nfet_03v3 ad=0.336p pd=1.76u as=0.336p ps=1.76u w=1.2u l=5.335u
X225 a_37178_5867# vbn.t942 a_36888_6447# VSS.t80 nfet_03v3 ad=0.56p pd=2.56u as=0.56p ps=2.56u w=2u l=1u
X226 a_37178_7027# vbn.t655 a_36888_7607# VSS.t84 nfet_03v3 ad=0.56p pd=2.56u as=0.56p ps=2.56u w=2u l=1u
X227 a_41564_6447# vbn.t295 a_41854_5867# VSS.t86 nfet_03v3 ad=0.56p pd=2.56u as=0.56p ps=2.56u w=2u l=1u
X228 w_36826_300# vbn.t338 a_37178_1227# VSS.t95 nfet_03v3 ad=0.56p pd=2.56u as=0.56p ps=2.56u w=2u l=1u
X229 a_36888_2967# vbn.t103 a_37178_3547# VSS.t91 nfet_03v3 ad=0.56p pd=2.56u as=0.56p ps=2.56u w=2u l=1u
X230 a_37178_7027# vbn.t182 a_36888_6447# VSS.t85 nfet_03v3 ad=0.56p pd=2.56u as=0.56p ps=2.56u w=2u l=1u
X231 a_36888_1807# vbn.t390 a_37178_2387# VSS.t93 nfet_03v3 ad=0.56p pd=2.56u as=0.56p ps=2.56u w=2u l=1u
X232 a_37178_4707# vbn.t529 a_36888_5287# VSS.t88 nfet_03v3 ad=0.56p pd=2.56u as=0.56p ps=2.56u w=2u l=1u
X233 a_36888_4127# vbn.t494 a_37178_4707# VSS.t89 nfet_03v3 ad=0.56p pd=2.56u as=0.56p ps=2.56u w=2u l=1u
X234 a_37178_8187# vbn.t206 a_36888_7607# VSS.t83 nfet_03v3 ad=0.56p pd=2.56u as=0.56p ps=2.56u w=2u l=1u
X235 VSS.t154 VDD_LS.t31 VSS.t154 VSS.t153 nfet_03v3 ad=22.113p pd=99.18u as=0 ps=0 w=49.14u l=10u
X236 a_41854_2387# vbn.t256 a_41564_2967# VSS.t92 nfet_03v3 ad=0.56p pd=2.56u as=0.56p ps=2.56u w=2u l=1u
X237 a_41564_5287# vbn.t290 a_41854_5867# VSS.t87 nfet_03v3 ad=0.56p pd=2.56u as=0.56p ps=2.56u w=2u l=1u
X238 a_37178_4707# vbn.t120 a_36888_4127# VSS.t89 nfet_03v3 ad=0.56p pd=2.56u as=0.56p ps=2.56u w=2u l=1u
X239 a_36888_2967# vbn.t101 a_37178_3547# VSS.t91 nfet_03v3 ad=0.56p pd=2.56u as=0.56p ps=2.56u w=2u l=1u
X240 a_37178_7027# vbn.t966 a_36888_7607# VSS.t84 nfet_03v3 ad=0.56p pd=2.56u as=0.56p ps=2.56u w=2u l=1u
X241 a_36888_1807# vbn.t845 a_37178_2387# VSS.t79 nfet_03v3 ad=0.56p pd=2.56u as=0.56p ps=2.56u w=2u l=1u
X242 VDD_LS.t9 q1 a_n7286_7514# VDD_LS.t8 pfet_03v3 ad=0.336p pd=1.76u as=1.2p ps=4.4u w=1.2u l=0.28u
X243 a_37178_1227# vbn.t822 a_36888_1807# VSS.t94 nfet_03v3 ad=0.56p pd=2.56u as=0.56p ps=2.56u w=2u l=1u
X244 a_36888_5287# vbn.t534 a_37178_4707# VSS.t88 nfet_03v3 ad=0.56p pd=2.56u as=0.56p ps=2.56u w=2u l=1u
X245 a_36888_6447# vbn.t187 a_37178_7027# VSS.t85 nfet_03v3 ad=0.56p pd=2.56u as=0.56p ps=2.56u w=2u l=1u
X246 a_36888_7607# vbn.t638 a_37178_7027# VSS.t84 nfet_03v3 ad=0.56p pd=2.56u as=0.56p ps=2.56u w=2u l=1u
X247 a_n4642_7514# ls.t5 a_n4810_7514# VDD_LS.t19 pfet_03v3 ad=2p pd=6u as=0.56p ps=2.56u w=2u l=0.28u
X248 a_n4642_7514# a_n5549_6703# VSS.t8 VSS.t7 nfet_03v3 ad=1p pd=4u as=0.28p ps=1.56u w=1u l=0.28u
X249 VDD.t13 a_36866_9481# a_36866_9481# VDD.t12 pfet_03v3 ad=3.92p pd=14.56u as=3.92p ps=14.56u w=14u l=14u
X250 a_36866_9481# vbn.t690 a_37178_8187# VSS.t82 nfet_03v3 ad=0.56p pd=2.56u as=0.56p ps=2.56u w=2u l=1u
X251 a_36888_4127# vbn.t482 a_37178_3547# VSS.t90 nfet_03v3 ad=0.56p pd=2.56u as=0.56p ps=2.56u w=2u l=1u
X252 a_36888_2967# vbn.t458 a_37178_3547# VSS.t91 nfet_03v3 ad=0.56p pd=2.56u as=0.56p ps=2.56u w=2u l=1u
X253 a_41854_5867# vbn.t298 a_41564_6447# VSS.t86 nfet_03v3 ad=0.56p pd=2.56u as=0.56p ps=2.56u w=2u l=1u
X254 a_36888_4127# vbn.t125 a_37178_4707# VSS.t89 nfet_03v3 ad=0.56p pd=2.56u as=0.56p ps=2.56u w=2u l=1u
X255 a_36888_6447# vbn.t185 a_37178_7027# VSS.t85 nfet_03v3 ad=0.56p pd=2.56u as=0.56p ps=2.56u w=2u l=1u
X256 a_37178_7027# vbn.t194 a_36888_7607# VSS.t84 nfet_03v3 ad=0.56p pd=2.56u as=0.56p ps=2.56u w=2u l=1u
X257 a_41854_2387# vbn.t245 a_41564_1807# VSS.t93 nfet_03v3 ad=0.9p pd=4.9u as=0.56p ps=2.56u w=2u l=1u
X258 a_37178_8187# vbn.t218 a_36866_9481# VSS.t82 nfet_03v3 ad=0.56p pd=2.56u as=0.56p ps=2.56u w=2u l=1u
X259 a_36888_1807# vbn.t364 a_37178_1227# VSS.t94 nfet_03v3 ad=0.56p pd=2.56u as=0.56p ps=2.56u w=2u l=1u
X260 vbnf.t9 bit0.t0 a_6356_6633# VSS.t152 nfet_03v3 ad=0.9p pd=4.9u as=0.9p ps=4.9u w=2u l=0.28u
X261 a_37178_5867# vbn.t920 a_36888_5287# VSS.t87 nfet_03v3 ad=0.56p pd=2.56u as=0.56p ps=2.56u w=2u l=1u
X262 vg.t12 a_996_6587# a0.t1 VSS.t33 nfet_03v3 ad=0.9p pd=4.9u as=0.9p ps=4.9u w=2u l=0.28u
X263 a_36888_7607# vbn.t969 a_37178_7027# VSS.t81 nfet_03v3 ad=0.56p pd=2.56u as=0.56p ps=2.56u w=2u l=1u
X264 a_36888_2967# vbn.t867 a_37178_3547# VSS.t91 nfet_03v3 ad=0.56p pd=2.56u as=0.56p ps=2.56u w=2u l=1u
X265 a_36888_6447# vbn.t626 a_37178_7027# VSS.t85 nfet_03v3 ad=0.56p pd=2.56u as=0.56p ps=2.56u w=2u l=1u
X266 a_37178_3547# vbn.t487 a_36888_4127# VSS.t90 nfet_03v3 ad=0.56p pd=2.56u as=0.56p ps=2.56u w=2u l=1u
X267 VSS.t122 a_6206_14# vg.t27 VSS.t23 nfet_03v3 ad=0.336p pd=1.76u as=0.336p ps=1.76u w=1.2u l=5.335u
X268 a_36888_7607# vbn.t678 a_37178_8187# VSS.t83 nfet_03v3 ad=0.56p pd=2.56u as=0.56p ps=2.56u w=2u l=1u
X269 a_36866_9481# vbn.t223 a_37178_8187# VSS.t82 nfet_03v3 ad=0.56p pd=2.56u as=0.56p ps=2.56u w=2u l=1u
X270 w_36826_300# vbn.t326 a_37178_1227# VSS.t95 nfet_03v3 ad=0.56p pd=2.56u as=0.56p ps=2.56u w=2u l=1u
X271 a_37178_3547# vbn.t461 a_36888_2967# VSS.t91 nfet_03v3 ad=0.56p pd=2.56u as=0.9p ps=4.9u w=2u l=1u
X272 a_37178_1227# vbn.t369 a_36888_1807# VSS.t94 nfet_03v3 ad=0.56p pd=2.56u as=0.56p ps=2.56u w=2u l=1u
X273 VSS.t118 a_6206_14# vg.t35 VSS.t23 nfet_03v3 ad=0.336p pd=1.76u as=0.336p ps=1.76u w=1.2u l=5.335u
X274 a_41564_1807# vbn.t248 a_41854_2387# VSS.t93 nfet_03v3 ad=0.56p pd=2.56u as=0.56p ps=2.56u w=2u l=1u
X275 a_36888_5287# vbn.t560 a_37178_5867# VSS.t87 nfet_03v3 ad=0.56p pd=2.56u as=0.56p ps=2.56u w=2u l=1u
X276 a_37178_1227# vbn.t36 w_36826_300# VSS.t95 nfet_03v3 ad=0.56p pd=2.56u as=0.56p ps=2.56u w=2u l=1u
X277 a_37178_3547# vbn.t882 a_36888_4127# VSS.t90 nfet_03v3 ad=0.56p pd=2.56u as=0.56p ps=2.56u w=2u l=1u
X278 a_36888_6447# vbn.t951 a_37178_7027# VSS.t85 nfet_03v3 ad=0.56p pd=2.56u as=0.56p ps=2.56u w=2u l=1u
X279 a_37178_8187# vbn.t683 a_36888_7607# VSS.t83 nfet_03v3 ad=0.56p pd=2.56u as=0.56p ps=2.56u w=2u l=1u
X280 vbnf.t6 bitb3.t1 a_6206_896# VDD.t42 pfet_03v3 ad=2.25p pd=10.9u as=2.25p ps=10.9u w=5u l=0.28u
X281 a_36888_4127# vbn.t470 a_37178_3547# VSS.t90 nfet_03v3 ad=0.56p pd=2.56u as=0.56p ps=2.56u w=2u l=1u
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
