mattvenn/gf-433-oscillator/layout/pex/mdac_cm.spice

* mdac: magic R+C extraction of layout/mdac.gds (layout/gen/pex.sh)
* 1390 devices merged into 158 instances (layout/gen/pexmerge.py, from mdac_c.spice)
* extracted 2026-11-11T14:15:24+01:00 with magic 8.3.642, mode c, from mdac.gds
.subckt mdac VDD VSS vg vbnf ns30 ns28 ns26 ns24 ns22 ns20 ns18 ns16 ns14 ns12 ns10 ns8 ns6 ns4 ns2 nb4 nb2 nb0 nsd nb1 nb3 ns1 ns3 ns5 ns7 ns9 ns11 ns13 ns15 ns17 ns19 ns21 ns23 ns25 ns27 ns29 ns31
XM0 VDD a_1344_2092# a_546_17710# VDD pfet_03v3 w=1u l=4u m=16 ad=2.90625e-13 as=2.8e-13 pd=1.64375e-06 ps=1.56e-06
XM1 VDD a_1344_2092# VDD VDD pfet_03v3 w=1u l=4u m=160 ad=2.8e-13 as=2.60288e-12 pd=1.56e-06 ps=1.46932e-05
XM2 VDD a_1344_2092# a_1344_2092# VDD pfet_03v3 w=1u l=4u m=32 ad=2.90625e-13 as=2.8e-13 pd=1.64375e-06 ps=1.56e-06
XM3 a_546_17710# a_1344_2092# VDD VDD pfet_03v3 w=1u l=4u m=16 ad=2.8e-13 as=2.90625e-13 pd=1.56e-06 ps=1.64375e-06
XM4 VDD a_1344_2092# a_546_18626# VDD pfet_03v3 w=1u l=4u m=16 ad=2.90625e-13 as=2.8e-13 pd=1.64375e-06 ps=1.56e-06
XM5 VDD a_1344_2092# a_546_14962# VDD pfet_03v3 w=1u l=4u m=16 ad=2.90625e-13 as=2.8e-13 pd=1.64375e-06 ps=1.56e-06
XM6 a_546_18626# a_1344_2092# VDD VDD pfet_03v3 w=1u l=4u m=16 ad=2.8e-13 as=2.90625e-13 pd=1.56e-06 ps=1.64375e-06
XM7 VDD a_1344_2092# a_546_15878# VDD pfet_03v3 w=1u l=4u m=16 ad=2.90625e-13 as=2.8e-13 pd=1.64375e-06 ps=1.56e-06
XM8 a_546_12214# nb3 a_400_3054# VDD pfet_03v3 w=1u l=0.28u m=1 ad=2.8e-13 as=4.5e-13 pd=1.56e-06 ps=2.9e-06
XM9 VDD a_1344_2092# a_546_3454# VDD pfet_03v3 w=1u l=4u m=16 ad=2.90625e-13 as=2.8e-13 pd=1.64375e-06 ps=1.56e-06
XM10 a_1344_2092# a_1344_2092# VDD VDD pfet_03v3 w=1u l=4u m=32 ad=2.8e-13 as=2.90625e-13 pd=1.56e-06 ps=1.64375e-06
XM11 a_546_3454# a_1344_2092# VDD VDD pfet_03v3 w=1u l=4u m=16 ad=2.8e-13 as=2.90625e-13 pd=1.56e-06 ps=1.64375e-06
XM12 a_546_19542# a_1344_2092# VDD VDD pfet_03v3 w=1u l=4u m=16 ad=2.8e-13 as=2.90625e-13 pd=1.56e-06 ps=1.64375e-06
XM13 VDD a_1344_2092# a_546_12614# VDD pfet_03v3 w=1u l=4u m=16 ad=2.90625e-13 as=2.8e-13 pd=1.64375e-06 ps=1.56e-06
XM14 a_546_7634# a_1344_2092# VDD VDD pfet_03v3 w=1u l=4u m=16 ad=2.8e-13 as=2.90625e-13 pd=1.56e-06 ps=1.64375e-06
XM15 a_546_15362# a_1344_2092# VDD VDD pfet_03v3 w=1u l=4u m=16 ad=2.8e-13 as=2.90625e-13 pd=1.56e-06 ps=1.64375e-06
XM16 VDD a_1344_2092# a_546_7634# VDD pfet_03v3 w=1u l=4u m=16 ad=2.90625e-13 as=2.8e-13 pd=1.64375e-06 ps=1.56e-06
XM17 a_546_12214# a_1344_2092# VDD VDD pfet_03v3 w=1u l=4u m=4 ad=2.8e-13 as=3.225e-13 pd=1.56e-06 ps=1.895e-06
XM18 VDD a_1344_2092# a_546_3054# VDD pfet_03v3 w=1u l=4u m=16 ad=2.90625e-13 as=2.8e-13 pd=1.64375e-06 ps=1.56e-06
XM19 a_546_5802# ns18 a_400_3054# VDD pfet_03v3 w=1u l=0.28u m=1 ad=2.8e-13 as=4.5e-13 pd=1.56e-06 ps=2.9e-06
XM20 a_546_16278# a_1344_2092# VDD VDD pfet_03v3 w=1u l=4u m=16 ad=2.8e-13 as=2.90625e-13 pd=1.56e-06 ps=1.64375e-06
XM21 a_546_6718# ns14 a_400_3054# VDD pfet_03v3 w=1u l=0.28u m=1 ad=2.8e-13 as=4.5e-13 pd=1.56e-06 ps=2.9e-06
XM22 VDD a_1344_2092# a_546_3970# VDD pfet_03v3 w=1u l=4u m=16 ad=2.90625e-13 as=2.8e-13 pd=1.64375e-06 ps=1.56e-06
XM23 a_546_3970# a_1344_2092# VDD VDD pfet_03v3 w=1u l=4u m=16 ad=2.8e-13 as=2.90625e-13 pd=1.56e-06 ps=1.64375e-06
XM24 VDD a_1344_2092# a_546_8950# VDD pfet_03v3 w=1u l=4u m=16 ad=2.90625e-13 as=2.8e-13 pd=1.64375e-06 ps=1.56e-06
XM25 VDD a_1344_2092# a_546_4886# VDD pfet_03v3 w=1u l=4u m=16 ad=2.90625e-13 as=2.8e-13 pd=1.64375e-06 ps=1.56e-06
XM26 a_546_4886# a_1344_2092# VDD VDD pfet_03v3 w=1u l=4u m=16 ad=2.8e-13 as=2.90625e-13 pd=1.56e-06 ps=1.64375e-06
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
