mattvenn/gf-433-oscillator/xschem/gen/all.py

"""Regenerate every schematic and symbol, leaves first: python3 xschem/gen/all.py"""
import cfed_ring, cfed_dac, ring_core_v3, cgm_ref, vco_cfed, lsdiv, vco_top, tx_drv

for m in (cfed_ring, cfed_dac, ring_core_v3, cgm_ref, vco_cfed, lsdiv, vco_top, tx_drv):
    m.build()
