mattvenn/gf-433-oscillator/(commit log)

2026-11-07 Phase 1 VCO study: setup, candidate ring VCO sims, datasheet
    - tools: skill scripts retargeted to gf180mcuD (osic-mac, osic-inimage, longrun, rawread, xsch, ...)
    - mag/: GF180 TT analog flow from gf-r2r-dac
    - sim/vco: plain ring baseline, SE / pseudo-diff starved candidates, const-gm biased SE ring
    with n-well + n+ resistor tempco compensation
    - sim/pn/isf.py: ISF phase-noise method (not yet validated)
    - docs: platform facts, VCO study, 2-page options datasheet
2026-11-07 Phase-noise sweep handoff for the sim pod
    - sim/pn/isf.py: write a per-run .spiceinit (1 thread when parallel)
    - sim/pn/run_all.sh: 3 variants x 5 corners, PAR x JOBS ngspice processes
    - sim/pn/summary.py: result.json -> markdown table
    - docs/handoff_phase_noise.md: steps, checks, what to commit
2026-11-07 Phase-noise sweep results: 3 VCO variants x 5 corners (ISF, M=60)
    Ran sim/pn/run_all.sh (M=60 PAR=7 JOBS=4) on iic-osic-tools:2026.09 /
    ngspice-47: 15/15 cases, 39.0 min. Results in docs/pn_results.md and
    sim/pn/results/2026-11-07/.
    Fixes to sim/pn/isf.py:
    - noise decks: give the .noise input source an AC value (ngspice-47
    aborts with "ac input not found" otherwise); output noise unchanged.
    - ISF: measure the edge as a TRIG AT=tw / TARG interval instead of an
    absolute WHEN time. meas/echo keep ~6-7 digits, which quantized the
    edge shift to 1 ps against 1-15 ps signals; now ~1 fs.
    - head/foot split: sample the node slope before the injected pulse
    (td-3p, td) instead of across it (td-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
    [isf.csv]
2026-11-07 Bias RC filter study, phase-noise plots, VACASK transient-noise cross-check
    - vco_bias.py: optional rf/cf filter between the const-gm reference and vbn loads (off by default, netlist unchanged).
    - isf.py: cgmf variant; vbnf initial condition corrected for the start-up step; bias noise taken on vbnf.
    - plot_results.py: ISF, L(df) breakdown, frequency noise / rms FM, and corner figures.
    - sim/vacask: se ring in VACASK with transient noise; agrees with the ISF white-noise floor within 0.5 dB at 10 MHz.
    - pn_results.md: follow-up sections for both.
2026-11-07 Add the mixed-signal-asic skill as a project skill (.claude/skills)
    So that agents in any clone (laptop or sim pod) have the flow, rules and reference notes.
2026-11-07 Ring-core layout generator (magic), DRC/LVS/antenna clean, PEX vs schematic
    layout/gen/ring_core.py draws the VCO ring core from vco_bias.P: 5 identical
    stage cells in folded order 0,4,1,3,2, master leg, coarse switches, VSS-shielded
    ring channel, n-well and p+ guard rings. magic and KLayout DRC 0, antenna 0
    (proven with a deliberate violation), LVS match with no property errors against
    export_core.py (from vco_bias.netlist()), swapped-leg mutation fails LVS.
    Extracted wiring C is ~10 fF per ring node (+-1.2 %), not 2 fF: RC PEX runs
    37-43 % slower than the schematic. Report: docs/ring_layout.md.
    Claude-Session: https://claude.ai/code/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
2026-11-07 bench/lab_todo.md: silicon factor, carrier regulator, RP2350 reference clock checks
2026-11-07 Bias/tuning sims (cw = 2 fF): Job 1 reference sweep, 2 fF tuning map, scripts
    - sim/pn/bias_fm.py: rms FM (1-10k, 1-100k) and L from the const-gm reference (dense .noise of vbnf and of the
    master leg's own vbp noise), with the stored cgm device and vdd terms
    - sim/pn/ref_sweep.py: Job 1 per reference sizing: lnw for zero tempco, PVT spread, start-up, bias_fm
    - sim/pn/isf.py: --set/--tag overrides (no change without them), ic_ref variants start from a DC operating point
    instead of uic (large references did not settle), cgmq variant (quiet reference, code 5)
    - sim/vco/vco_bias.py: nsn parameter (MN1/MN2 as series-parallel arrays; default 1 = today's netlist),
    map / startup / ringstart mo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
    [map.csv]
2026-11-08 Bias/tuning results: Job 2 cgmq PVT phase noise, Job 3 map at cw = 10 fF, code-0 start-up check, results doc
    Also fix ringstart random initial states (one RNG per seed, not per node).
    Claude-Session: https://claude.ai/code/session_011q23dVoGk4WekSLJAtWboJ
    [map.csv]
2026-11-08 docs/handoff_autonomy.md: rules for unattended server runs (tracked background jobs, chained driver, status/Done lines, heartbeat, laptop watch)
2026-11-08 Compact ring-core layout v2, f-node capacitance budget, schematic drawings, overnight plots
    - layout/gen/ring_core_v2.py: inverters clustered (ring-node wiring about 3 fF, was 10 fF); DRC/LVS/antenna clean;
    RC f 317/413/612 MHz at codes 0/10/31. The low codes lose current control (f-node charge sharing).
    - vco_bias.py: cfn (C on each foot node), swing option, cfsweep mode; default netlist unchanged.
    - docs/ring_layout_v2.md: report plus the Cf budget (none passes at cw 1.1 fF; about 10 fF at cw 5 fF).
    - docs/schematic/: explanatory SVG/PNG of the stage, bias and loop.
    - sim/results/2026-11-08/plots.py: figures for the overnight results.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
2026-11-08 Stage topology comparison: starved / stack / current-fed (cfed) options in vco_bias.py
    cfed (shared NMOS current DAC into a common node vg with 3 pF, kc 0.75, k 6) is the only topology monotonic
    everywhere and covering 296-849 MHz worst case; 0.53 mW near 433.92 MHz, df/dVDD -0.008 %/10 mV, tempco +456 ppm/C.
    stack fails (foot drains load the output). Default netlist unchanged.
    Claude-Session: https://claude.ai/code/session_011q23dVLg5UESLgH4yu5q6d
2026-11-08 Current-fed ring noise/tempco/step study (cfed_noise.py, ka DAC-area knob, docs/cfed_results.md)
    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
2026-11-08 Handoff: current-fed ring DAC sizing, PVT map and PVT noise (first test of the unattended-run rules)
    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
2026-11-08 cfed sizing: driver (cfed_sizing_run.sh), joint lnw/code null search, PVT map and noise steps (cfed_sizing.py); ki/dacn take --corner/--temp
    Claude-Session: https://claude.ai/code/session_011q23dSTKMK2aMisxQJKwD9
2026-11-08 Ring core v3: current-fed layout (inverter cluster on vg strap, 3 pF MOS decap, common-centroid DAC)
    DRC/LVS/antenna clean at wfu 0.25/0.30/0.35; 69 x 52 um (3584 um2). Ring nodes 3.0-3.4 fF; effective cw 3.4 fF (C),
    6.2 fF (RC). RC f at codes 0/6/15/31: 205/341/507/742 MHz (wfu 0.25), 238/392/578/837 (wfu 0.30), monotonic.
    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
2026-11-08 Corner policy: room temperature only (27 C, 20/35 C for drift)
    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
2026-11-08 cfed sizing results: w = 1.2 (wfu = wff = 0.30 um), lnw = 5.023 um; range 228-750 MHz over full PVT, worst FM 8.26 kHz (1-10 kHz)
    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
    [map.csv]
2026-11-08 Handoff: current-fed ring power-on start-up (sim pod)
    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
2026-11-08 v3 RC check at the chosen sizing + DAC mismatch Monte Carlo (both pass)
    RC/sch 0.86-0.88; worst fmax 676.5 MHz (ss), fmin 194 MHz (ff); 433.92 reachable at codes 12/14-15/10 (tt/ss/ff) in RC.
    MC (mismatch per unit instance, proven per-instance; N=500 tt, 200 ss/ff): 0 % non-monotonic, worst DNL +13 %,
    worst fine/step 3.1 at 15->16; transients confirm f tracks the current.
    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
2026-11-08 cfed power-on start-up: driver (cfed_startup_run.sh) and runs/analysis (cfed_startup.py)
    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
2026-11-08 cfed start-up status: Running: step 1/3 (calibration) since 13:12, ETA 13:52
2026-11-08 cfed start-up status: Running: step 2/3 (36 power-on runs) since 13:51, ETA 14:37
2026-11-08 cfed power-on start-up: 36 runs, all start in the fundamental mode (worst 138 us); map.csv f reads ~1.3 % high
    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
2026-11-08 xschem schematics for the current-fed VCO (cfed_ring, cfed_dac, ring_core_v3, cgm_ref, vco_cfed)
    Generated from vco_bias.netlist() at the chosen design (xschem/gen/). GF180 symbols copied into xschem/symbols/ so
    xschem-viewer can render them. Checks (xschem/gen/check.py): ring_core_v3 matches the layout LVS source, vco_cfed
    matches vco_bias (netgen + device sizes), mutation caught, sim within 0.04 %. Viewer links in docs/schematics.md.
    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
    [cfed_dac.sch, cfed_ring.sch, cgm_ref.sch, ring_core_v3.sch, vco_cfed.sch]
2026-11-08 Tuning plots: coarse code + fine vctrl -> f (tt 27 C), and the RP2350 tuning recipe (search, servo, FSK)
    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
2026-11-08 STATUS.md: pick-up-from-here note (current-fed VCO results, next steps, how things run)
    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
2026-11-08 xschem: redraw all five sheets as wired, textbook-style schematics (no net labels)
    Wires/labels: cfed_ring 85/0, cfed_dac 163/0, ring_core_v3 30/0, cgm_ref 137/0, vco_cfed 27/0. Local vdd/gnd/cap
    symbols (no .GLOBAL). check.py still OK (layout LVS source, vco_bias netlist + sizes, mutation caught, sim -0.036 %).
    Light-theme previews in docs/img/xschem/.
    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
    [cfed_dac.sch, cfed_ring.sch, cgm_ref.sch, ring_core_v3.sch, vco_cfed.sch]
2026-11-08 Level shifter (AC-coupled, duty-corrected) + TSPC div4 on the extracted v3 core: all 25 points pass; STATUS update
    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
    [lsdiv.py]
2026-11-08 v3 core LVS against the xschem netlist (check_v3.sh); committed GDS -> wfu 0.30
    layout/gen/check_v3.sh netlists xschem/ring_core_v3.sch and uses it as the LVS source (DRC, antenna, LVS via
    check_v2.sh, which gains an optional SRC_CELL). layout/ref/ring_core_v3.spice is kept only as a cross-check.
    Two broken schematic copies (FC_3 m 8->7, XTN0 gate) must fail.
    It caught that the committed GDS was the wfu 0.25 layout (DAC W 1.0 vs 1.2 um). Replaced with the 0.30 layout
    (the chosen design, and the one the w30chk extractions came from); ref netlist and floorplan PNG regenerated.
    check_v3: DRC 0/0, antenna 0, LVS match with no property errors, both mutations caught.
    xschem/gen/check.py now compa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
    [check.py]
2026-11-08 lsdiv schematics: level shifter + TSPC /4 + buffer, from lsdiv.py block(); drawn passives
    sim/lsdiv/lsdiv.py: block() is the drawn circuit as a .subckt (VDD VSS a0 ck), with R1 as ppolyf_u_3k
    (1 x 159 um) and C1 as a 16 x 16 um nfet gate cap (real=1). tt 27 C code 9 with them: f 373.04 MHz (373.05),
    LS duty 49.5 %, /4 exact, LS 0.236 mW (0.210).
    xschem/gen/lsdiv.py: four wired sheets (ls_ac, tspc_t1, tspc_t2, lsdiv). check.py: lsdiv vs block() matches
    uniquely, device sizes identical (34); R1 +10 % mutation caught by the size diff. CHECK OK.
    docs: lsdiv_design.md (the duplicated section replaced by the /4-alone sweep: exact to 3.5-4 GHz, sf fails
    below 150 MHz), schematics.md links; platform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
    [ls_ac.sch, lsdiv.sch, tspc_t1.sch, tspc_t2.sch]
2026-11-08 Handoff: re-map the 433.92 codes on the extracted core with the lsdiv load (sim pod)
    sim/lsdiv/remap.py (codes / fine / summary) on the lsdiv deck: extracted core, full reference + filter, the drawn
    level shifter + /4 on a0. run_remap.sh chains it with status / DONE / FAILED and per-step checks.
    5 corners at 27 C, 3.3 V: codes 0-31 at vctrl 1.65, then 4 codes around 433.92 x vctrl 0/1.0/2.3/3.3.
    Claude-Session: https://claude.ai/code/session_011q23dU6Ppt7EpE28VqwcCV
2026-11-08 lsdiv layout: level shifter + TSPC /4 + buffer, 40.5 x 37 um, DRC/LVS/antenna clean; extracted sim
    layout/gen/lsdiv.py -> layout/lsdiv.gds (top lsdiv), placed left of ring_core with a0 abutting on M2; Cc as
    interdigitated M2/M3 fingers at the a0 edge. No Metal4/5.
    check_lsdiv.sh (LVS source = xschem lsdiv netlist, Cc removed, ppolyf_u_3k -> _1k as magic extracts it):
    DRC 0/0, antenna 0, LVS unique match, R1 size, 3 mutations caught: CHECK OK.
    Extracted (C): Cc 1.99 fF, a0 extra 0.63 fF, lg 2.22 fF. On the extracted core (27 C, 3.3 V): /4 exact at
    tt/ss/ff codes 0/9/31, LS duty 45.9-51.2 %, df -1.54..-1.80 % (schematic -1.0..-1.24 %).
    Open: block power ~1.7x schematic (0.63 mW at tt code 9, r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
2026-11-08 433.92 code re-map on the extracted core with the level shifter: tt 12, ss 14, ff 10, sf 12, fs 13
    240 points (5 corners, 27 C, 3.3 V; codes 0-31 at vctrl 1.65 + 4 codes x 4 vctrl), no warnings, /4 exact.
    Codes 3-4 above the schematic map; >= 2 codes reach 433.92 at every corner; Kvco 21-39 MHz/V at the
    recommended points. docs/remap_results.md; STATUS updated (lsdiv done + open items, TT question on hi-res poly).
    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
    [remap.csv]
2026-11-08 platform: hi-res poly is 1 kOhm/sq, MIM 2.0 fF/um2 M4-M5 (TT, wafer.space Discord); STATUS: switch RF to ppolyf_u_1k
    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
2026-11-08 Hi-res poly 1 kOhm/sq: RF and R1 now ppolyf_u_1k
    The run's hi-res poly is the 1k option (TT, docs/platform.md). vco_bias.py: rfm parameter (default 1k; 3k
    reproduces older results), rf_length() per model: 1 MOhm = 1 x 970.2 um (was 318.3 um at 3k).
    lsdiv: R1 stays as drawn (1 x 159.125 um), now ppolyf_u_1k (~164 kOhm); --r1 default 1k.
    Checks: xschem/gen/check.py CHECK OK (sim tt code 9: 503.98 vs 504.16 MHz, vbn 1.232 V, unchanged; resistor
    dims rounded in the size diff); check_lsdiv.sh CHECK OK (no rename needed).
    Noise tt 27 C code 9: 7.866 kHz rms 1-10 kHz with 1k, 7.868 with 3k (sizing run: 7.87).
    Extracted lsdiv at tt/ss/ff codes 0/31 with 1k R1: f within 0.01 MHz, duty and /4 identica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
    [cgm_ref.sch, ls_ac.sch]
2026-11-08 RC extraction double-counted coupling C: rcfix.py; the extracted core is ~0.98x, not 0.87x
    magic rc mode (ext2sim/extresist/ext2spice extresist on) puts each port's / split net's total C (coupling
    included) to VSS and still writes the coupling caps. Core ring nodes 3.2 -> 5.9 fF, vg 54 -> 75, vbn 56 -> 100.
    layout/gen/rcfix.py scales those VSS caps by (S-K)/S; all corrected nets match the C-only totals (< 0.5 %).
    pex_v3.sh / pex_lsdiv.sh rc now write *_rcx.spice; sims use ring_core_v3_w30chk_rcx.spice.
    Extracted core alone, corrected vs as extracted: +12.4..+13.3 % f at tt/ss/ff codes 0/9/31
    (tt code 9: 377.2 -> 425.7 MHz). docs/rc_extraction_fix.md; 0.87x corrected in CLAUDE.md, STATUS, tun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
    [lsdiv.py]
2026-11-08 Filter cap CF drawn as an nfet gate cap (10 x 49.14/10 um); lsdiv a0 alignment note
    vco_bias.py: cfm='mos' (default; 'ideal' reproduces older results), cf_size(): 20 pF as 10 fingers L 10 um.
    cgm_ref sheet draws it (gate vbnf, S/D/B VSS). check.py CHECK OK; tt code 9: 504.23 MHz (504.16 ideal),
    vbn 1.232 V; rms FM tt 27 C code 9: 7.90 kHz 1-10 kHz (7.87 ideal).
    lsdiv: the core's a0 tap is at y = 36.17 um, not 4.715: place lsdiv +31.455 um (or mirrored) at the top level.
    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
    [cgm_ref.sch]
2026-11-08 433.92 re-map on the corrected core + extracted level shifter: tt 9, ss 11, ff 7, sf 9, fs 10
    240 points, no warnings, /4 exact, duty 45-55 %. The schematic map's codes (fs +1): the layout and the LS load
    are absorbed by the fine range (433.92 at vctrl 1.75-2.25 V). 3 codes reach 433.92 at every corner.
    Range at vctrl 1.65 V: 193-851 MHz. Replaces the first re-map (RC double count, codes 3-4 too high).
    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
    [remap.csv]
2026-11-08 xschem cfed_dac: draw the bit switches as textbook transmission gates
    Each switch cell's TN and TP now lie on their sides, NMOS over PMOS, vbnf in
    on the left and g_b out on the right, gates outside (bit above, bitb with its
    bubble below), bulk ties inside. TD still pulls g_b to VSS. The header line now
    says bit[b] instead of the ambiguous bit_b.
    Netlist unchanged: the old and new sheets netlisted with xschem 3.4.4 give
    identical device lines (mutation-checked), so ring_core_v3 / vco_cfed and the
    layout LVS source are unaffected. Preview re-rendered with xschem 3.4.4.
    Claude-Session: https://claude.ai/code/session_011q23dU84XLnY1dFC8e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
    [cfed_dac.sch]
2026-11-08 Bias reference layout (cgm_ref): 238.8 x 69.4 um, DRC/LVS/antenna clean; extracted VCO matches schematic
    layout/gen/cgm_ref.py -> layout/cgm_ref.gds: MN1/MN2 per series stage in one row, B14 A7 B28 A7 B14
    (common centroid), MP1/MP2 P1P1P2P2P2P2P1P1, RBW/RBN, start-up; CF 20 pF nfet cap + RF 970 um serpentine;
    vbnf on the left edge at y 42.665 (core vbn pin), vctrl M2 feed-through at y 12.935. No Metal4/5.
    check_ref.sh: DRC 0/0, antenna 0, LVS unique, RBW/RBN/RF sizes within 0.04 %, 3 mutations caught.
    PDK trap: magic's gf180mcuD tech drops RES_MK on the n-well resistor; the generator adds it and the checks
    repaint rnw from NWELL & RES_MK.
    Extracted core + extracted reference, code 9, 27 C: f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
2026-11-08 xschem cfed_dac: stand the transmission gates upright, gates in from the sides
    TP and TN now sit side by side: vbnf into a bar at the top, g_b out of a bar
    at the bottom, bitb (with the bubble) into TP from the left and bit into TN
    from the right, bulk ties pointing inward. With TP on the left, bitb carries
    straight on down to TD and nothing crosses g_b. Leg pitch 320 -> 380 to fit.
    Netlist unchanged: identical device lines to main's cfed_dac.sch.
    Claude-Session: https://claude.ai/code/session_011q23dU84XLnY1dFC8eNPns
    [cfed_dac.sch]
2026-11-08 STATUS: reference layout done; room-temperature tempco +100..+140 ppm/C (peak near 35 C): re-tune lnw
    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
2026-11-08 vco_top: core + level shifter + reference + 10 pF LS decap, DRC/LVS/antenna clean; extracted top = blocks
    layout/gen/vco_top.py -> layout/vco_top.gds (406.7 x 70.8 um, instanced): lsdiv raised 31.455 um so a0 abuts
    the core's tap; reference abutted on the right (vbnf -> vbn, vctrl feed-through); VDD_LS a separate branch
    with a 5-finger 10 pF nfet decap. xschem vco_top sheet. check_top.sh: DRC 0/0, antenna 0, LVS unique (18 pins),
    4 resistor sizes, 3 mutations caught, no Metal4/5. Extracted (C and rcx), code 9, 27 C: tt 418.0 / ss 382.7 /
    ff 461.8 MHz, within 0.07 % of core + LS block results; /4 exact; P(VDD) 0.45 mW, P(VDD_LS) 0.58-0.90 mW.
    Tile: a straight row needs 2x2 (1x2 width 346.6 um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
    [vco_top.sch]
2026-11-08 TT wrapper: gds/ + lef/ for tt_um_mattvenn_gf433_vco (2x2 analog), precheck 12/12 locally, LVS clean
    layout/gen/tt_wrapper.py builds the 2x2 analog tile from TT's template: vco_top (mirrored, near ua[0]/ua[1]),
    Metal4 VDPWR/VGND stripes (+ a VDD_LS stripe), 5 inv_1 for bitb, 5 antenna diodes on the bit lines, 23 tiel on
    unused outputs. ui_in[4:0] -> code, uo_out[0] = ck, ua[0] = vctrl, ua[1] = vbn.
    TT precheck (tt-support-tools main, CI PDK e8daeda): all 12 checks pass locally.
    layout/gen/check_tt.sh: LVS of the wrapper vs lvs/tt_um_mattvenn_gf433_vco.spice (generated by
    lvs/make_source.py from the xschem netlist): unique match, 53/53 pins, resistor sizes, 3 mutations caught.
    .github/workflo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
2026-11-09 Bench 2026-11-09: ttgf0p2 ring #614 measured, VDD_CORE, RP2350 ref clock; silicon-factor handoff
    - bench/2026-11-09: scripts, raw CSVs, scope captures and the 1-page vgaringosc report (2 chips)
    - lab_todo/STATUS: results (no carrier regulator, VDD_CORE noise ~0.34 mV rms/20 MHz, integer-PLL ref clock,
    COB pin faults)
    - sim/silicon_factor + docs/handoff_gf_silicon_factor.md: extract the measured design and simulate the same
    ring configs at 5 corners for the GF silicon/sim factor
    [chip2.csv, final_checks.csv, refclk_div8.csv, sweep_div8.csv, sweep_uio4.csv, uio4_stats.csv, vdd_core.csv]
2026-11-09 GF180 analog pin model: pad_model_gf180 (SPICE + xschem), tt_asw_5v0 switch, check
    - sim/pad/: tnt's tt_asw_5v0 + lv2hv netlisted (Rdson matches tnt: 36.9 ohm peak at 2.03 V, 11.3 at 0 V),
    pad model with the PDK asig_5p0 ESD diodes, 1.29 pF extracted pad C, 15-60 ohm routing, n_off other
    switches (0-3 on ttgf0p3, from the TT index API; default 3), testbenches, plot
    - xschem/: pad_model_gf180, tt_asw_5v0, lv2hv generated by xschem/gen/pad_model.py; GF 5 V FET and
    ESD diode symbols copied for the viewer
    - sim/pad/check_xsch.py: xschem netlist vs SPICE model by simulation (11 measures agree), mutation caught;
    it found a swapped pmos D/S in the hand SPICE (fixed)
    - tools/xsch.py: optiona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
    [lv2hv.sch, pad_model_gf180.sch, tt_asw_5v0.sch]
2026-11-09 pad model: Fig. 2, xschem switch Rdson against tnt's plot, and pin-to-mod resistance through the pad
2026-11-09 pad model: analog pin sharing on the open shuttles (ttgf26c, ttgf26d, ttsky26d)
2026-11-09 tx_drv step 1: dipole driver circuit (sim/tx/tx_drv.py) and xschem sheets
    tx_split (tap on ls + phase splitter + keeper), tx_arm (NAND2 + x4 taper,
    3.3 V devices), tx_drv (two arms + supply decap). Checked by
    xschem/gen/check.py against block(): netgen + device sizes pass, the M5n
    width and TGn gate mutations fail as they should. Sizes are first guesses
    until the step 2 sweep.
    Claude-Session: https://claude.ai/code/session_011q23dRN3KpxfrKVCZpyMAf
    [tx_arm.sch, tx_drv.sch, tx_split.sch]
2026-11-09 tx_drv step 2: block bench and sizing (schematic, 27 C, 3.3 V)
    sim/tx/tb_tx_drv.py: ls (ideal 433.92 MHz) -> tx_drv -> pad_model_gf180 per
    arm -> 73 ohm + 100 pF dipole; P total and fundamental, duty, phase error,
    I(VDD), ripple, EM currents; dipole C started at its steady state (.ic).
    Final stage N 40 / P 100 um (knee), B1 1.5 um (phase error 0.05 deg tt),
    decap ~9.8 pF, devices > 10 um split into m fingers. All 5 corners:
    P fund +3.7..+9.3 dBm over rroute 15-60 / n_off 0-3, duty 48.8-52.1 %,
    phase error <= 0.5 deg, off state 0 V. Stage 5 up to 10.3 mA rms / arm.
    check.py: the device diff now joins SPICE continuation lines.
    Claude-Ses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
    [tx_arm.sch, tx_drv.sch, tx_split.sch]
2026-11-09 GF silicon factor: ttgf0p2 ring #614 vs extracted sim, about 1.0 at typical
    inv_2 taps 0.993-1.001 vs typical (silicon between sf and tt), inv1x5 0.935
    (least certain bench point), inv4x5 not measured. RC check -0.03/-0.04 %.
    magic 8.3.642 C extraction of the whole tile; 8.3.684 gives 27 % less C.
    Claude-Session: https://claude.ai/code/session_011q23dUxCUZJtEG7kbe42r1
    [results.csv]
2026-11-09 tx_drv step 4: layout, checks and extraction
    layout/gen/tx_drv.py -> layout/tx_drv.gds, 73.0 x 105.9 um: one logic band
    (M5n | arm n | splitter | arm p | M5p, lsdiv's strip() + channel router,
    M5 as a textbook 5-finger inverter with 1 um straps and a 2 um M2+M3 out
    bar sized for the measured stage-5 current) over the ~9.8 pF decap.
    Equal N/P finger counts per inverter (P <= 20 um), same totals.
    check_tx.sh: magic DRC 0, KLayout DRC 0 (768 rules), antenna 0, LVS vs the
    xschem netlist unique, 3 mutations caught. pex_tx.sh: c / rc / rcx.
    Extracted rcx vs schematic: P fund -0.19..-0.30 dB, duty 47.7-53.4 %,
    phase error <= 0.8 deg, off state 0 V (sim/tx/results/block_pex.txt).
    sim/tx/tb_tx_top.py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
    [tx_arm.sch]
2026-11-09 tx_drv step 3: driver on the extracted vco_top (code 9); platform: tnt's supply facts
    14 runs (sim/tx/results/top.md). The tap on ls leaves f and LS duty as
    without the driver; on its own supply branch the driver does not disturb
    the ring (rcx tt: -0.01 %, jitter 0.11 ps rms). Sharing 1 ohm + 1 nH with
    the ring pulls f -0.04..-0.29 % (ff worst, 1.3 ps rms jitter): keep the
    separate VDPWR stripe. P fund +4.8..+7.4 dBm, phase error <= 0.5 deg; LS
    duty passes through (out_p 54.0 % at ff). VDD +-4.5 %: +5.6 / +7.0 dBm.
    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
2026-11-09 tx_drv step 5a: ls port on lsdiv and vco_top (the TX driver tap)
    lsdiv: its ls M3 (R1's terminal) runs on to the top edge as a port; GDS XOR
    vs before: only that M3 and its label. vco_top: an M3 riser from it to the
    macro's top edge, pin ls. xschem lsdiv / vco_top and sim/lsdiv block() get
    the port. check_lsdiv.sh and check_top.sh: DRC 0 (magic, KLayout 768 rules),
    antenna 0, LVS unique, mutations caught. vco_top re-extracted (c, rc, rcx);
    top_pex.py / tb_tx_top.py use the ls port; lsdiv.py ls_x() accepts both
    extraction headers. layout/gen/tx_drv.py loads lsdiv by path (name clash).
    The wrapper (gds/, lvs/) is unchanged until the driver is placed in it.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
    [lsdiv.sch, vco_top.sch]
2026-11-09 tx_drv step 5b: the TX driver in the 2x2 tile
    tx_drv mirrored in y above lsdiv (tile x 597-670, y 120-226), ls straight
    up from vco_top's new ls pin. out_n -> ua[2], out_p -> ua[3]: 8 um M2/M3
    routes up beside the block, over it and down, ~750 um each, clear of the
    ring and reference. en_p <- ui_in[5], en_n <- ui_in[6] with an antenna
    cell each. Its own VDPWR (x 663.65) and VGND (x 659.65) stripes.
    info.yaml: analog_pins 4, ui[5..6], ua[2..3] described.
    LVS (check_tt.sh, magic 8.3.642): match, 1253 devices + 14 diodes, 53 pins;
    5 mutations caught (new: TX outputs swapped, TX enables swapped).
    KLayout DRC (PDK deck, feol + beol): only the density / fill rules the
    precheck excludes (DCF.1a x 8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
2026-11-09 tx_drv step 6: docs/tx_driver.md, STATUS, pad_model VAPWR range
    docs/tx_driver.md: specs, circuit, sizing knee (Fig. 4), on the real source,
    layout and checks, extracted vs schematic (Fig. 6), tile integration, limits.
    STATUS: the TX driver item and its open questions for tnt; 4 ua pins used.
    pad_model.md: VAPWR 3.3-5 V (tnt), 3.3 V is the conservative case.
    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
2026-11-09 tx_drv: the CI precheck passes on the tile with the driver (6503f1c)
    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
2026-11-09 tx_drv: the tile behind TT's power switch; harmonics at the dipole
    tb_tx_top.py case pg / pgoff: all tile supplies behind tt_pg_3v3_hp_2 (pfet
    W 3357.5 um, Ron 1.32 ohm tt, 1.18-1.48 over corners). Keying the driver on
    moves the ring +0.03..+0.05 % (+110..+210 kHz), ripple 12-15 mV, no jitter
    change; the -0.29 % shared case came from the assumed 1 nH. Docs: the switch,
    3rd harmonic -14.1 dBc at the dipole (tt), platform row for the switch.
    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
2026-11-10 tx_fine phase A: sigma-delta model, medium DAC sizing (MC, noise), macro RTL + cocotb, DAC layout (DRC/LVS clean)
    - sim/tune/sd_model.py: first-order SD, 8 fractional bits: worst spur -54 dBc at 25 MHz (-46 at 10 MHz), FM 0.28 kHz rms
    - sim/tune/mdac.py: 10-bit PMOS current-steering DAC (5 unary + 5 binary + SD cell), Iu/64 cells, 3/30 output mirror
    on vg; range 1.58-1.59 x the coarse step, LSB 29-39 kHz at 5 corners; MC N=200 monotonic at tt/ss/ff; FM +5 %
    - src/tx_fine.v + test/: SPI register, FSK offset, SD, thermometer decode, ripple divider, ck gate; 5 cocotb tests
    - layout/gen/mdac.py: 156.8 x 104.2 um, magic + KLayout DRC 0, antenna 0, LVS match, mutations caught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
    [pin_order.cfg]
2026-11-10 tx_fine phase B: macro hardened (LibreLane gf180mcuD, 170 x 260 um, M1-M4), GL tests; vctrl pull-down; vco_top vg/vbnf risers
    - src/tx_fine.v: effective word pipelined, active-low DAC lines (one-line steering), ripple divider
    - macro/tx_fine: DRC/LVS/antenna clean; tt 3.3 V: +1.59 ns at 50 MHz; ss 125 C 3.0 V closes at ~41 MHz
    - test/: 5 cocotb tests pass on RTL and on the hardened netlist (make GL=1); 3 RTL mutations caught
    - layout/gen/vctrl_pd.py: 200 kOhm ppolyf_u_1k, DRC/LVS clean
    - vco_top: vg and vbnf M3 risers to the top edge, vbnf port in xschem; check_top.sh CHECK OK
    - sim/tune/mdac.py: one control line per group (SD gate on mo), MB 1 unit / MPB 64, MDD 2 x 3.4/1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
    [vco_top.sch]
2026-11-10 tx_fine phase D: macro + medium DAC + vctrl pull-down in the TT tile, tile LVS clean
    - tt_wrapper: tx_fine macro (left strip; its strap pairs extended into the tile stripes), mdac above vco_top,
    vctrl_pd left of it; 37 control lines through an M3 jog channel (ordered so M2 segments never overlap), ck from
    vco_top into the macro, top pins (clk, rst_n, ui[7], uio[0..3], uo[0..3]) from the macro, uio_oe[3] tieh
    - lvs/make_source.py: macro from its powered netlist (lvs/verilog2spice.py), mdac and vctrl_pd from their
    generators; check_tt.sh: LVS PASS, 7/7 mutations caught (new: SPI swap, DAC line swap, ck_o/div16 swap)
    - rename sim/tune/mdac.py -> sim/tune/mdac_sim.py (clashed with layout/g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
    [mdac.py]
2026-11-10 tile: DRC/antenna clean (M3 antenna hops on the DAC lines, top-pin tracks moved), no duplicate std cells; info.yaml pinout
    - magic DRC 0, antenna 0, KLayout DRC only DCF.1a (dummy fill); check_tt.sh CHECK OK
    - the macro's own standard cells are reused (the precheck failed on 562d468, likely on the renamed '$1' copies)
    - info.yaml: ui[7] FSK, uio[0..3] SPI, uo[0..3] ck / dividers, clock 25 MHz, register map
    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
2026-11-10 docs/schematics: table of every schematic with 3D GDS viewer links; add vco_top
    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
2026-11-10 tx_fine: divider ratios f/16, f/64, f/1024 (were ck-relative); SD row fix in the DAC layout; mdac schematic
    - src/tx_fine.v: div16/64/1024 = ck/4, /16, /256 (the handoff's 27.1 MHz / 6.78 MHz / 424 kHz); macro re-hardened (r10)
    - layout/gen/mdac.py: the SD row was drawn as a 32-unit segment ('sd'.startswith('s')); now 1 unit + dummies,
    with an assertion that every group's unit count equals sim/tune/mdac_sim.py; stale .mag no longer reloaded
    (also in vctrl_pd.py). Found by the new schematic-vs-simulation netlist check.
    - xschem/gen/mdac.py: textbook sheet, matches the layout source and the simulated circuit uniquely (netgen)
    - xschem/gen/netlist.sh: uncomment the .subckt continuation line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
    [mdac.sch]
2026-11-10 check.py: mdac vs the layout source and the simulated circuit (+ SD-cell mutation); schematics.md: mdac, vctrl_pd, tx_fine
    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
2026-11-10 tx_fine_tune: done. Write-up of phases B-E (macro, register map, tile, transistor checks, RP2350 model), STATUS
    - extracted ring + DAC: LSB 27.4 / 31.1 / 35.7 kHz (ss / tt / ff); SD spurs -58.7 dBc; FSK 201 kHz, 0.26 us
    - open: macro supply coupling -37 dBc at 25 MHz (target -40), clock gating proposed; DAC block not extracted
    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
2026-11-11 tx_fine: clock-gate the static flops; supply spur -45.5 dBc (was -32.1 measured, target -40)
    - src/tx_fine.v: four icgtp gates (SPI + registers, eff_q, decoded DAC lines, SD); only the 10 input
    synchronisers stay on clk. eff_q's gate is enabled by its causes (FSK edge, SPI active), keeping the FSK
    adder out of the gate's enable path. Outputs cycle-for-cycle unchanged.
    - test: new clock_gating test (idle gates, SD zero-fraction / re-enable, one eff/dec edge per FSK edge);
    6/6 RTL and GL; 3 mutations of the enables caught.
    - macro r12: CTS root clkbuf_4, buffers clkbuf_2/4 (clkbuf_16 trees cost 450 uW on 14 sinks); setup slack
    tt +1.63 ns, ss 125 C -5.31 ns (r10 -5.83); DRC / LVS / ant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
2026-11-11 tx_fine: extracted DAC in the benches, VDD headroom, docs for clock gating; ua pin current vs 10 mA
    - layout/gen/pexmerge.py: merge parallel fingers of a C-only extraction (exact): mdac 1390 devices -> 158
    instances (mdac_cm.spice); the RC netlist stops on timestep too small (VDD split into ~1000 nodes)
    - mdac_sim.py: pex netlist with pb / mo / md brought out as ports; extracted DAC: LSB -0.2 % vs schematic,
    DC transfer within 0.03 %, DNL -0.013..+0.012; phase C with it: spurs -58.2 / -65.8 dBc, SD excess 8.4 / 14.0 kHz
    (schematic -57.9 / -64.3, 8.2 / 13.7); a 0.4 us start-up settling in the extracted runs explained
    - headroom: LSB and range unchanged from 3.3 V down to 2.8 V (tt, ss),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
2026-11-11 docs: the ttgf26c pin plan is only known at tapeout; n_off 0-3 stays the design range
    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
2026-11-11 xschem mdac: mo / md labels next to their diodes; title clear of the VDD symbol
    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
    [mdac.sch]
2026-11-11 xschem mdac: show device sizes (m x W / L) as text; the symbol's own label isn't drawn by the viewer
    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
    [mdac.sch]
2026-11-12 tx_fine: keep the SD-cell charge injection and the FSK carry spike as they are (decision recorded)
    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
2026-11-12 tx_drv: keep the final stage at 40 um; the ff pin-current excess is accepted (decision recorded)
    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
2026-11-12 spur: the 25 MHz supply spur comes through the ring's VDD; vg decap to VDD gives -80.5 dBc (was -45.2)
    sim/tune/spur_paths.py: the c4 bench (r12 clock charge on the 1.32 ohm tile supply) with the ripple on one
    block's VDD at a time, plus the vg decap returned to VDD. STATUS: the to-look-at-later item and the result.
    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
2026-11-12 vg decap to VDD on the extracted vco_top: 25 MHz spur -88...-90 dBc (today -44...-48); TX driver jitter halved
    vg_decap.py pex: the six decap fingers swapped to PMOS in vco_top_rcx / vco_top_c. The driver-on frequency shift is
    unchanged (a DC drop through the power switch), as expected.
    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
2026-11-12 vg decap to VDD, phase 1: the simulation model (vco_bias cvg_to, default vdd)
    vco_bias.netlist() writes Cvg vg vdd; cvg_to=vss gives the old circuit. vg_decap.py
    and spur_paths.py put the VSS decap back for their 'today' cases; the mdac noise deck
    comments out Cvg whatever its return. c4q re-run (r12, tt): 25 MHz line -79.4 dBc
    (decap to VSS -45.2); r10 without clock gating -67.9 (was -31.8). Fig. 3c regenerated
    with the four traces.
    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
2026-11-12 vg decap to VDD, phase 2: ring_core_v3 schematic and layout (PMOS gate cap)
    The decap is now 6 x pfet_03v3 30.71/4 um (gate vg, S/D/B VDD) in its own n-well, with
    an n+ tap strip and a VDD strap (M1+M2) just above the VSS rail. Two 1 um M3 drops bring
    VDD down from the top rail over the inverter cluster (no Metal4). The decap moves up
    0.88 um and the DAC right 0.6 um: the core is 69.69 x 52.77 um (was 69.09 x 51.88).
    check_v3.sh: magic + KLayout DRC 0, antenna 0 (6 feedback, the decap fingers, now on VDD),
    LVS vs xschem PASS. A new mutation (decap S/D on VSS) is caught, along with the other two.
    xschem/gen/check.py: CHECK OK.
    Claude-Se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
    [ring_core_v3.sch]
2026-11-12 vg decap to VDD: keep every core y, vco_top re-assembled
    The PMOS decap is now 6 x 29.82/4.12 um (the same 737 um2): its n+ tap strip fits under
    it without moving anything above, so the core's vbn still meets cgm_ref's vbnf at the same
    y. The DAC side moves +1.0 um in x (n-well 0.43 um from the DAC's p+ rails). The core is
    70.09 x 51.88 um and vco_top is 407.68 x 70.80 um (CORE_DX in vco_top.py).
    check_v3.sh and check_top.sh: CHECK OK (DRC, KLayout DRC, antenna, LVS, mutations).
    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
    [ring_core_v3.sch]
2026-11-12 vg decap to VDD, phase 3: tile and re-extraction
    tt_wrapper.py: CORE_DX for every vco_top x from the core's DAC rightwards (bit, vg and vbnf
    risers, VDD/VSS straps, cgm_ref pins). The macro's left tile edge moves from 297.0 to 296.0 um,
    and the ua[0]/ua[1] risers move 1 um left with it (vctrl M3 at x 294.8).
    check_tt.sh: LVS PASS, resistor sizes PASS, 7 mutations caught. Tile magic DRC 0, antenna 0,
    KLayout DRC 8 x DCF.1a only (fill; the same 8 as before).
    vco_top re-extracted with magic 8.3.642 (c, rc -> rcfix -> rcx): six pfet_03v3
    29.82/4.12 decap fingers on VDD/vg; vg's parasitic C now 23.7 fF to VDD, 14.3 fF to VSS.
    Claude-Session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
2026-11-12 vg decap: move the left M3 VDD drop off the ring wiring
    The drop at x 1 um ran over a0's edge tap and the ring rows: +0.17 fF on a0 and +0.05 fF
    on a1 (to VDD), about -0.3 % of f on the extracted vco_top (c1). Both drops are now right
    of the ring wiring (x 21.4 and 27.4 um, the ring wiring ends at 13.6 um). Ring-node C is
    back to the NMOS-decap layout's within 0.01 fF (a0 5.83 fF in vco_top). vg resistance is
    unchanged (8.0-8.2 ohm to the decap, 12.6-13.0 to the DAC; vg_res_v3.py now finds the PMOS
    decap). check_v3, check_top and check_tt: CHECK OK. Core and vco_top re-extracted (magic
    8.3.642), and the tile regenerated.
    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
2026-11-12 sims on the PMOS-decap layout: vco_top_c's vbnf port, vg_decap pex on the real netlists
    The re-extracted vco_top_c.spice exports vbnf as a 20th port (pex_top.sh has done so since
    the medium DAC work; the committed _c predated it). top_pex.pex_file() includes a copy with
    that port dropped, so tb_tx_top.py and top_pex.py keep probing v(xtop.vbnf).
    vg_decap.py pex: the committed netlists are the new case and the last NMOS-decap extraction
    (git 48d9cb6) is 'today'; --run all|pmos|none.
    Docs: ring_layout_v3 (decap, area, vg R, checks), top_layout (407.7 um, cgm_ref x),
    schematics (PMOS decap, the third mutation).
    Claude-Session: https://cla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
2026-11-12 docs: the -0.1 % f shift of the re-drawn layout is not pursued (the RP2350 servo tunes absolute f)
    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
2026-11-12 STATUS: option C (fine tuning and FSK) complete; TX driver harmonics still open
    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
2026-11-13 platform: VAPWR and VDPWR are separate on chip, both 3.3 V on the demo board; analog-on-VAPWR option
    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
